rashadrahimzade/Smart-Viscosity-Measurement-and-Control-System-VYTRON/docs/mechanical/mechanical-design.md

# 📐 Mechanical Design & Fluid Dynamics

This directory contains the 3D CAD assemblies, STEP models, technical drawings, and fluid mechanics calculations for the VYTRON system.

## 1. Core Mechanical Features

### 3D CAD Modeling
- Full 3D assembly modeled and verified in **SolidWorks**.
- Neutral **STEP (.step)** format included for universal CAD cross-compatibility.

### Fluid Dynamics & Sealing System
- Hydrodynamic design strictly based on **Stokes' Law** for falling-ball viscometry.
- Wall-effect boundary correction factors integrated into system calibration.
- Custom-engineered sealing channels utilizing **NBR O-Rings** and **Viton (FKM)** seals for zero-leakage fluid containment and high chemical resistance.
