rashadrahimzade/Smart-Viscosity-Measurement-and-Control-System-VYTRON/docs/use-cases/academic-lab.md

# 🎓 Use Case: Academic Laboratories

Used in university and R&D laboratories for research, student experiments, and thesis studies.

## 1. Application Areas

| Usage Purpose | Description |
|---|---|
| Stokes' Law experiment | Demonstration of falling-ball viscometer principle |
| Viscosity-temperature relationship | Research on liquid viscosity change at different temperatures |
| Calibration study | System validation with reference fluids |
| Student project | Mechatronics, industrial engineering, chemical engineering experiments |

## 2. VYTRON Advantages

- **Open code and open hardware**: All firmware, CAD, and schematic files are modifiable and learnable.
- **Dual-MCU architecture**: Arduino Mega and Nano communication is ideal for teaching embedded systems to students.
- **TÜBİTAK 2209-A support**: Suitable reference system for academic projects.
- **Bilingual (TR/EN)**: Turkish and English interface, usable in international environments.
- **Low cost**: Suitable for university budgets.

## 3. Limitations

- Data logging (SD card / PC connection) is not yet available; manual note-taking required.
- No factory calibration certificate; user must perform own calibration.

## 4. Related Files

- `docs/getting-started.md` — Initial setup and first run
- `docs/assembly-guide.md` — Mechanical assembly
- `docs/software/software-architecture.md` — Software architecture
- `docs/cfd/cfd-analysis.md` — Flow analysis (reference for research)
