rashadrahimzade/Smart-Viscosity-Measurement-and-Control-System-VYTRON/docs/use-cases/food-industry.md

# 🍯 Use Case: Food Industry

The VYTRON falling-ball viscometer can be used in the food industry for viscosity control of liquids and semi-liquids.

## 1. Application Areas

| Product | Important Viscosity Range | Why Important |
|---|---|---|
| Olive oil | ~30–100 cP | Quality classification and storability |
| Honey | ~2000–10000 cP | Liquefaction rate and adulteration detection |
| Syrup | ~100–1000 cP | Concentration and filling speed control |
| Sauces (ketchup, mayonnaise) | ~500–5000 cP | Flow behavior and packaging |
| Milk and dairy products | ~1–10 cP | Concentration and quality |

## 2. VYTRON Advantages

- **NBR O-ring and Viton gasket**: Food-contact parts are chemically compatible and leak-proof.
- **Bilingual interface (TR/EN)**: English interface provides advantage for exporting companies.
- **Temperature control**: Heater and DS18B20 allow measuring liquid at desired temperature (food viscosity is highly temperature-sensitive).
- **Low cost**: Suitable price for small and medium-sized food businesses.

## 3. Limitations

- Food-contact parts may require food-grade material certification.
- All parts must comply with food industry hygiene standards (HACCP, etc.).

## 4. Related Files

- `docs/calibration.md` — Reference fluid calibration
- `docs/safety.md` — Heater and 220V safety
- `docs/mechanical/mechanical-bom.md` — Gaskets and sealing materials
