rashadrahimzade/Smart-Viscosity-Measurement-and-Control-System-VYTRON/docs/use-cases/pharma.md

# 💊 Use Case: Pharmaceutical Industry

Viscosity is used in drug formulations (syrups, gels, creams, suspensions) for dosage and stability control.

## 1. Application Areas

| Product | Viscosity Range | Importance |
|---|---|---|
| Drug syrups | ~100–1000 cP | Filling speed and dosage |
| Gel creams | ~1000–10000 cP | Spreadability and stability |
| Suspensions | ~500–5000 cP | Liquefaction and homogeneity |

## 2. VYTRON Advantages

- **Precise temperature control**: Drug viscosity is highly temperature-sensitive; measurement can be performed at target temperature.
- **Open calibration**: Can be calibrated with reference drug solutions to obtain repeatable results.
- **Language support**: Turkish interface, easy to use for local laboratories.
- **Low cost**: Suitable price for small-scale pharmaceutical R&D laboratories.

## 3. Limitations

- Compliance with GMP (Good Manufacturing Practices) standards may require additional documentation and validation.
- All contact surfaces must be made of drug-compatible materials.

## 4. Related Files

- `docs/calibration.md` — Reference fluid calibration
- `docs/safety.md` — Heater safety
- `docs/bom/bom-index.md` — Material list
