rashadrahimzade/Smart-Viscosity-Measurement-and-Control-System-VYTRON/Mechanical/CFD_Analysis/Force Report - Data.xlsx

Column1 | Column2 | Column3 | Column4 | Column5 | Column6 | Column7
Forces - Direction Vector (0 0.939693 0.34202)
Zone | Forces [N] Pressure | Forces [N] Viscous | Forces [N] Total | Coefficients Pressure | Coefficients Viscous | Coefficients Total
bilye | 8932811 | 21721961 | 11105007 | 14584181 | 35464426 | 18130624
Net | 8932811 | 21721961 | 11105007 | 14584181 | 35464426 | 18130624
