rashadrahimzade/Smart-Viscosity-Measurement-and-Control-System-VYTRON/docs/tubitak/sonuc-raporu.md

# 📄 TÜBİTAK 2209-A Result Report

This folder contains the result report prepared within the scope of the TÜBİTAK 2209-A University Students Research Projects Support Program.

## 📎 File

| File | Description |
|---|---|
| `1919B012431971_Sonuc_Raporu.pdf` | TÜBİTAK 2209-A result report (PDF) |

> **Note:** The PDF file (`1919B012431971_Sonuc_Raporu.pdf`) is available in this repository.

## 🔗 Related Links

- [TÜBİTAK 2209-A Program Page](https://www.tubitak.gov.tr/tr/fon/bireysel-ve-kurumsal-burslar/2209-a-universite-ogrencileri-arastirma-projeleri-destekleme-programi)
- Project Article: [`docs/tubitak/makale.md`](./makale.md)
- Article (Publisher Site): [lubricant-world.com](https://lubricant-world.com/tribology-applications-a-mechatronics-assisted-approach-to-traditional-viscometers/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)

## 📜 License

This report is protected under the "All Rights Reserved" terms specified in `LICENSE.txt`. Unauthorized copying or distribution is prohibited.
