rashadrahimzade/Smart-Viscosity-Measurement-and-Control-System-VYTRON/Mechanical/Mechanical Calculations/12.pdf

### 2.3 Mukavemet hesapları 2.3.1 Mil Makine Elemanın Mukavemet Kontrolü

Genel pazar araştırmalarının ve malzeme mekanik özellikleri incelemelerinin sonucunda mil malzemesi olarak mukavemet ve hafiflik bakımından daha avantajlı bir malzeme olan Alüminyum 7075 T6 alaşımı seçilmiştir. Söz konusu mil malzemesinin teknik özellikleri Tablo 2.’de verilmiştir. Milimiz her iki tarafından yataklanmıştır ve kuvvet Milin tam orta noktasından etki etmektedir. Kuvvetin büyüklüğü ise F = 38.26 N olarak hesaplanmıştır. Mile etki eden kuvvet ve mile ait boyutlar Şekil 28.’de verilmiştir.

Tablo 2. Mil Malzemesinin Özelikleri (Al 7075 T6)

Malzeme Özelliği | Büyüklük
Elastisite Modülü | 71.7 Gpa
Kayma Modülü | 26.9 Gpa
Poisson Oranı | 0.33
Akma Dayanımı | 60Mpa
Yoğunluğu | 2.81 g/cm³
Çekme Dayanımı | 572Mpa

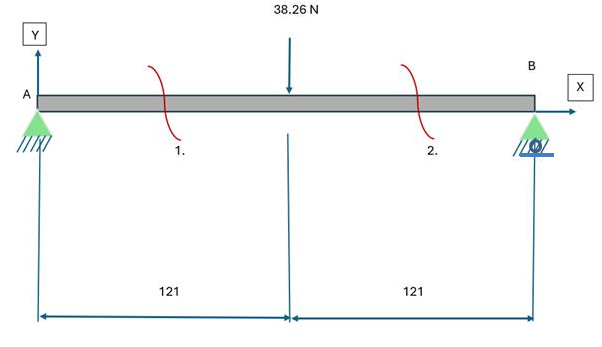
[picture p8: figure]

Şekil 29. Mil Üzerine Gelen Kuvvetler ve Mesnetler.

Analitik çözümde malzeme homojen, malzeme Hooke yasasına uyduğu, malzeme izotropik özellikte olduğu kabul edilmiştir. Newton’ un birinci yasası uygulandığında, mesnet kuvvetleri aşağıdaki gibi hesaplanır.
ΣFx = 0 => Ax + Bx = 0
ΣFy = 0 => Ay + By − 38.26 = 0 => Ay + By = 38.26 N
ΣMA = 0 => 38.26 ∗ 121 − By ∗ 242 = 0
=> By = 19.13 N
Ay = 19.13N

Mesnet tepki kuvvetleri bu şekilde bulunmuş olundu. Sistemde eksenel kuvvet bulunmamaktadır. Tek tek kesit aldığımız zaman her bir bölgedeki kuvvet, moment değerleri aşağıda ayrı ayrı hesaplanmıştır. Mildeki kesme kuvveti ve tepki kuvvetleri için bölgesel inceleme yapılmıştır. Mil bölgesel olarak kestiğimizde, tek tek kesit aldığımız zaman her bir bölgedeki kuvvet, moment değerleri aşağıda ayrı ayrı hesaplanmıştır (Şekil 29-31). Ayrıca MTV diyagramları da Şekil 32.’de verilmiştir.

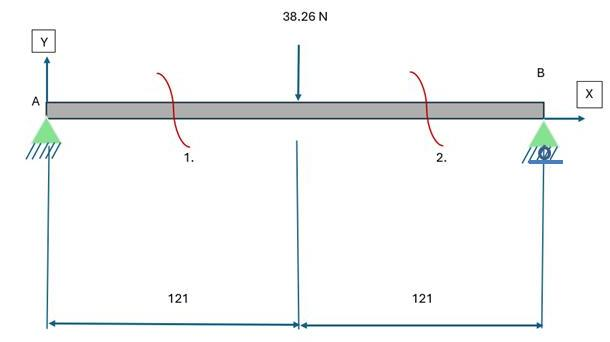
[picture p9: figure]

Şekil 30. Kesit Alınmış Mesnet Görseli.

### 1. Kesitin (0 ≤ x ≤ 121) İncelenmesi

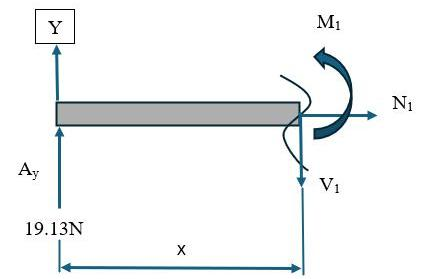
[picture p10: figure]

Şekil 31. 1 nolu Kesitin İncelenmesi.

Newton’un Birinci Yasası Uygulandığında;

ΣFx = 0 => N1 = 0
ΣFy = 0 => Ay = V1 = 19.13 N
ΣMx = 0 => Ay ∗ x − M1 = 0 => => M = 19.13x
x = 0 => M1 = 0
x = 121 => M1 = 2314.73 Nmm

Kesitin (250 ≤ x ≤625) İncelenmesi

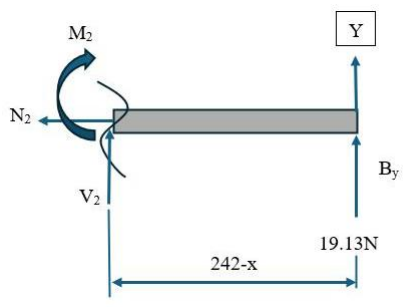
[picture p11: figure]

Şekil 32. 2 nolu Kesitin İncelenmesi.

Newton’un İkinci Yasası Uygulandığında;

ΣFx = 0 => N2 = 0
ΣFy = 0 => By + V2 = 0
=> V2 = −19.13N
ΣMx = 0 => M2 − By ∗ (242 − x) = 0 => M2 = 19.13 ∗ (242 − x) M2 = 4629.46 − 19.13 ∗ x
x = 121 => M2 = 2314.73 Nmm
x = 242 => M2 = 0 Nmm

MTV Diyagramı ise:

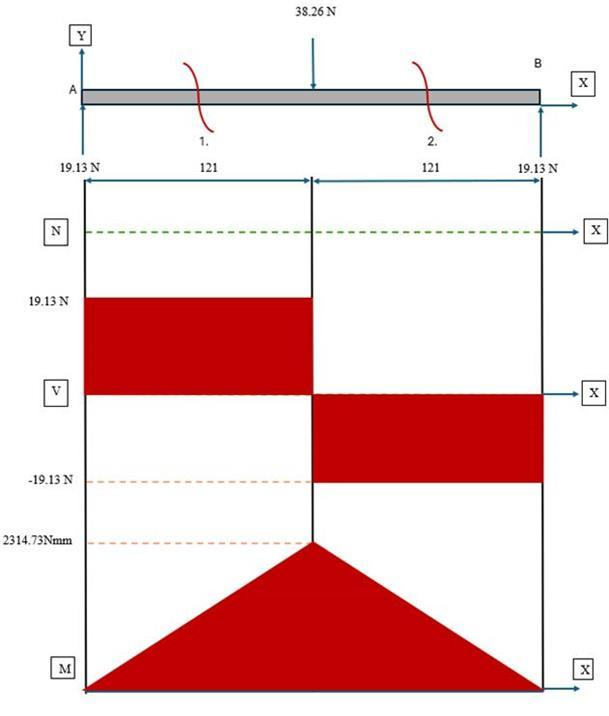
[picture p12: figure]

Şekil 33. MTV diyagramının gösterilişi.

Çizilen MTV diyagramında Mmax = 2314.73 Nmm ve Vmax = 19.13 N olduğu görülmektedir. Md momenti ise motordan gelen momenttir ve 2443 Nmm olarak alınmıştır. Bu değerler göz önünde bulundurularak milin emniyet hesabı yapılacaktır. Mil malzemesi olarak AL 7075 T6 alaşımı alındı. Bu alaşımın akma dayanımı değeri σakma= 60 MPa olarak alındı. Emniyet katsayısı S = 2 seçildi.(Tablo 3.)

Tablo 3. Emniyet Katsayısının Seçilmesi. [10]

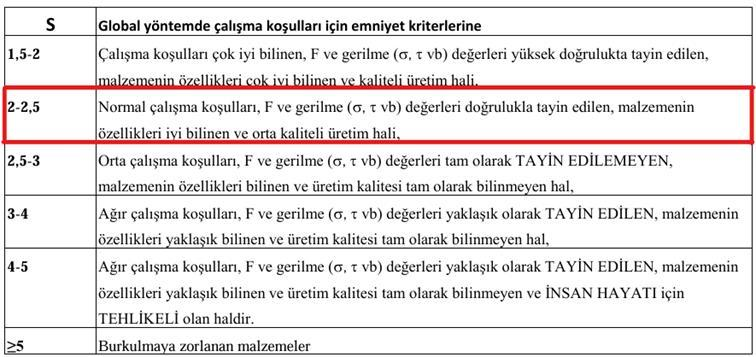
[picture p13: figure]

Milde oluşan eğilme ve kesme gerilmesi hesaplandıktan sonra bileşik gerilme ise

σeğilme =

Me
We

=

Me
π ∗ d

3
32

=

2314.73
π ∗ 12³
32

= 13.64 MPa

τkesme =

V
A

=

19.13
π ∗ 12²
4

= 0.17 MPa

τb =

Md
Wb

=

2443
π ∗ 12³
16

= 7.2 MPa

σem =

σak
S

=

60
2

= 30 MPa

σem = √σ
2 + 3 ∗ τ

2

σem = √13.64² + 3 ∗ (7.2 + 0.17)
2 = 18.68 MPa

şeklinde hesaplandıktan sonra 18.68 MPa < 30 MPa olduğu için Emniyetlidir. [10]

### 2.3.2 Rulman Hesabı

Projede mili desteklemek için UCP201 tipi rulman kullanılmıştır. UCP201 Rulman Özellikleri; Dökme demir gövde, kromlu çelik rulman, UCP201 model ve 12 mm mil

çapında olup 2 cıvatalı sabitlenerek montaj yapılmıştır (Şekil 33). Rulmanda iki taraflı yağ keçesi olan sızıdırmazlık eleman kullanılmıştır. Rulman ait teknik özellikler Tablo

4.’te verilmiştir.

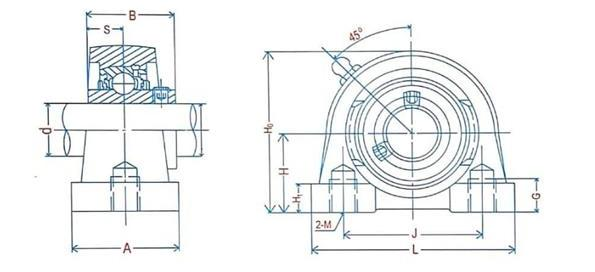
[picture p14: figure]

Şekil 34. UCP201 Rulman Teknik Resmi.

Tablo 4. UCP201 Rulman Özellik Tablosu. [10]

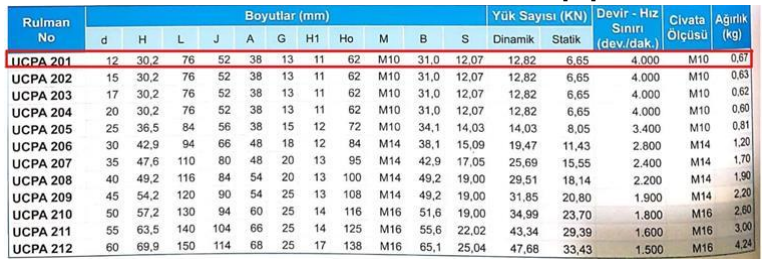
[picture p15: figure]

Hesaplarda kullanılacak büyüklükler Tablo 4’ ten C = 12.8 kN, C0 = 6.65 kN, Fe = 0 (Eksenel kuvvet bulunmuyor.) olarak seçilmiştir.

Fr
2

= Fra = Frb = 19.13N

Bilyeli için P = 3

L = (

C
F

)

P

L = (

12800
19.13 )

3
= 299560811.8 milyon devir

Lℎ =

10⁶

60∗n

(

C
F

)

P
n (devir) = 306.9 devir/dakika olarak alınmıştır.

=> Lℎ =

10⁶
∗ 2999560811.8
60 ∗ 306.9

= 1.626 ∗ 10¹⁰ çalışma saati

Hesaplamalar sonucunda UCP201 rulmanın proje için oldukça uygun olduğu görülmüştür. [10]

### 2.4 Tahrik Gücü Hesaplamaları 2.4.1 Motor Seçimi

Hesaplamalar statik durum üzerinden yapılacaktır. Mil malzemesi olarak Al 7075 T6 alaşımı seçilmişti. Bu alaşımın akma dayanımı değeri σakma=60 MPa olarak seçilmiştir. Hesaplarda bu değer kullanılacaktır. Tablo 3.’ten S = 2 seçilmiştir.
Eğilme gerilmesi;

σemax =

Me
We

σemax =

F ∗ L
π ∗ d

3
32

σemax =

38.26 ∗ 121
π ∗ 12³
32

= 27.28 MPa

σem =

σak
S

σem =

60
2

= 30 MPa

σem = √σ
2 + 3 ∗ τ

2

σem

2 = σ

2 + 3 ∗ τ

2

τ

2 =

σem

2 − σ

2
3
τ = √
σem

2 − σ

2
3
τ = √
30² − 27.28²
3

= 7.2 MPa

τem =

Md
Wb

=

Md
π ∗ d

3
16

=> Md = τem ∗

π ∗ d

3
16 = 7.2 ∗

π ∗ 12³
16 = 2.443 NmMd = 9550 ∗

N
n
n = 306.9 RPM seçilmiştir.

2.443 = 9550 ∗

N
n
=> N = 78.5 W

Bu güç ve döndürme momentine uygun olan motor olarak Nema 34 motor seçilmiştir[10]. Motora ait teknik özellikler Tablo 5.’te verilmiştir.
