rashadrahimzade/Smart-Viscosity-Measurement-and-Control-System-VYTRON/docs/images/Comparative Viscosity-Temperature Curve.png

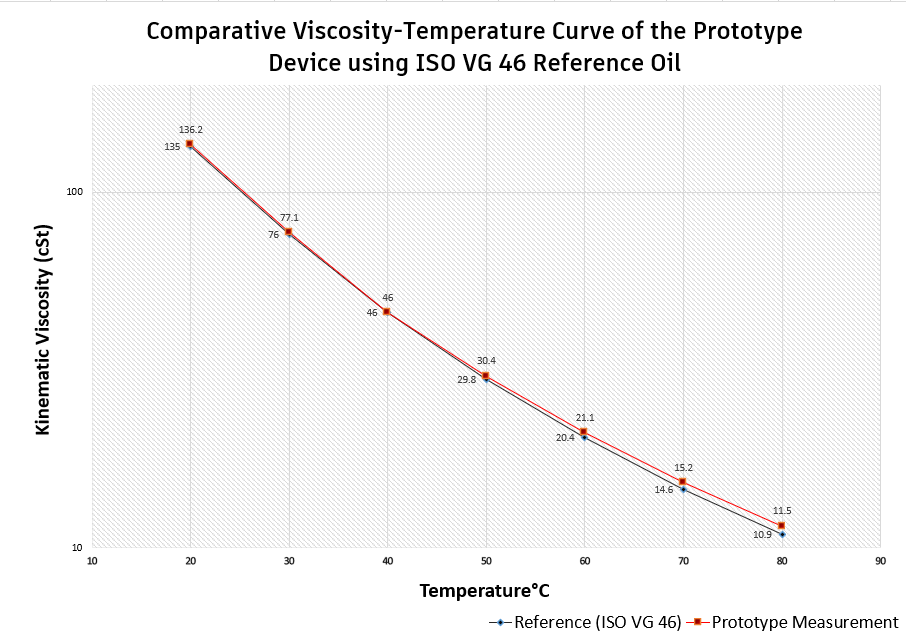
docs/images/Comparative Viscosity-Temperature Curve.png
