rashadrahimzade/Smart-Viscosity-Measurement-and-Control-System-VYTRON/docs/images/Do not touch sign.jpeg

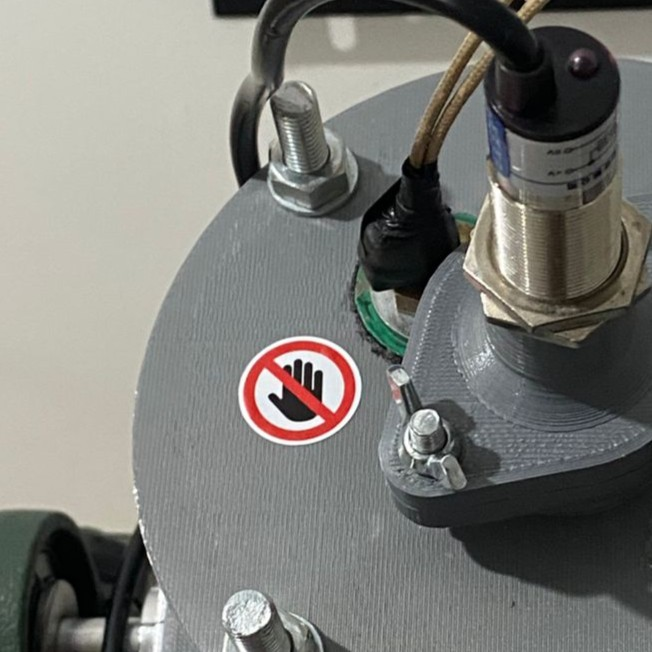
docs/images/Do not touch sign.jpeg
