rashadrahimzade/Smart-Viscosity-Measurement-and-Control-System-VYTRON/docs/images/Drag_Force_Convergence_Monitor.jpg

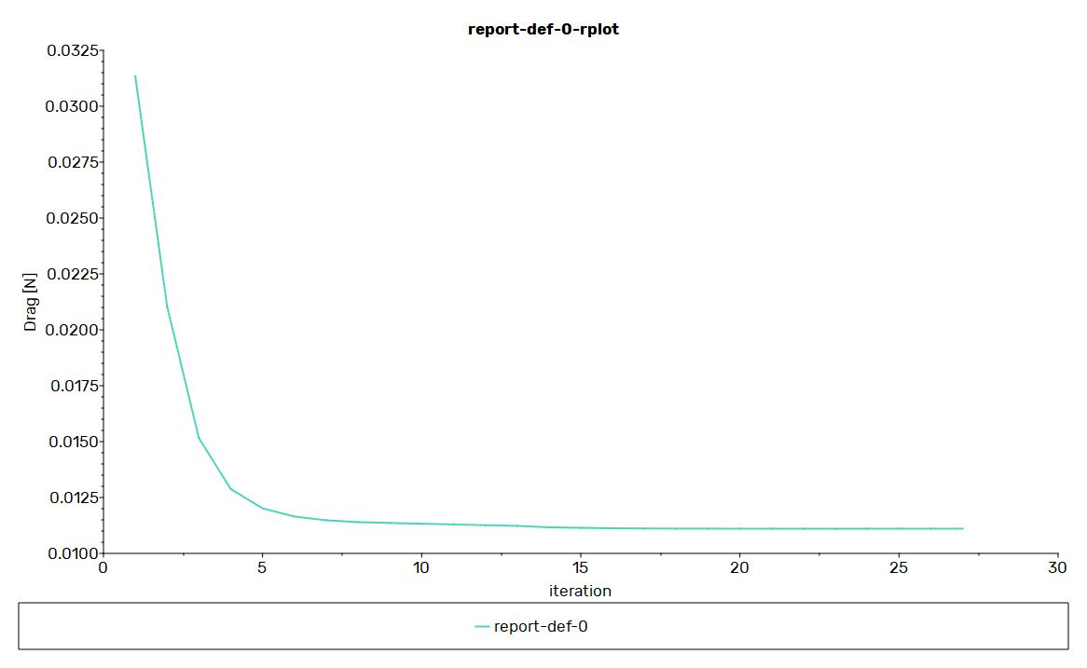
docs/images/Drag_Force_Convergence_Monitor.jpg
