rashadrahimzade/Smart-Viscosity-Measurement-and-Control-System-VYTRON/docs/images/Ladenburg Factor Calculations-1.png

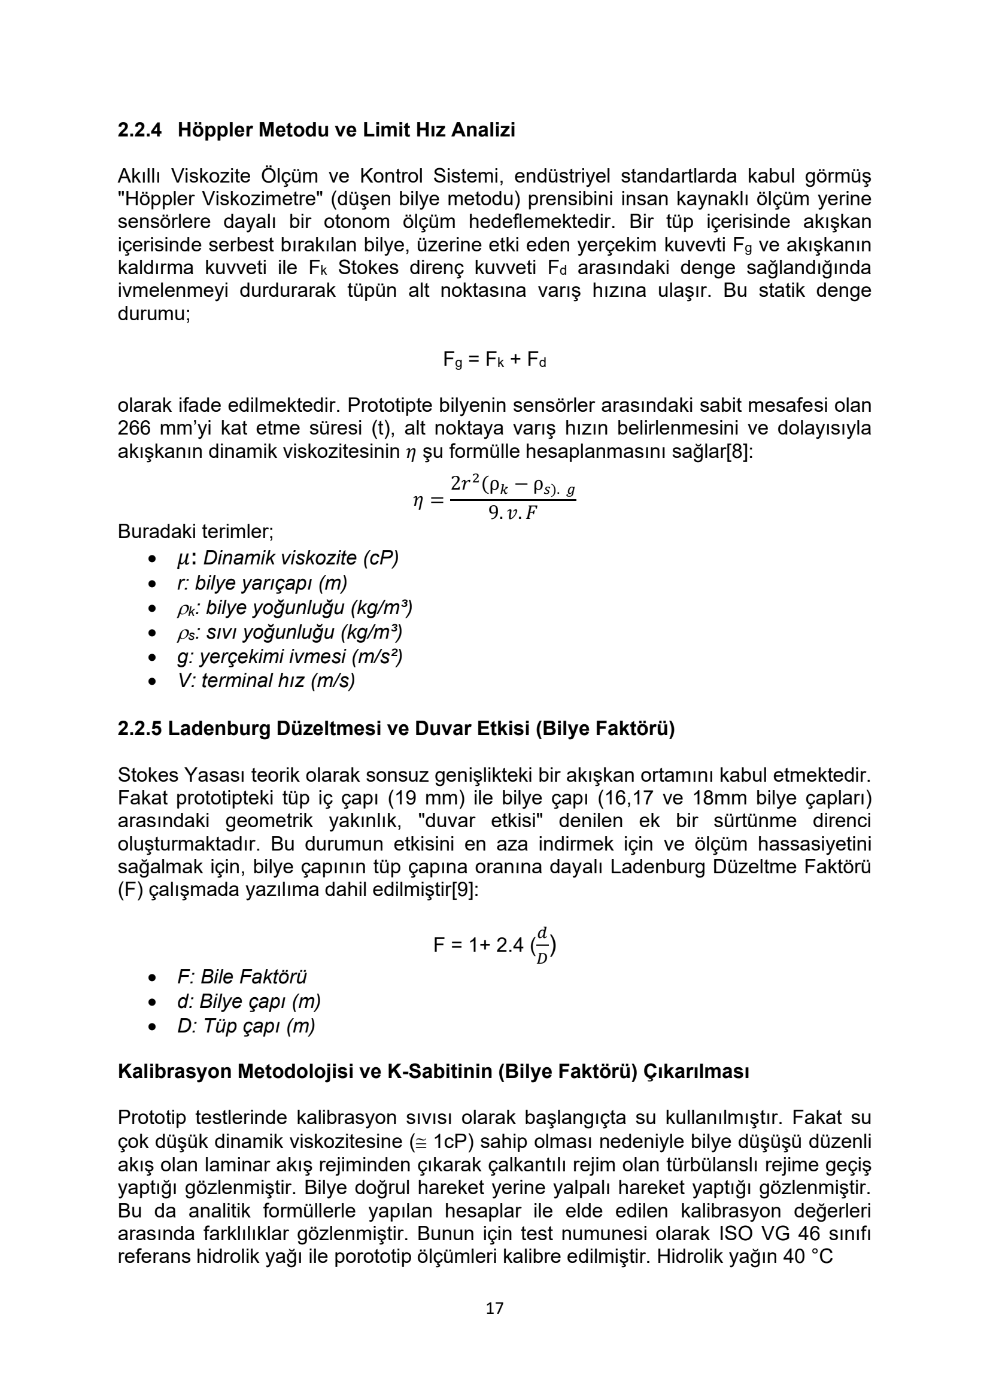
docs/images/Ladenburg Factor Calculations-1.png
