rashadrahimzade/Smart-Viscosity-Measurement-and-Control-System-VYTRON/docs/images/Laminar_Flow_Continuous_Pathlines.png

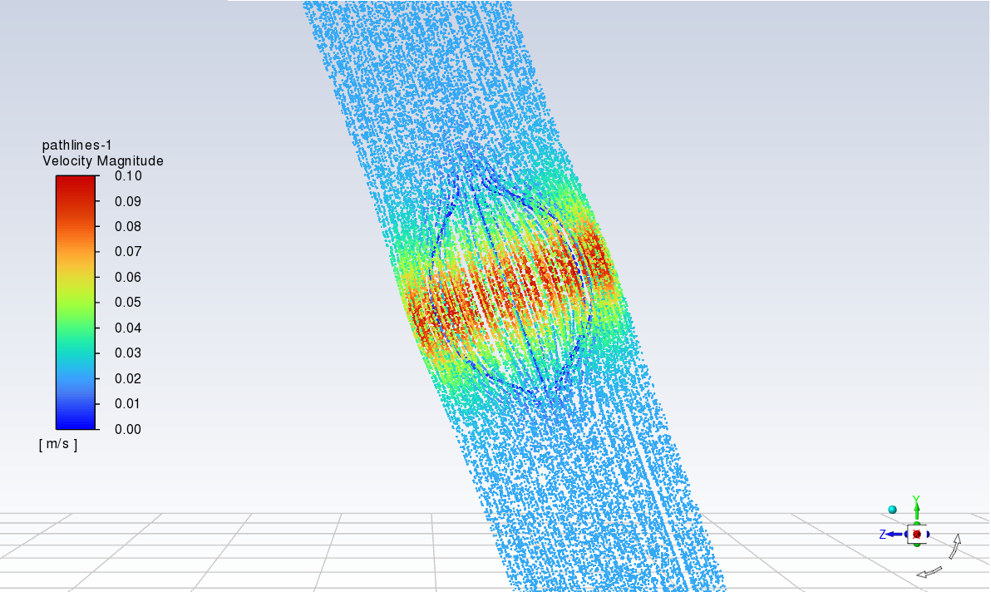
docs/images/Laminar_Flow_Continuous_Pathlines.png
