rashadrahimzade/Smart-Viscosity-Measurement-and-Control-System-VYTRON/docs/images/Pathline Coloured.png

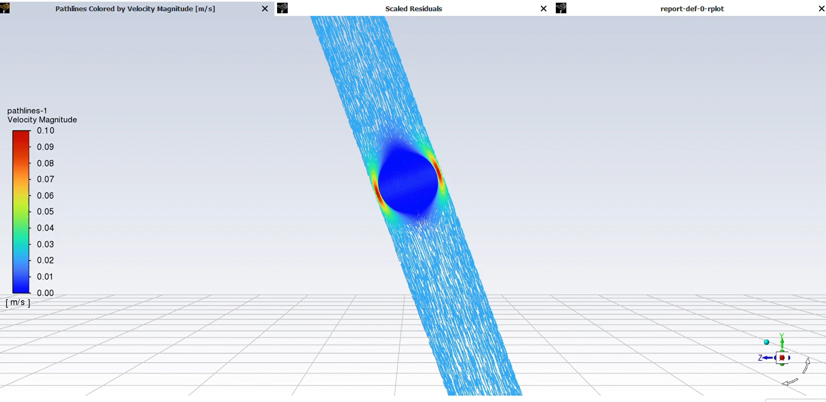
docs/images/Pathline Coloured.png
