rashadrahimzade/Smart-Viscosity-Measurement-and-Control-System-VYTRON/docs/images/Solver_Scaled_Residuals.jpg

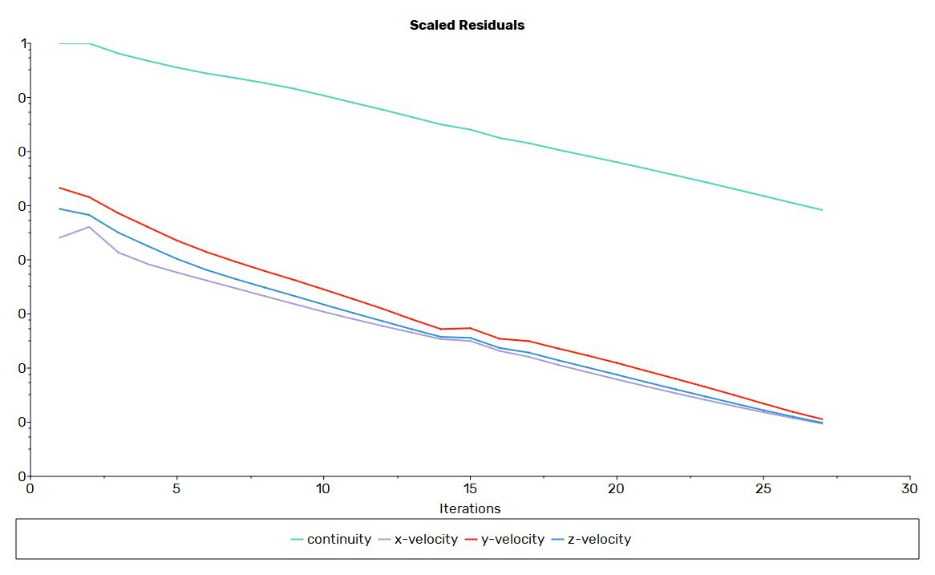
docs/images/Solver_Scaled_Residuals.jpg
