rashadrahimzade/Smart-Viscosity-Measurement-and-Control-System-VYTRON/docs/images/Static_Pressure_Distribution_CFD.jpg

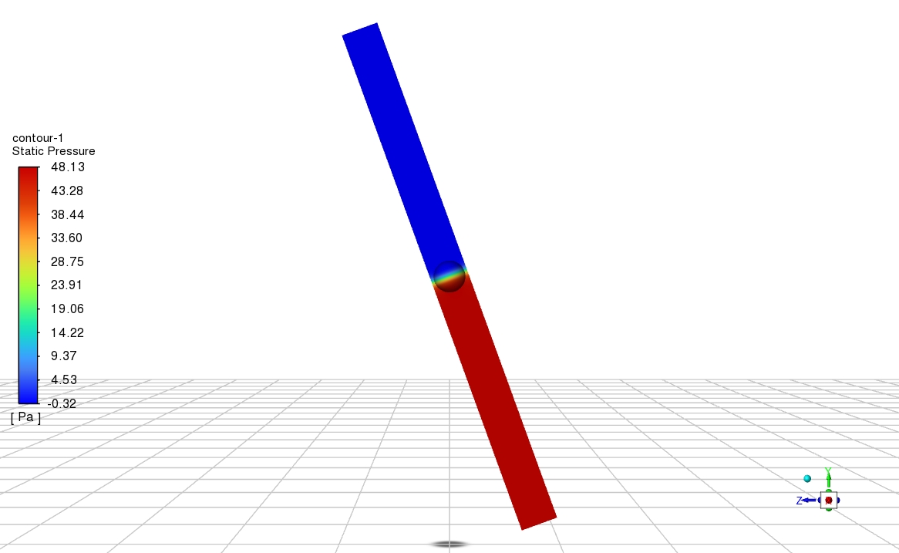
docs/images/Static_Pressure_Distribution_CFD.jpg
