rashadrahimzade/Smart-Viscosity-Measurement-and-Control-System-VYTRON/Electronics/Detail_of_Parts/Electronic Control Unit.jpeg

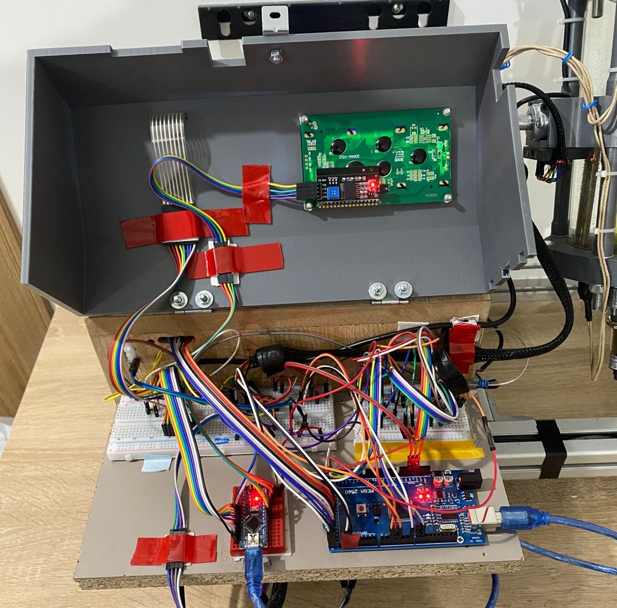
Electronics/Detail_of_Parts/Electronic Control Unit.jpeg
