rashadrahimzade/Smart-Viscosity-Measurement-and-Control-System-VYTRON/Electronics/Interference_Mitigation/4.7K Resistance on Heater circuit.png

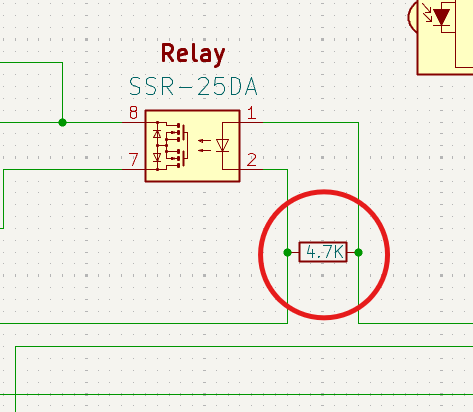
Electronics/Interference_Mitigation/4.7K Resistance on Heater circuit.png
