rashadrahimzade/Smart-Viscosity-Measurement-and-Control-System-VYTRON/Electronics/Interference_Mitigation/Aluminyum Shielded Cable.jpeg

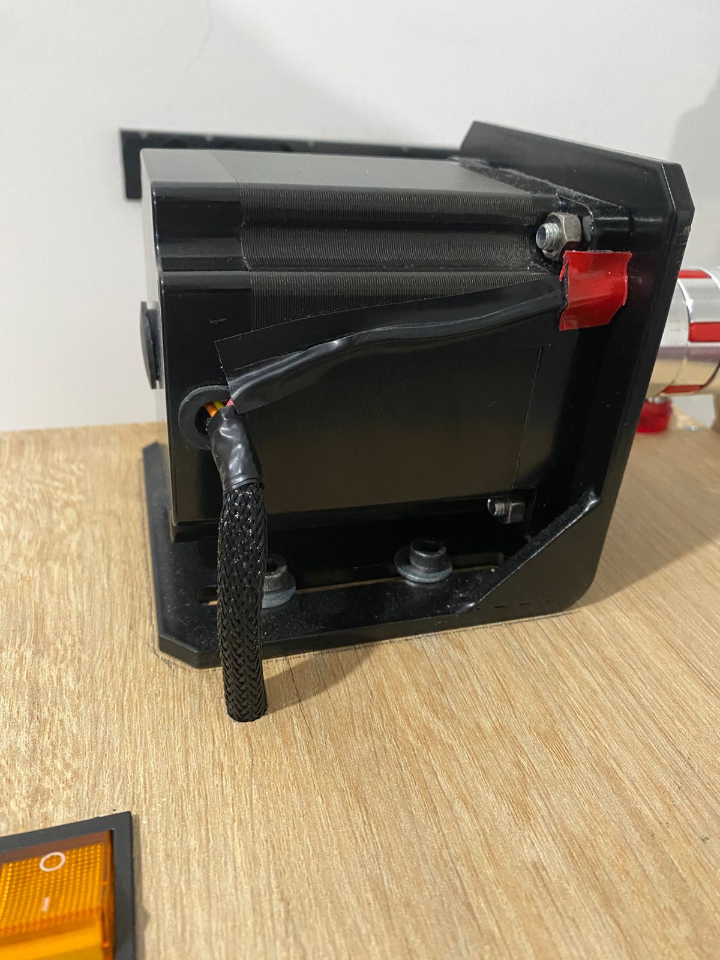
Electronics/Interference_Mitigation/Aluminyum Shielded Cable.jpeg
