rashadrahimzade/Smart-Viscosity-Measurement-and-Control-System-VYTRON/Electronics/Interference_Mitigation/Aluminyum Shielded Cablo on IMU.jpeg

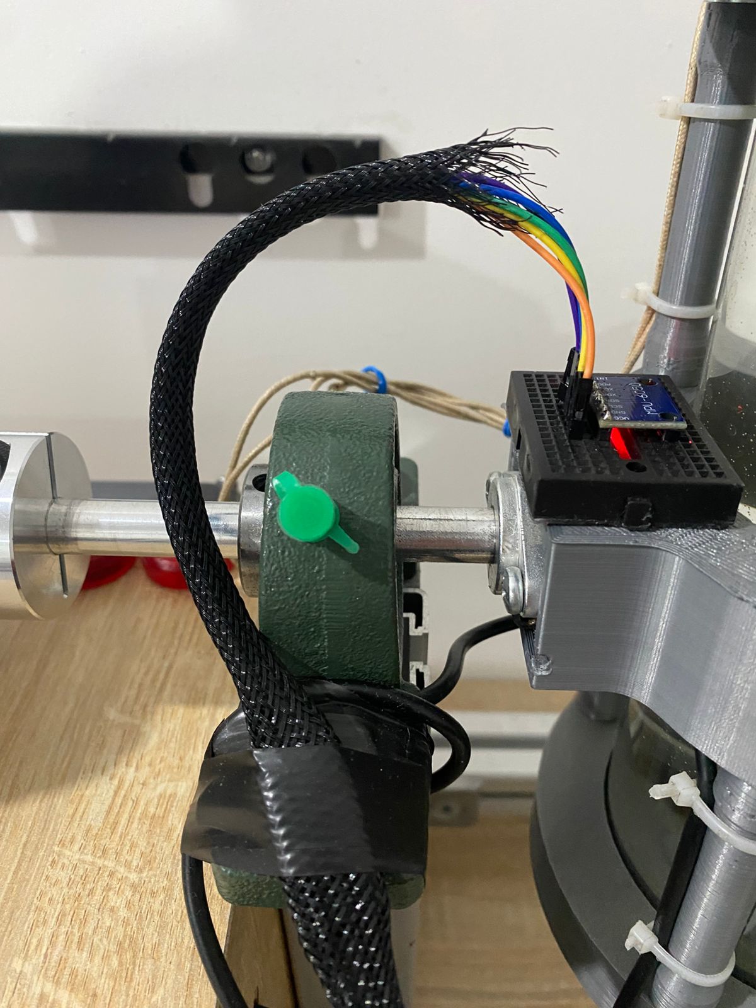
Electronics/Interference_Mitigation/Aluminyum Shielded Cablo on IMU.jpeg
