rashadrahimzade/Smart-Viscosity-Measurement-and-Control-System-VYTRON/Electronics/Interference_Mitigation/Ferrite core application on the MPU-6050 sensor and aluminum shielded cabling..jpeg

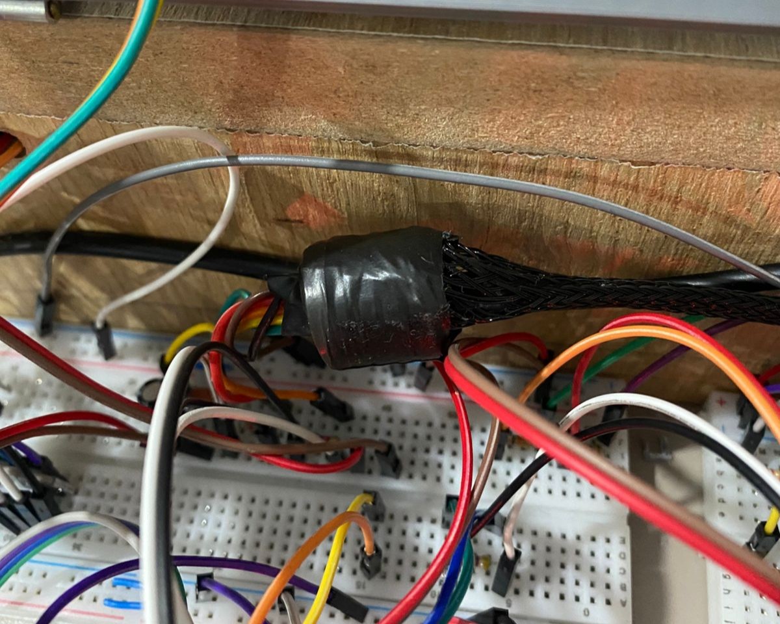
Electronics/Interference_Mitigation/Ferrite core application on the MPU-6050 sensor and aluminum shielded cabling..jpeg
