rashadrahimzade/Smart-Viscosity-Measurement-and-Control-System-VYTRON/docs/bom/files/README.md

# 📁 Excel Files

Add your actual BOM (material list) Excel files to this folder.

> **Note:** File names may differ from the example below. Please update the links in `docs/bom/bom-index.md` if your file names are different.

| File | Description | Location |
|---|---|---|
| `BOM_Electronic_VYTRON.xlsx` | Electronic parts BOM | `docs/bom/files/BOM_Electronic_VYTRON.xlsx` |
| `BOM_Mechanic_VYTRON.xlsx` | Mechanical parts BOM | `docs/bom/files/BOM_Mechanic_VYTRON.xlsx` |

**Price note:** All prices in the Excel files are **VAT included, May 2026 prices**.
