rashadrahimzade/Smart-Viscosity-Measurement-and-Control-System-VYTRON/docs/bom/electronics-bom.md

# ⚡ Electronic Material List (BOM)

For the detailed electronic parts list, see the Excel file in `docs/bom/files/`:

- **File:** `BOM_Electronic_VYTRON.xlsx`
- **Location:** `docs/bom/files/BOM_Electronic_VYTRON.xlsx`
- **Price note:** VAT included, May 2026 prices

## 📎 Related Files

- KiCad Schematic: `Electronics/Smart Viscosity Measurement and Control System.kicad_sch`
- EMI/RFI Guide: `docs/electronics/interference-mitigation.md`
- Wiring Guide: `docs/wiring-guide.md`
