rashadrahimzade/Smart-Viscosity-Measurement-and-Control-System-VYTRON/docs/bom/mechanical-bom.md

# 🔩 Mechanical Material List (BOM)

For the detailed mechanical parts list, see the Excel file in `docs/bom/files/`:

- **File:** `BOM_Mechanic_VYTRON.xlsx`
- **Location:** `docs/bom/files/BOM_Mechanic_VYTRON.xlsx`
- **Price note:** VAT included, May 2026 prices

## 📎 Related Files

- Technical Drawings: `Mechanical/Techincal_Drawing/`
- 3D CAD Models: `Mechanical/3D Model/`
- Assembly Guide: `docs/assembly-guide.md`
- CFD Analysis: `docs/cfd/cfd-analysis.md`
