rashadrahimzade/Smart-Viscosity-Measurement-and-Control-System-VYTRON/docs/bom/bom-index.md

# 📦 Bill of Materials (BOM) - General Overview

This page contains a high-level summary of all materials required for the VYTRON system. For detailed part numbers, suppliers, and notes, see the sub-pages.

## 🔗 Sub-sections

| Section | Description | File |
|---|---|---|
| **Electronic Materials** | Arduino, sensors, motor, driver, screen, relay, cables | `docs/electronics/electronics-bom.md` |
| **Mechanical Materials** | CAD parts, gaskets, screws, glass tube, mounting parts | `docs/mechanical/mechanical-bom.md` |

## 📁 Excel Files

Actual part lists (Excel) are located in the `docs/bom/files/` folder:

| File | Description | Location |
|---|---|---|
| `BOM_Electronic_VYTRON.xlsx` | Detailed list of electronic parts | `docs/bom/files/BOM_Electronic_VYTRON.xlsx` |
| `BOM_Mechanic_VYTRON.xlsx` | Detailed list of mechanical parts | `docs/bom/files/BOM_Mechanic_VYTRON.xlsx` |

> **Price note:** All prices in the Excel files are **VAT included, May 2026 prices**.

## 💰 Approximate Costs (Example)

> These figures are 2026 averages; they may vary by supplier, country, and quantity. Each BOM table contains its own subtotal; there is no grand total for the entire machine.

| Category | Description |
|---|---|
| Electronics | MCU, sensors, motor, driver, screen, relay, cables |
| Mechanical | Gaskets, screws, glass tube, mounting parts |

## 🛒 Shopping List Checklist

Confirm before placing an order:

- [ ] Are all electronic parts in stock?
- [ ] Are NBR O-ring and Viton gaskets suitable for the liquid?
- [ ] Is the 4.7K pull-up resistor added for DS18B20?
- [ ] Is the stepper motor flange/coupling suitable for the tube diameter?
- [ ] Is 220V insulation material (box, shielded cable) purchased?

## 📬 Notes

- Part numbers (MPN) and supplier information should be kept up to date in sub-pages.
- Prices are for reference only; contact the supplier for an official quote.
- This list is linked with `docs/pricing.md` (cost analysis).
