rashadrahimzade/Smart-Viscosity-Measurement-and-Control-System-VYTRON/docs/bom/files/BOM_Electronic_VYTRON.xlsx

Part | Count | Unit Price | Total Price | Function
MS-600-48 | 1 | ₺1400.00 | ₺1400.00 | Step Motor's Power Supply
PowerBank 5V 10000mAh | 1 | ₺180.00 | ₺180.00 | Microcontrollers' Power Supply
12V Adapter ~220V | 1 | ₺30.00 | ₺30.00 | Proximirt Sensors' Power Supply
EuroWatt 200W | 2 | ₺1452.00 | ₺2904.00 | Screw Plug Immersion Heater
Schneider 10-C | 1 | ₺250.00 | ₺250.00 | Short-Circuit & Overcurrent Protection
SSR-25DA | 1 | ₺110.00 | ₺110.00 | Heater Control Relay
Nema 34 | 1 | ₺2600.00 | ₺2600.00 | Step Motor
JSS-860H | 1 | ₺1850.00 | ₺1850.00 | Step Motor Driver
Arduino Mega 2560 | 1 | ₺900.00 | ₺900.00 | Main Microcontroller
Arduino Nano | 1 | ₺250.00 | ₺250.00 | Step Motor's Microcontroller
4x20 LCD | 1 | ₺216.00 | ₺216.00 | Step Motor's info LCD
ILI9341 TFT LCD | 1 | ₺266.00 | ₺266.00 | Main LCD
I2C/IIC Converter | 1 | ₺60.00 | ₺60.00 | Converter for 4x20 LCD
LJ18A3-8-Z/AX | 2 | ₺120.00 | ₺240.00 | Enductive Proximity Sensor
4x4 Keypad | 2 | ₺10.00 | ₺20.00 | Keypad
MPU-6050 | 1 | ₺135.00 | ₺135.00 | IMU for Rotational Position
DS18B20 | 1 | ₺150.00 | ₺150.00 | Waterproof Temeprature Sensor
Switch | 1 | ₺60.00 | ₺60.00 | Step Motor On/Off
BreadBoard 830 Pin | 1 | ₺135.00 | ₺135.00 | Arduino Mega BreadBoard
BreadBoard 400 Pin | 1 | ₺60.00 | ₺60.00 | Arduino Nano BreadBoard
BreadBoard 170 Pin | 1 | ₺30.00 | ₺30.00 | MPU-6050's BreadBoard
Terminal x8 | 1 | ₺10.00 | ₺10.00 | Proximirt Sensors Terminal 12VDC
Terminal x7 | 1 | ₺10.00 | ₺10.00 | ~220VAC Terminal
Terminal x3 | 1 | ₺10.00 | ₺10.00 | ~220VAC Safe Terminal
Aluminium Tape | 2 | ₺50.00 | ₺100.00 | Protective cover
Jumper 40 Pin | 4 | ₺60.00 | ₺240.00 | Jumper
Resistor 2.2K | 7 | ₺1.00 | ₺7.00 | Resistor
Resistor 3.3K | 5 | ₺1.00 | ₺5.00 | Resistor
Resistor 4.7K | 2 | ₺1.00 | ₺2.00 | Resistor
Resistor 10K | 2 | ₺1.00 | ₺2.00 | Resistor
Seramic Capasitor | 2 | ₺5.00 | ₺10.00 | Interference suppressor
Electrolytic Capasitor | 2 | ₺5.00 | ₺10.00 | Interference suppressor
Double-Sided Nano Mounting Tape | 2 | ₺50.00 | ₺100.00 | Mounting
Ferrite Core x5 | 1 | ₺30.00 | ₺30.00 | Interference suppressor
Fiber Cover 1xM | 2 | ₺10.00 | ₺20.00 | Cover
TOTAL PRICE |  |  | $12402.00
