rashadrahimzade/Smart-Viscosity-Measurement-and-Control-System-VYTRON/docs/bom/files/BOM_Mechanic_VYTRON.xlsx

Parts | Count | Unit Price | Total Price
6063 Sigma Profile (3000mm) | 3 | ₺468.00 | ₺1404.00
DIN 7991 M8x20 Phosphate | 34 | ₺1.15 | ₺39.10
40x40 Flat Corner Bracket | 20 | ₺16.40 | ₺328.00
T-head M8 | 34 | ₺4.40 | ₺149.60
Wooden box | 7 Parts | ₺200.00 | ₺200.00
ABS Filament | 2 | ₺788.00 | ₺1576.00
M8 Threaded Rod 260mm | 4 | ₺50.00 | ₺200.00
M8 Nut | 12 | ₺2.00 | ₺24.00
M8 Flat Washer | 12 | ₺0.50 | ₺6.00
DIN 933 M10x40 Bolt | 4 | ₺3.00 | ₺12.00
DIN 933 M10x40 Nut | 4 | ₺3.00 | ₺12.00
DIN 912 M6x30 Bolt | 4 | ₺2.00 | ₺8.00
DIN 912 M6x30 Nut | 4 | ₺2.00 | ₺8.00
M5 Threaded Rod 40mm | 4 | ₺2.00 | ₺8.00
DIN 315 M5 Nut | 6 | ₺2.00 | ₺12.00
DIN 933 M5x25mm Bolt | 4 | ₺1.77 | ₺7.08
DIN 933 M5x25mm Nut | 4 | ₺1.77 | ₺7.08
DIN 965 M4 x 40 | 8 | ₺1.77 | ₺14.16
M4 Washer | 8 | ₺1.00 | ₺8.00
Nema 34 Stepper Motor Mounting Bracket | 1 | ₺251.00 | ₺251.00
GS19 Coupling - HRJ C40 | 1 | ₺670.00 | ₺670.00
UCP-201 Mounted Bearing | 2 | ₺215.00 | ₺430.00
SHF 12 Shaft Support | 2 | ₺62.00 | ₺124.00
Glass Tube Borosilicate 3.3 100x212mm | 1 | ₺1750.00 | ₺1750.00
Glass Tube Borosilicate 3.3 24x266mm | 1 | ₺250.00 | ₺250.00
KO-0329235 O-Ring | 2 | ₺5.00 | ₺10.00
KO-0234035 O-Ring | 2 | ₺5.00 | ₺10.00
Viton 95-100mm Sealing | 1 | ₺300.00 | ₺300.00
NBR Flat Washer Sealing | 4 | ₺1.00 | ₺4.00
Compressed Fiber Gasket | 4 | ₺2.00 | ₺8.00
Threaded Bushing | 1 | ₺150.00 | ₺150.00
AISI 52100 Steel Ball 16 mm | 1 | ₺60.00 | ₺60.00
AISI 52100 Steel Ball 17 mm | 1 | ₺60.00 | ₺60.00
AISI 52100 Steel Ball 18 mm | 1 | ₺60.00 | ₺60.00
6082 Aluminum Shaft 91mm | 1 | ₺120.00 | ₺120.00
6082 Aluminum Shaft 110 mm | 1 | ₺120.00 | ₺120.00
Control Panel Hinge | 2 | ₺90.00 | ₺180.00
TOTAL PRICE |  |  | ₺8580.02
