rashadrahimzade/Smart-Viscosity-Measurement-and-Control-System-VYTRON/Electronics/Detail_of_Parts/12 V Cable Distribution.jpeg

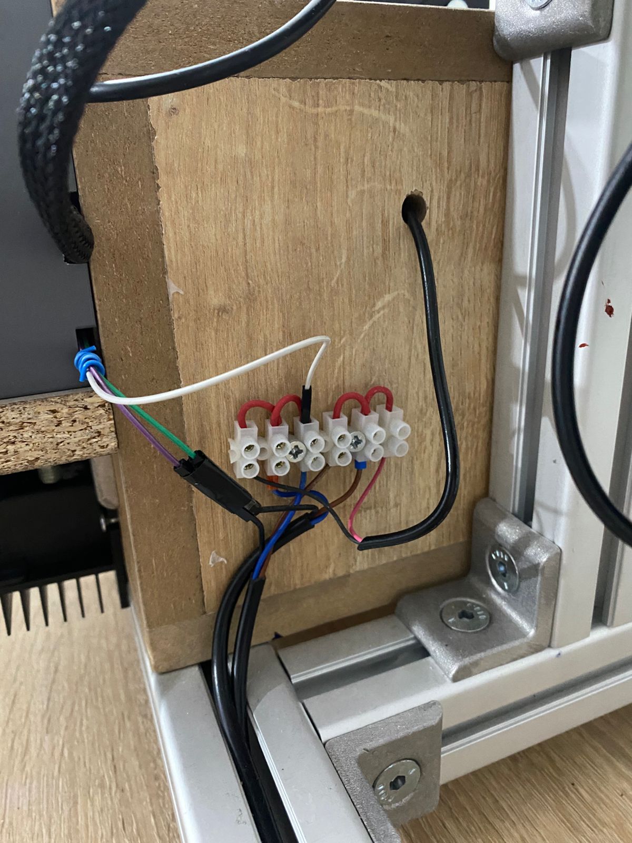
Electronics/Detail_of_Parts/12 V Cable Distribution.jpeg
