rashadrahimzade/Smart-Viscosity-Measurement-and-Control-System-VYTRON/Electronics/Detail_of_Parts/48V,12V supply and 10C FUSE .jpeg

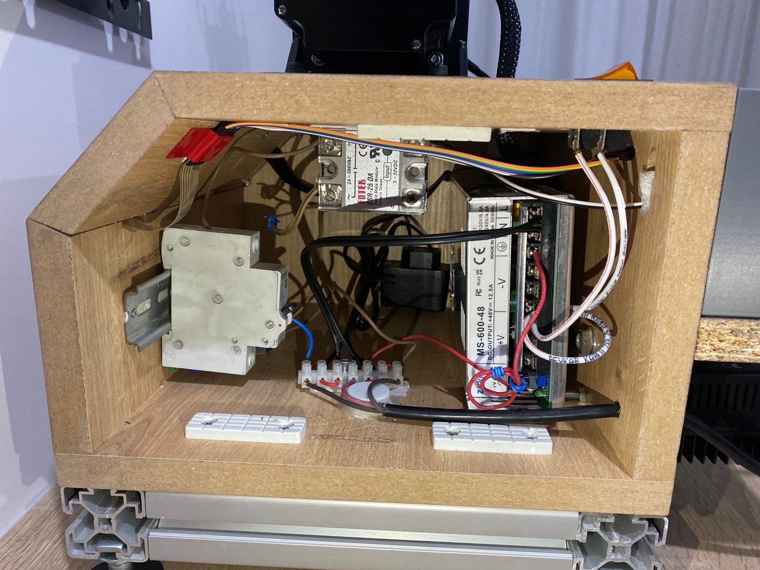
Electronics/Detail_of_Parts/48V,12V supply and 10C FUSE .jpeg
