rashadrahimzade/Smart-Viscosity-Measurement-and-Control-System-VYTRON/Electronics/Detail_of_Parts/220V 200W Heater.jpeg

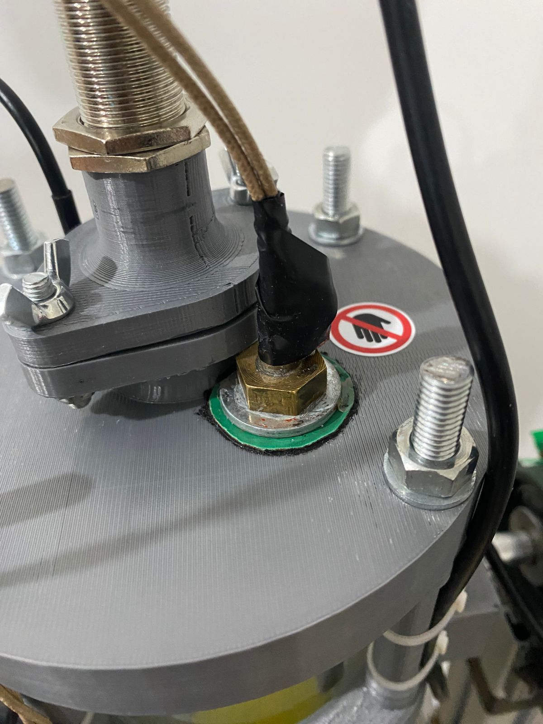
Electronics/Detail_of_Parts/220V 200W Heater.jpeg
