rashadrahimzade/Smart-Viscosity-Measurement-and-Control-System-VYTRON/Electronics/Detail_of_Parts/Control Panel.jpeg

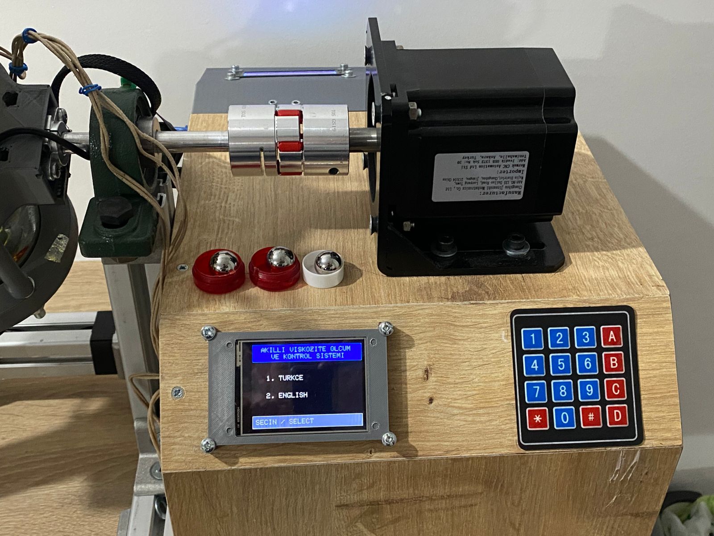
Electronics/Detail_of_Parts/Control Panel.jpeg
