rashadrahimzade/Smart-Viscosity-Measurement-and-Control-System-VYTRON/Electronics/Detail_of_Parts/Drain Fitting.jpeg

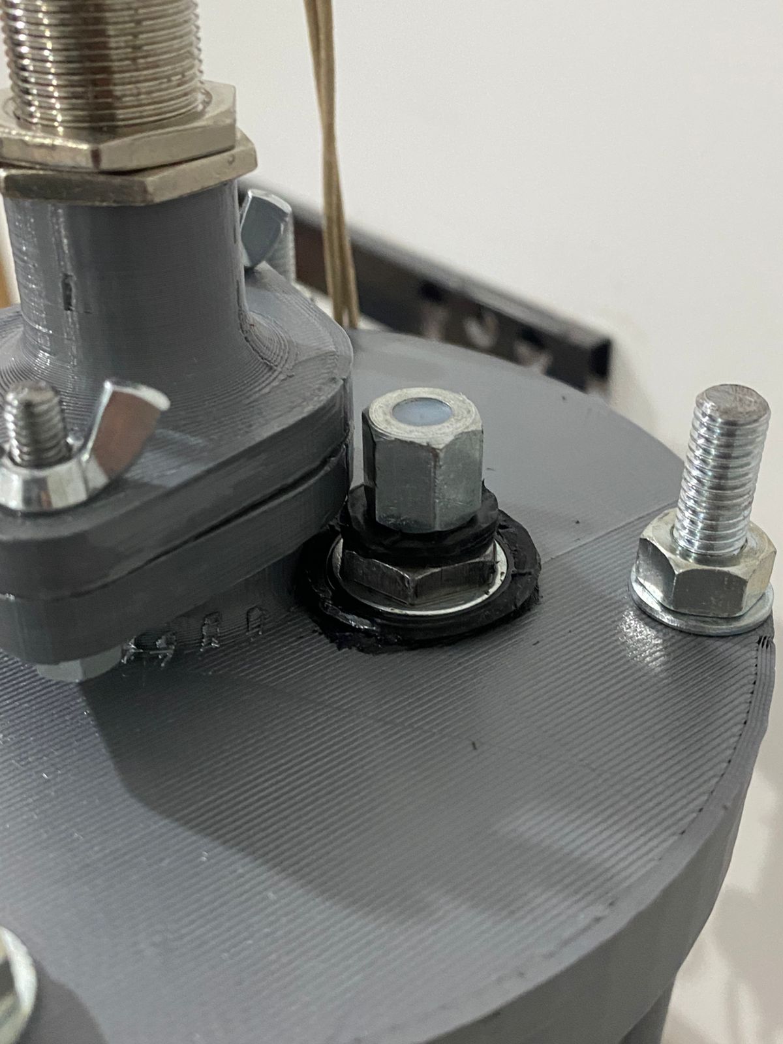
Electronics/Detail_of_Parts/Drain Fitting.jpeg
