rashadrahimzade/Smart-Viscosity-Measurement-and-Control-System-VYTRON/Electronics/Detail_of_Parts/DS18B20 Temperature sensor.jpeg

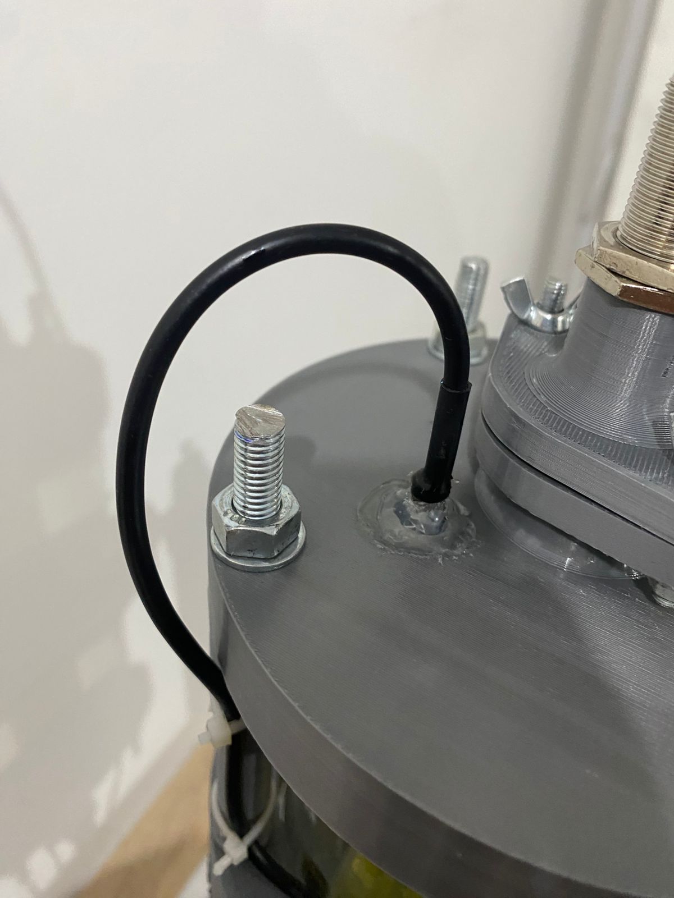
Electronics/Detail_of_Parts/DS18B20 Temperature sensor.jpeg
