rashadrahimzade/Smart-Viscosity-Measurement-and-Control-System-VYTRON/Electronics/Detail_of_Parts/Ferrite core application.jpeg

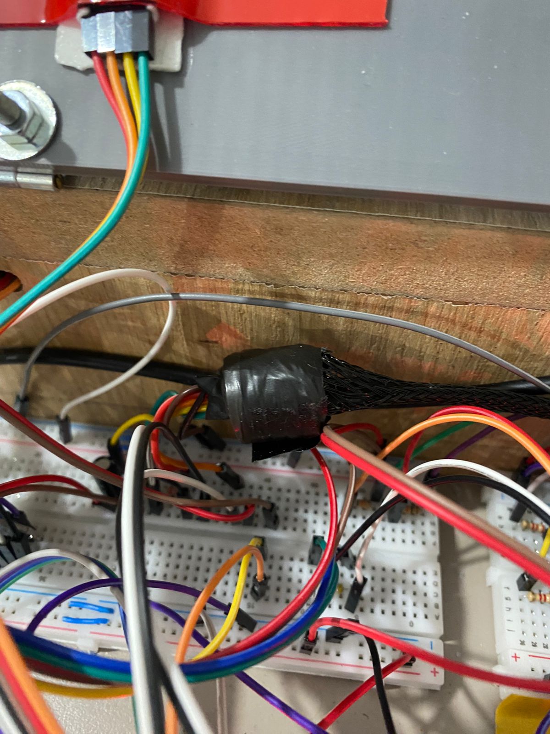
Electronics/Detail_of_Parts/Ferrite core application.jpeg
