rashadrahimzade/Smart-Viscosity-Measurement-and-Control-System-VYTRON/Electronics/Detail_of_Parts/Ferrite Core.jpeg

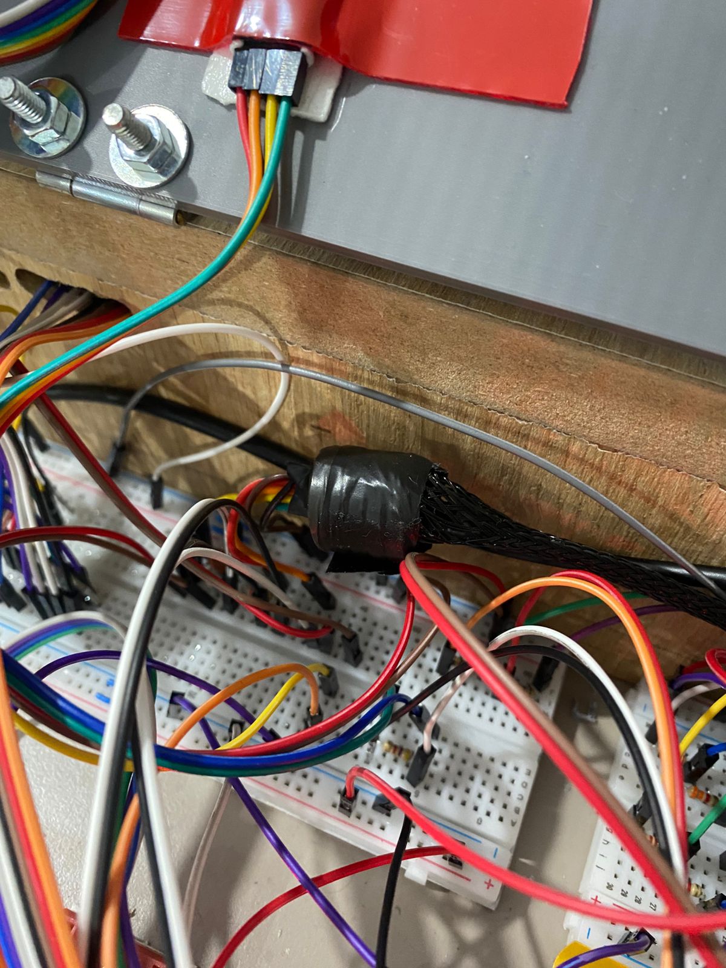
Electronics/Detail_of_Parts/Ferrite Core.jpeg
