rashadrahimzade/Smart-Viscosity-Measurement-and-Control-System-VYTRON/Electronics/Detail_of_Parts/Fluid Density.jpeg

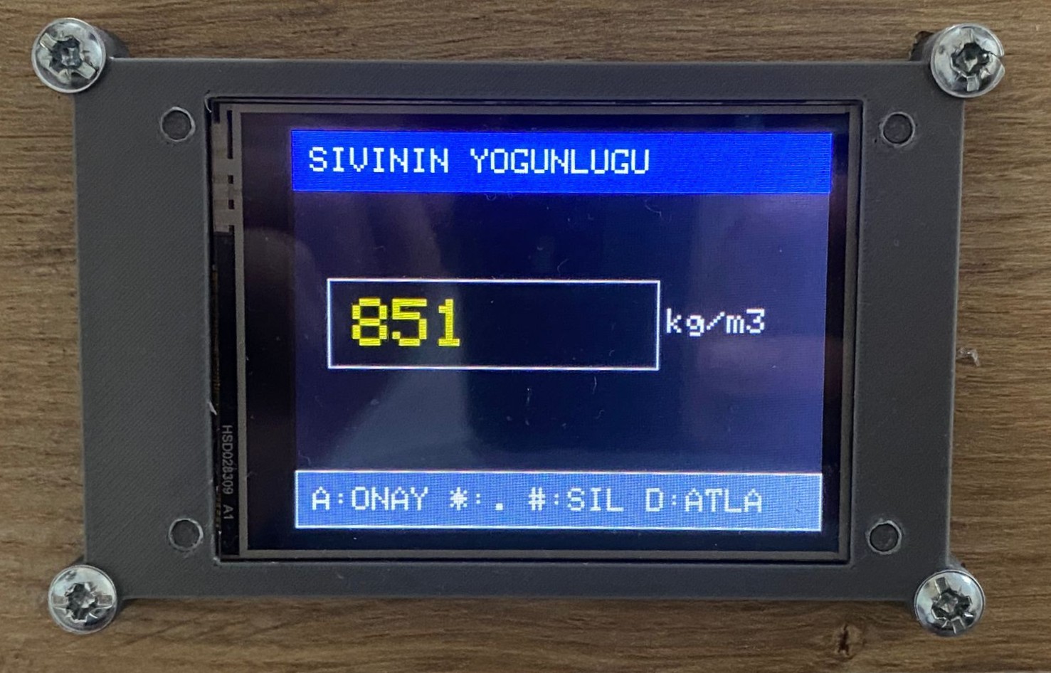
Electronics/Detail_of_Parts/Fluid Density.jpeg
