rashadrahimzade/Smart-Viscosity-Measurement-and-Control-System-VYTRON/Electronics/Detail_of_Parts/Heat manager.jpeg

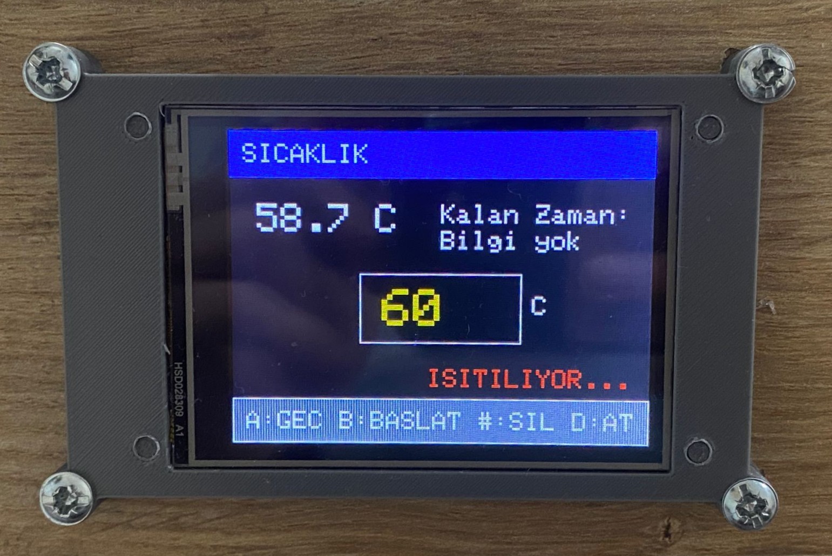
Electronics/Detail_of_Parts/Heat manager.jpeg
