rashadrahimzade/Smart-Viscosity-Measurement-and-Control-System-VYTRON/Electronics/Detail_of_Parts/HS-46 Oil and water.jpeg

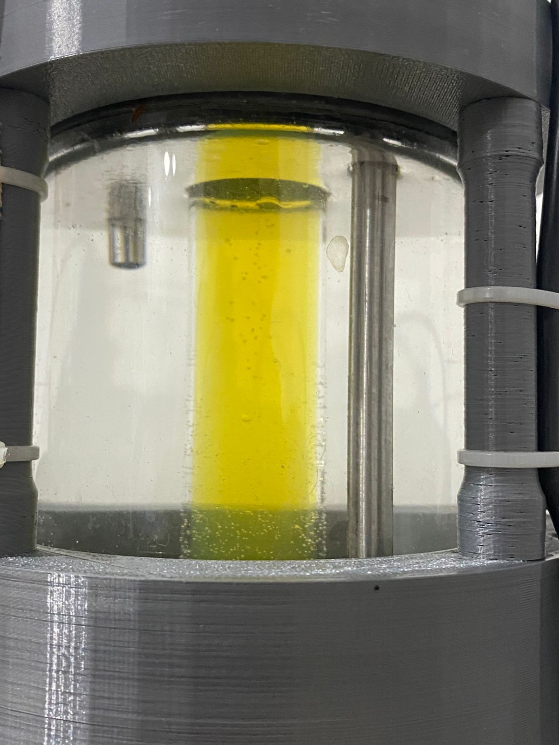
Electronics/Detail_of_Parts/HS-46 Oil and water.jpeg
