rashadrahimzade/Smart-Viscosity-Measurement-and-Control-System-VYTRON/Electronics/Detail_of_Parts/İMU logs.jpeg

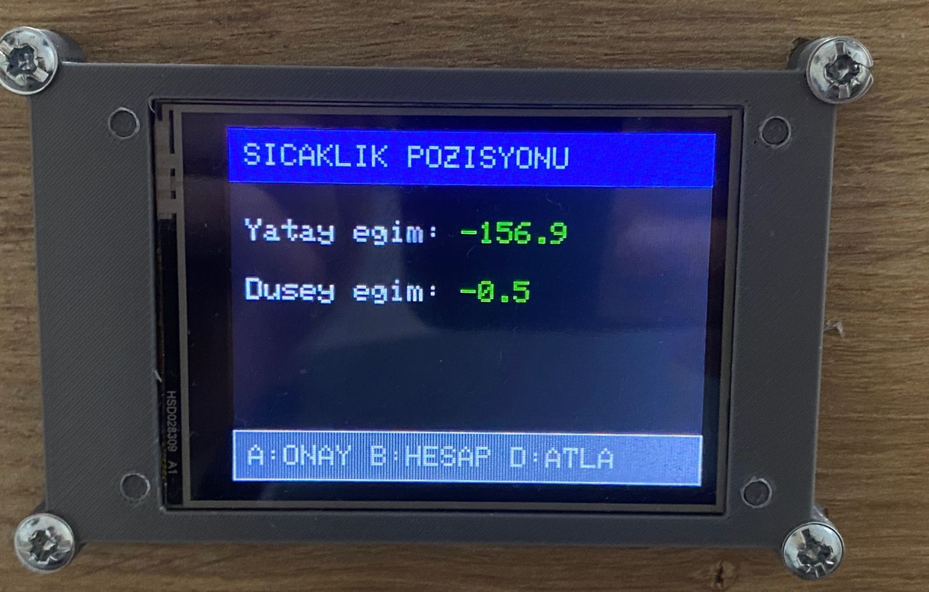
Electronics/Detail_of_Parts/İMU logs.jpeg
