rashadrahimzade/Smart-Viscosity-Measurement-and-Control-System-VYTRON/Electronics/Detail_of_Parts/İMU sensor.jpeg

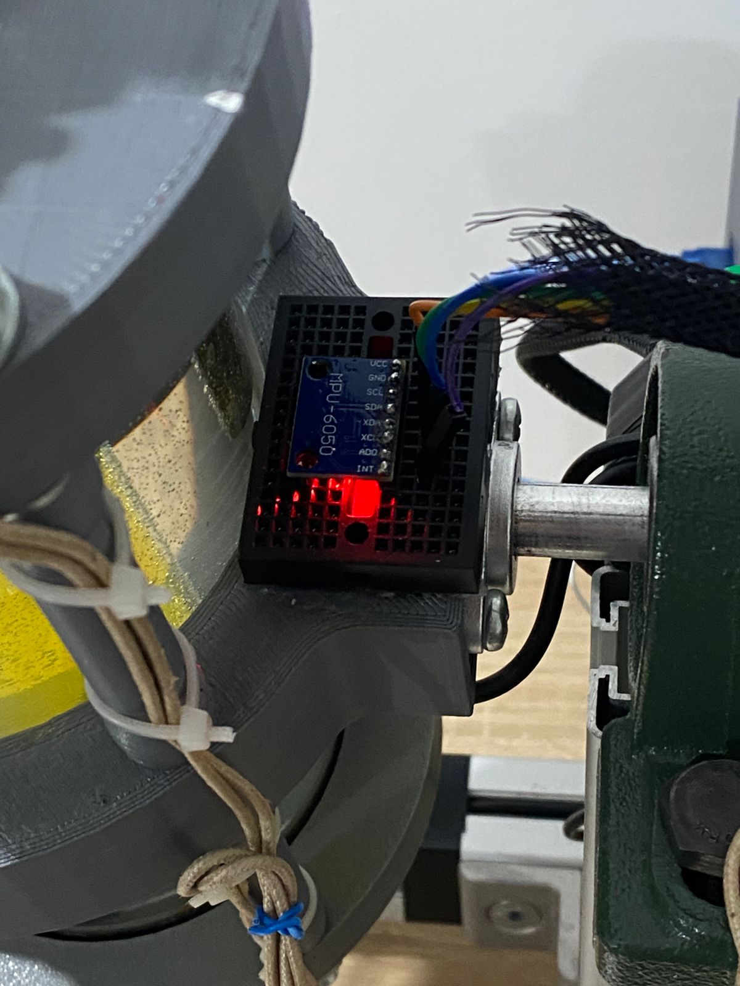
Electronics/Detail_of_Parts/İMU sensor.jpeg
