rashadrahimzade/Smart-Viscosity-Measurement-and-Control-System-VYTRON/Electronics/Detail_of_Parts/JSS-860 driver and 5V Power Supply.jpeg

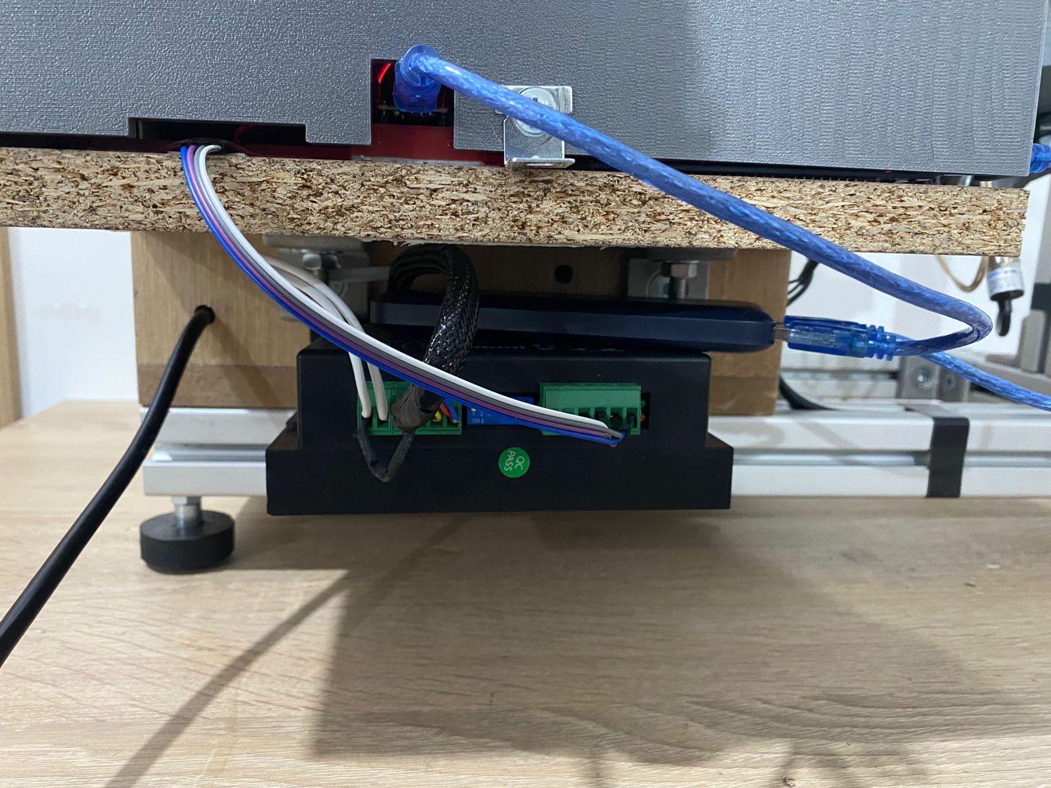
Electronics/Detail_of_Parts/JSS-860 driver and 5V Power Supply.jpeg
