rashadrahimzade/Smart-Viscosity-Measurement-and-Control-System-VYTRON/Electronics/Detail_of_Parts/Login Screen.jpeg

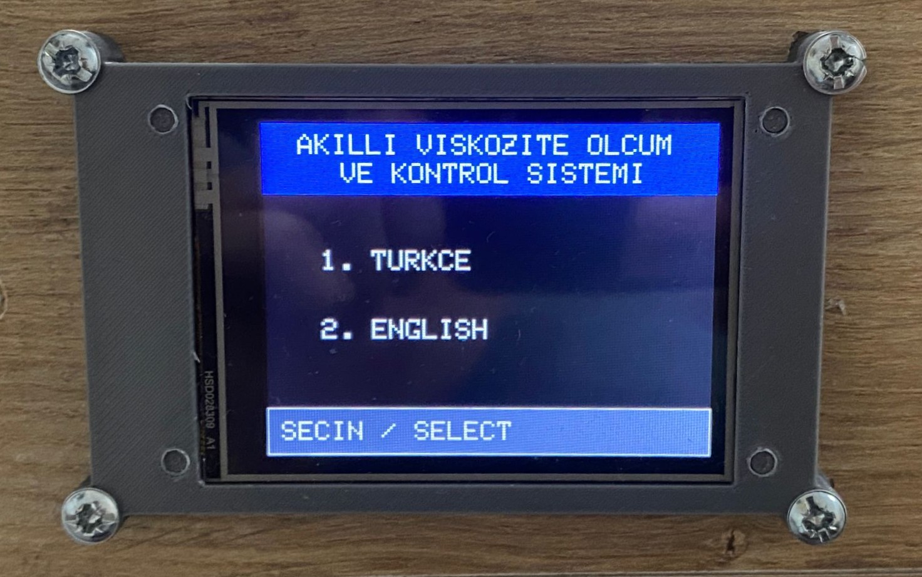
Electronics/Detail_of_Parts/Login Screen.jpeg
