rashadrahimzade/Smart-Viscosity-Measurement-and-Control-System-VYTRON/Electronics/Detail_of_Parts/Mega and Nema.jpeg

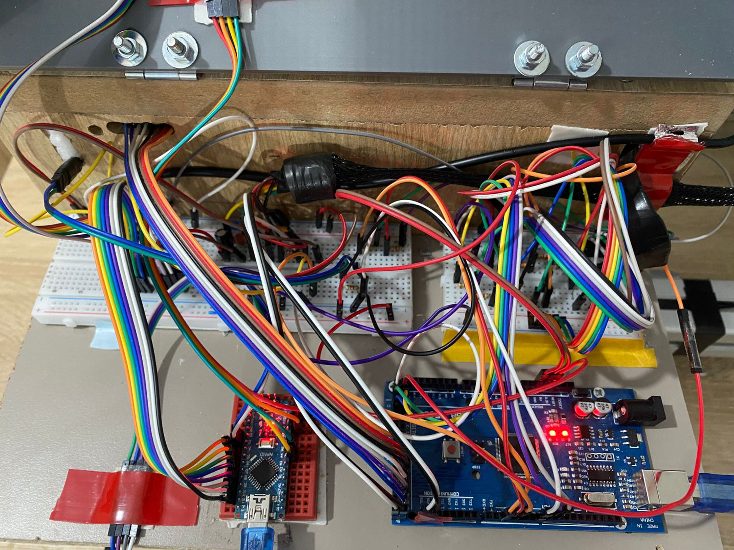
Electronics/Detail_of_Parts/Mega and Nema.jpeg
