rashadrahimzade/Smart-Viscosity-Measurement-and-Control-System-VYTRON/Electronics/Detail_of_Parts/NBR O-RIngs and drain fitting.jpeg

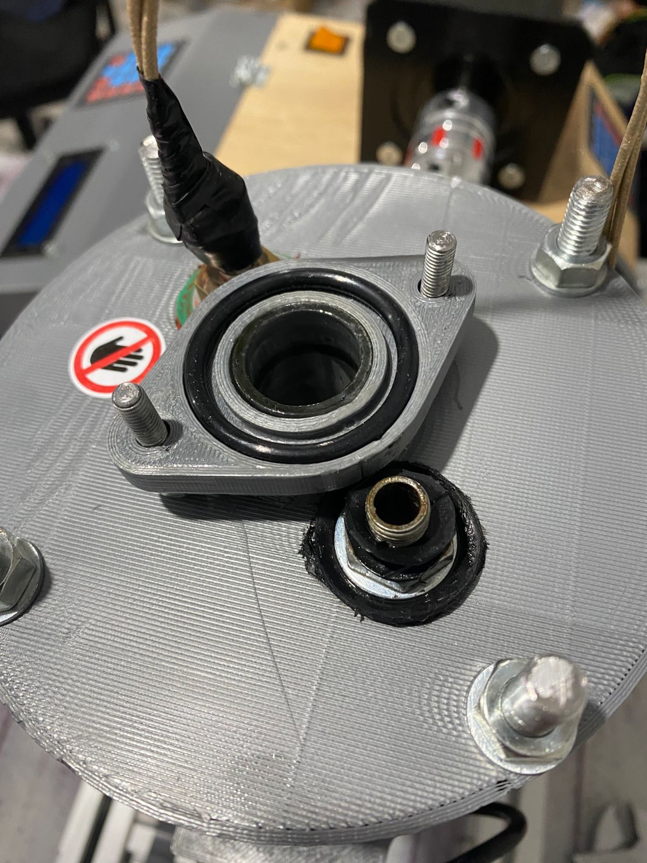
Electronics/Detail_of_Parts/NBR O-RIngs and drain fitting.jpeg
