rashadrahimzade/Smart-Viscosity-Measurement-and-Control-System-VYTRON/Electronics/Detail_of_Parts/Prototype2.jpeg

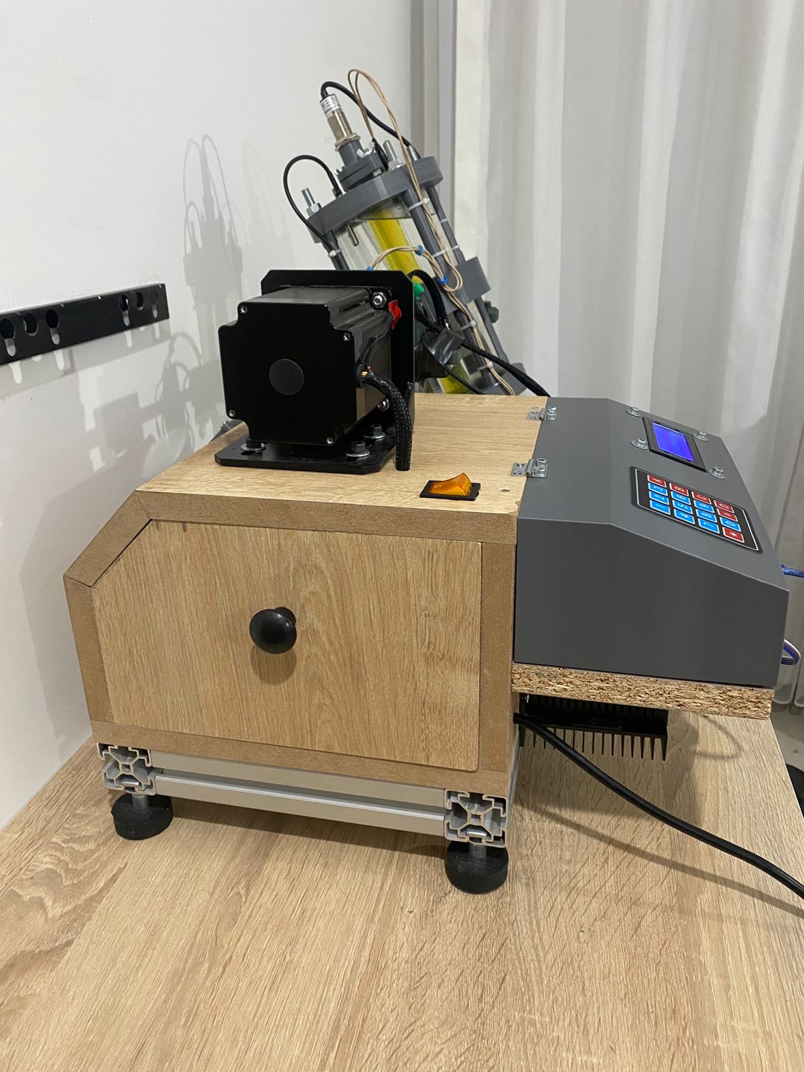
Electronics/Detail_of_Parts/Prototype2.jpeg
