rashadrahimzade/Smart-Viscosity-Measurement-and-Control-System-VYTRON/Electronics/Detail_of_Parts/Proximity sensor, Heater and temperature sensor.jpeg

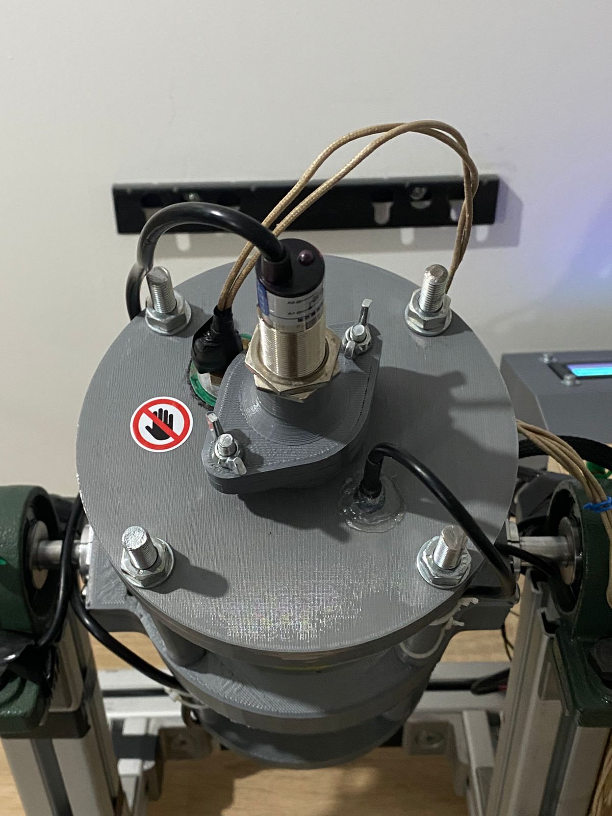
Electronics/Detail_of_Parts/Proximity sensor, Heater and temperature sensor.jpeg
