rashadrahimzade/Smart-Viscosity-Measurement-and-Control-System-VYTRON/Electronics/Detail_of_Parts/Steel Ball types.jpeg

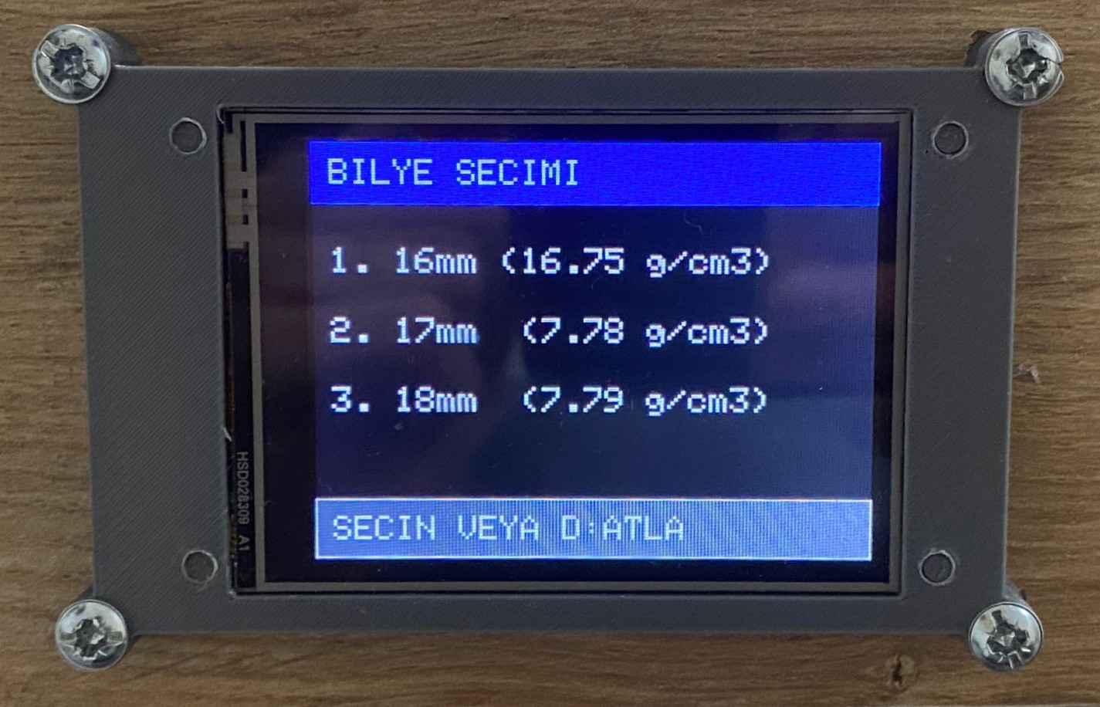
Electronics/Detail_of_Parts/Steel Ball types.jpeg
