rashadrahimzade/Smart-Viscosity-Measurement-and-Control-System-VYTRON/Mechanical/3D Model/Cover.SLDPRT

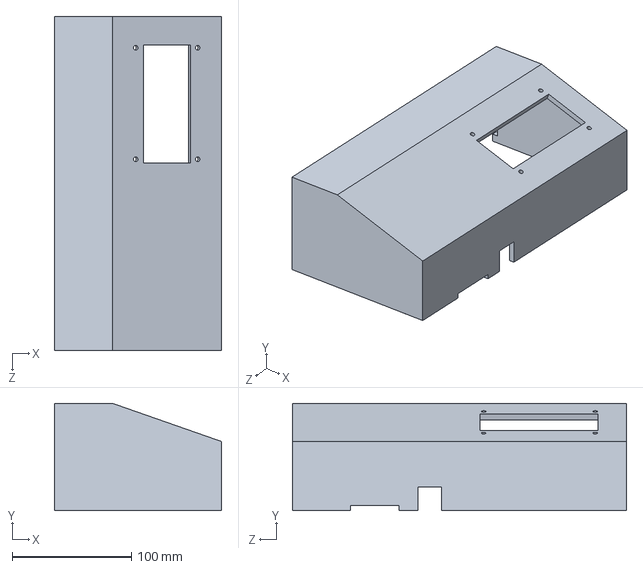
[picture p89: CAD file, 2026-10-28]
Mechanical/3D Model/Cover.SLDPRT
140.0 x 90.0 x 280.0 mm
