rashadrahimzade/Smart-Viscosity-Measurement-and-Control-System-VYTRON/Mechanical/3D Model/Al mil 91.SLDPRT

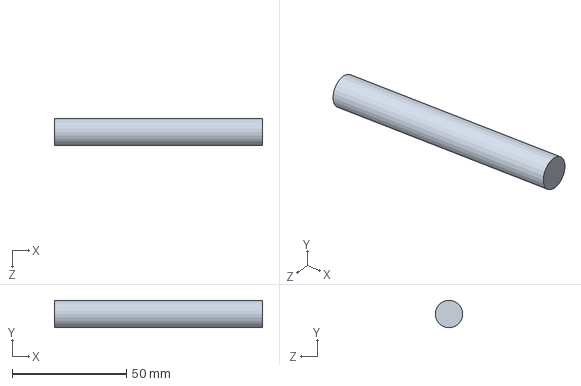
[picture p90: CAD file, 2026-10-28]
Mechanical/3D Model/Al mil 91.SLDPRT
91.0 x 12.0 x 12.0 mm
