rashadrahimzade/Smart-Viscosity-Measurement-and-Control-System-VYTRON/Mechanical/3D Model/Schneider MCB EZ9F34125.SLDPRT

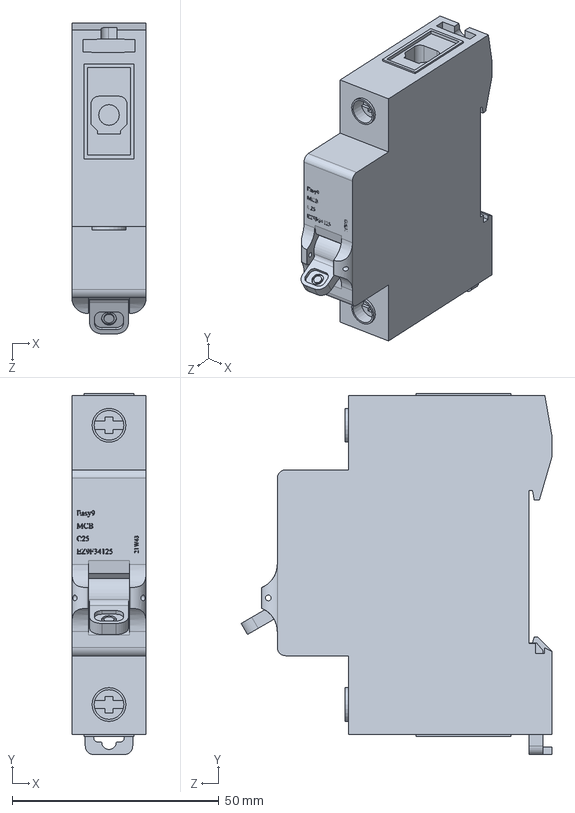
[picture p91: CAD file, 2026-10-28]
Mechanical/3D Model/Schneider MCB EZ9F34125.SLDPRT
18.0 x 87.4 x 75.3 mm
