rashadrahimzade/Smart-Viscosity-Measurement-and-Control-System-VYTRON/Mechanical/3D Model/Plaka 1.SLDPRT

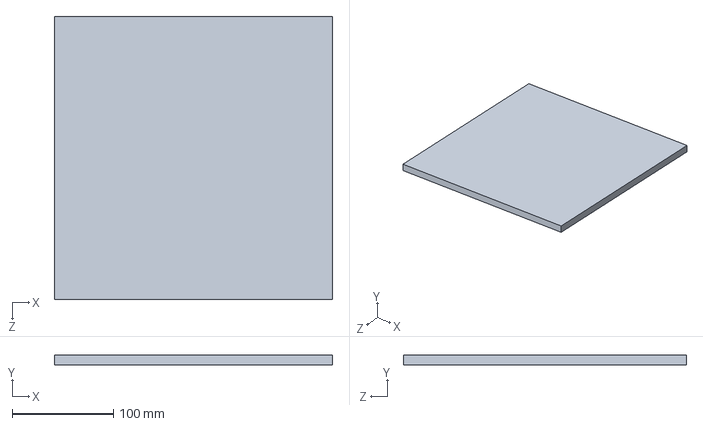
[picture p92: CAD file, 2026-10-28]
Mechanical/3D Model/Plaka 1.SLDPRT
275.0 x 10.0 x 280.0 mm
