rashadrahimzade/Smart-Viscosity-Measurement-and-Control-System-VYTRON/Mechanical/3D Model/Control Panel Plate.SLDPRT

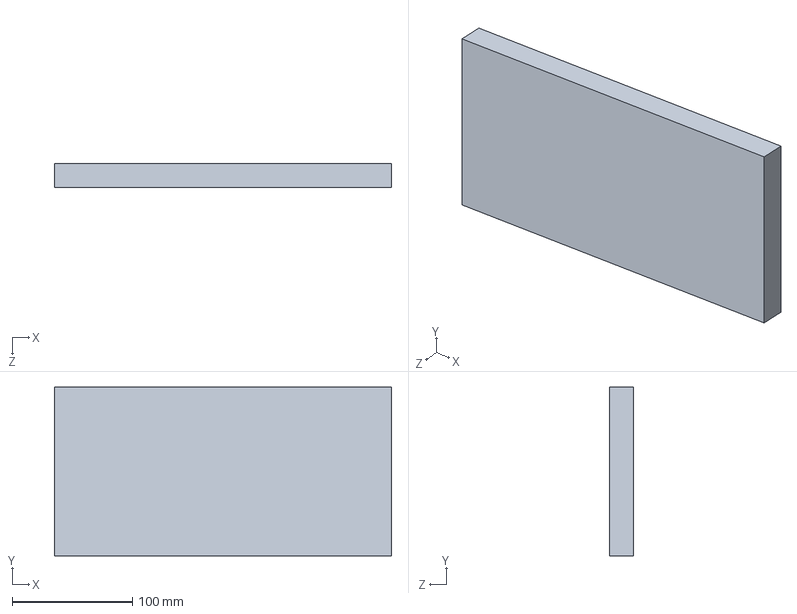
[picture p93: CAD file, 2026-10-28]
Mechanical/3D Model/Control Panel Plate.SLDPRT
280.0 x 140.0 x 20.0 mm
