rashadrahimzade/Smart-Viscosity-Measurement-and-Control-System-VYTRON/Mechanical/3D Model/arduino_MEGA2560.SLDPRT

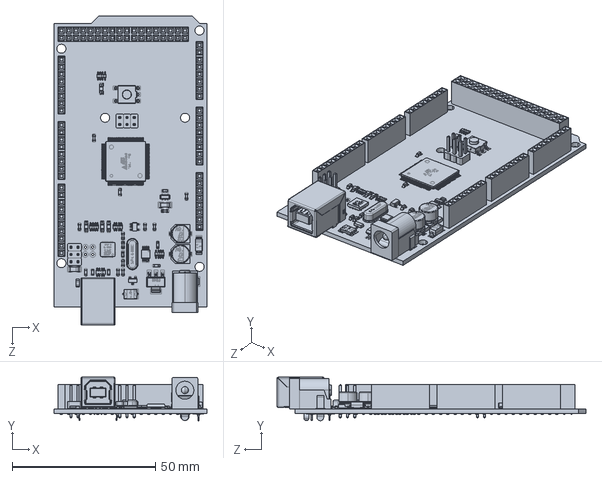
[picture p94: CAD file, 2026-10-28]
Mechanical/3D Model/arduino_MEGA2560.SLDPRT
53.3 x 15.2 x 107.9 mm
