rashadrahimzade/Smart-Viscosity-Measurement-and-Control-System-VYTRON/Mechanical/3D Model/Coupling-GS-19.SLDPRT

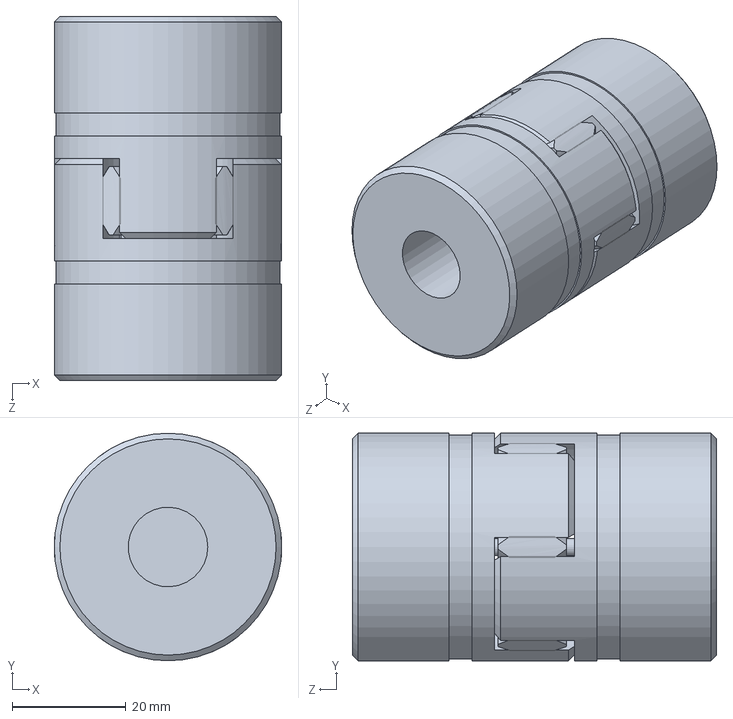
[picture p95: CAD file, 2026-10-28]
Mechanical/3D Model/Coupling-GS-19.SLDPRT
40.0 x 40.0 x 64.0 mm
