rashadrahimzade/Smart-Viscosity-Measurement-and-Control-System-VYTRON/Mechanical/3D Model/Plaka on.SLDPRT

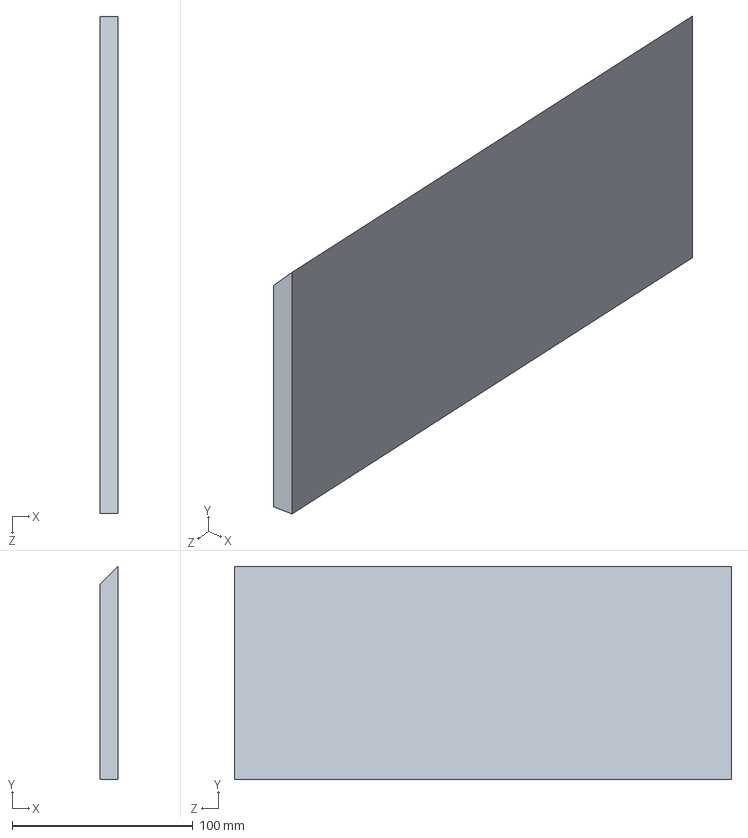
[picture p96: CAD file, 2026-10-28]
Mechanical/3D Model/Plaka on.SLDPRT
10.0 x 117.9 x 275.0 mm
