rashadrahimzade/Smart-Viscosity-Measurement-and-Control-System-VYTRON/Mechanical/3D Model/destek.SLDPRT

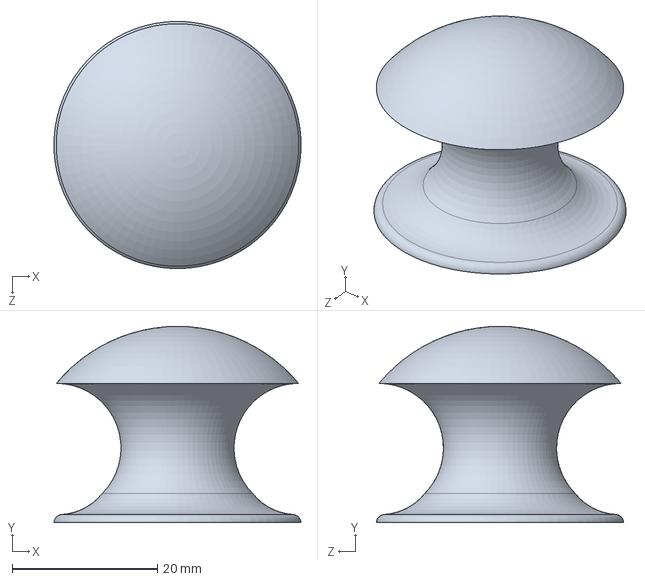
[picture p97: CAD file, 2026-10-28]
Mechanical/3D Model/destek.SLDPRT
34.0 x 27.0 x 34.0 mm
