rashadrahimzade/Smart-Viscosity-Measurement-and-Control-System-VYTRON/Mechanical/3D Model/ALT KAPAK N.SLDPRT

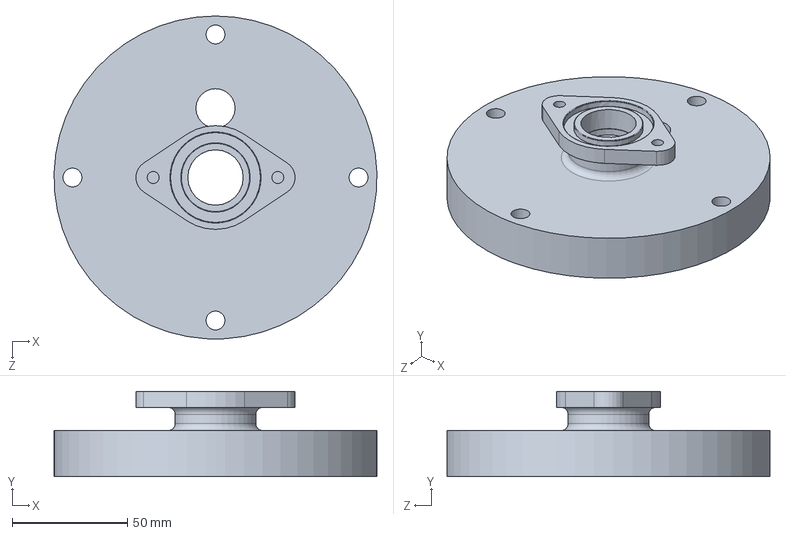
[picture p98: CAD file, 2026-10-28]
Mechanical/3D Model/ALT KAPAK N.SLDPRT
139.9 x 37.0 x 140.0 mm
