rashadrahimzade/Smart-Viscosity-Measurement-and-Control-System-VYTRON/Mechanical/3D Model/LCD.SLDPRT

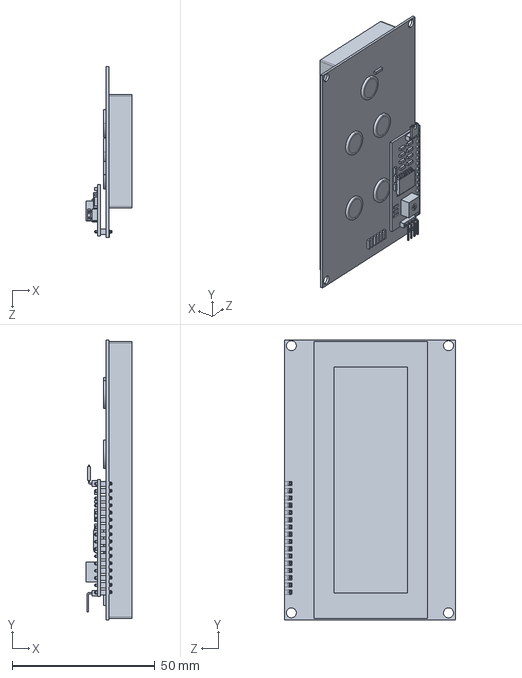
[picture p99: CAD file, 2026-10-28]
Mechanical/3D Model/LCD.SLDPRT
16.0 x 98.0 x 60.0 mm
