rashadrahimzade/Smart-Viscosity-Measurement-and-Control-System-VYTRON/Mechanical/3D Model/Sensor Body.SLDPRT

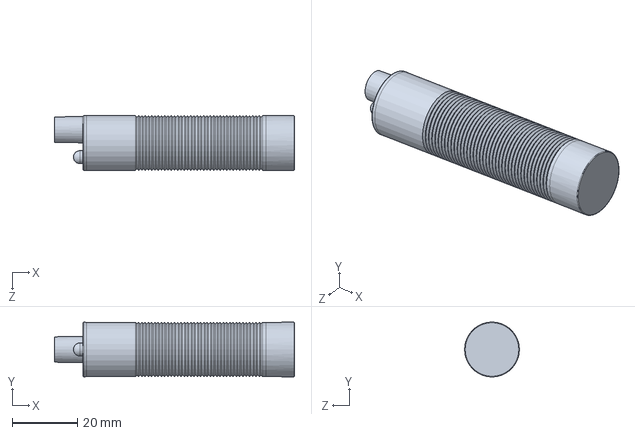
[picture p100: CAD file, 2026-10-28]
Mechanical/3D Model/Sensor Body.SLDPRT
73.6 x 16.8 x 16.8 mm
