rashadrahimzade/Smart-Viscosity-Measurement-and-Control-System-VYTRON/Mechanical/3D Model/40x40x180 direkler N.SLDPRT

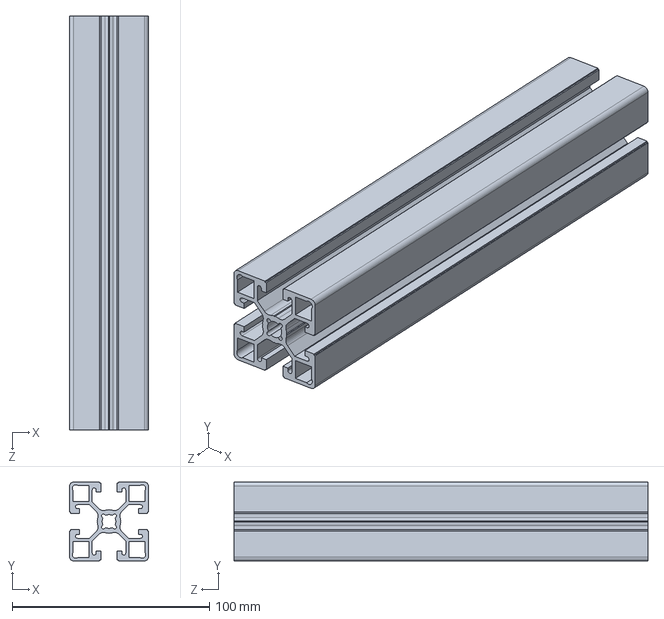
[picture p101: CAD file, 2026-10-28]
Mechanical/3D Model/40x40x180 direkler N.SLDPRT
40.0 x 40.0 x 210.0 mm
