rashadrahimzade/Smart-Viscosity-Measurement-and-Control-System-VYTRON/Mechanical/3D Model/LCD_MSP2807_fusion.SLDPRT

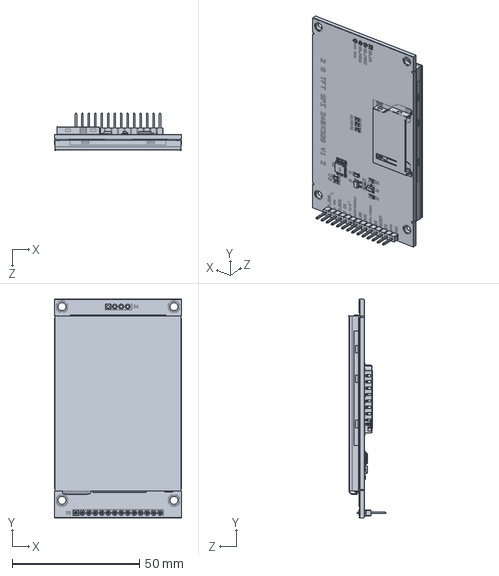
[picture p102: CAD file, 2026-10-28]
Mechanical/3D Model/LCD_MSP2807_fusion.SLDPRT
50.1 x 86.0 x 14.6 mm
