rashadrahimzade/Smart-Viscosity-Measurement-and-Control-System-VYTRON/Mechanical/3D Model/Al Mil 110.SLDPRT

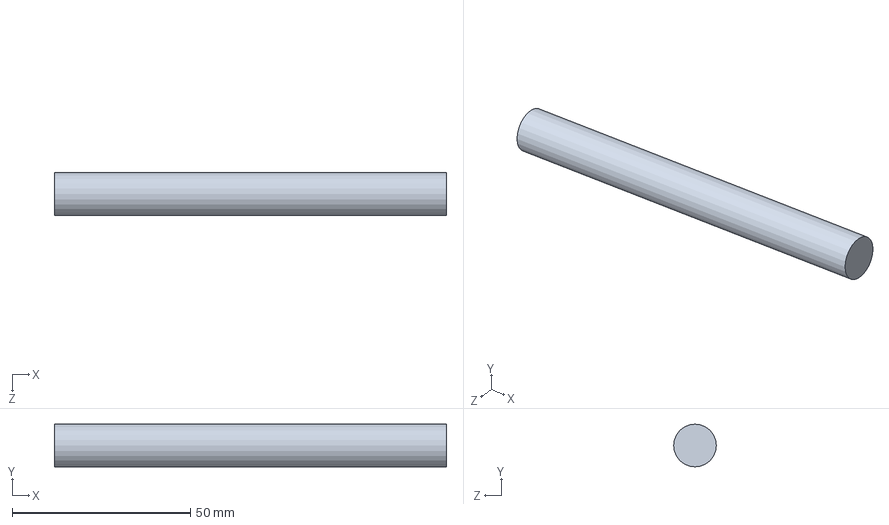
[picture p103: CAD file, 2026-10-28]
Mechanical/3D Model/Al Mil 110.SLDPRT
110.0 x 12.0 x 12.0 mm
