rashadrahimzade/Smart-Viscosity-Measurement-and-Control-System-VYTRON/Mechanical/3D Model/nema_34_motor_mount.SLDPRT

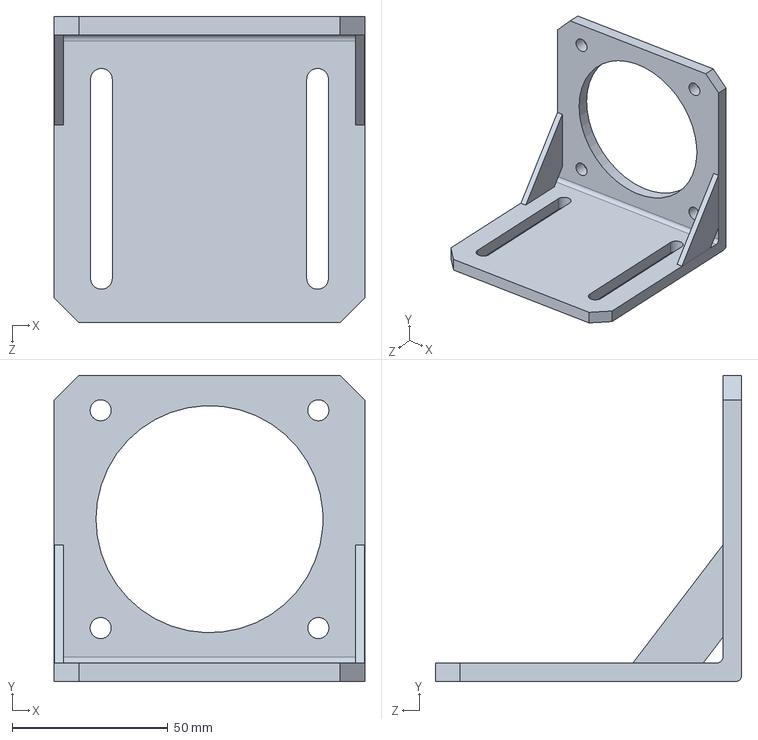
[picture p104: CAD file, 2026-10-28]
Mechanical/3D Model/nema_34_motor_mount.SLDPRT
100.0 x 98.5 x 98.5 mm
