rashadrahimzade/Smart-Viscosity-Measurement-and-Control-System-VYTRON/Mechanical/3D Model/EPDM CONTA 90x100x3.SLDPRT

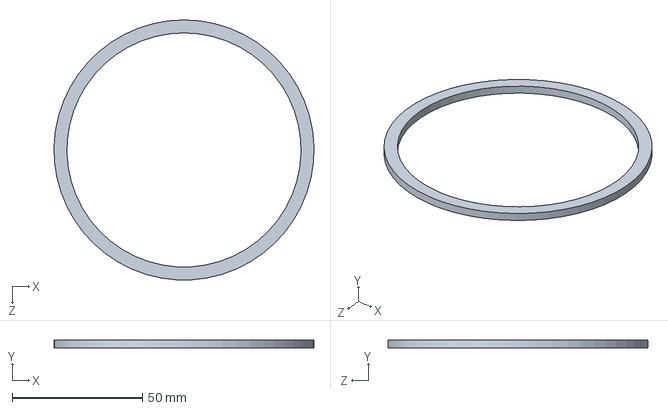
[picture p105: CAD file, 2026-10-28]
Mechanical/3D Model/EPDM CONTA 90x100x3.SLDPRT
100.0 x 3.00 x 100.0 mm
