rashadrahimzade/Smart-Viscosity-Measurement-and-Control-System-VYTRON/Mechanical/3D Model/Ekran kapagi.SLDPRT

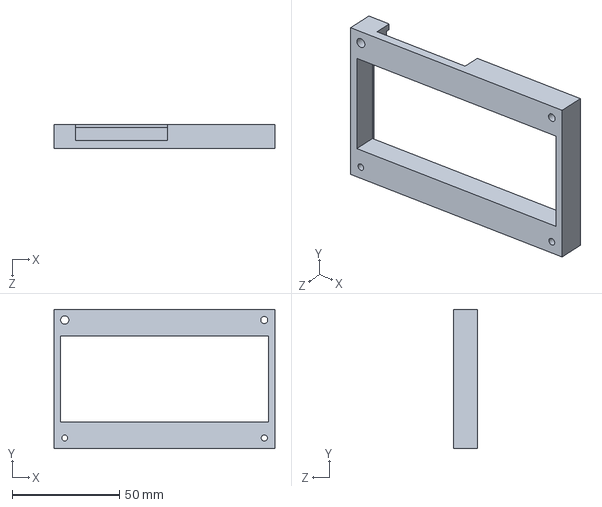
[picture p106: CAD file, 2026-10-28]
Mechanical/3D Model/Ekran kapagi.SLDPRT
103.0 x 65.0 x 11.4 mm
