rashadrahimzade/Smart-Viscosity-Measurement-and-Control-System-VYTRON/Mechanical/3D Model/LCD 1.SLDPRT

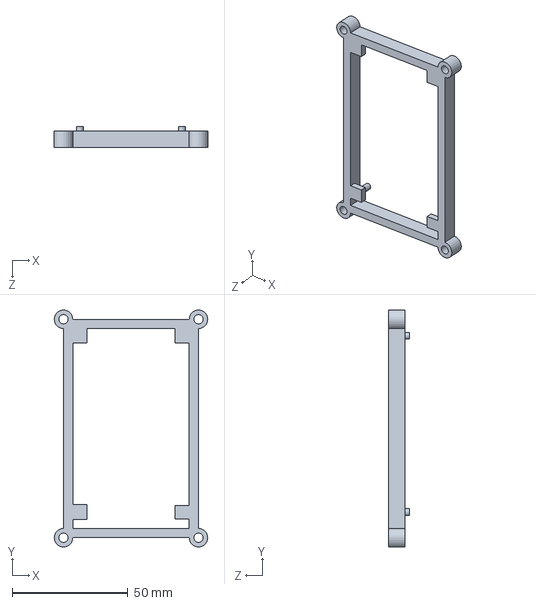
[picture p107: CAD file, 2026-10-28]
Mechanical/3D Model/LCD 1.SLDPRT
66.2 x 102.2 x 9.00 mm
