rashadrahimzade/Smart-Viscosity-Measurement-and-Control-System-VYTRON/Mechanical/3D Model/Rezistans Conta.SLDPRT

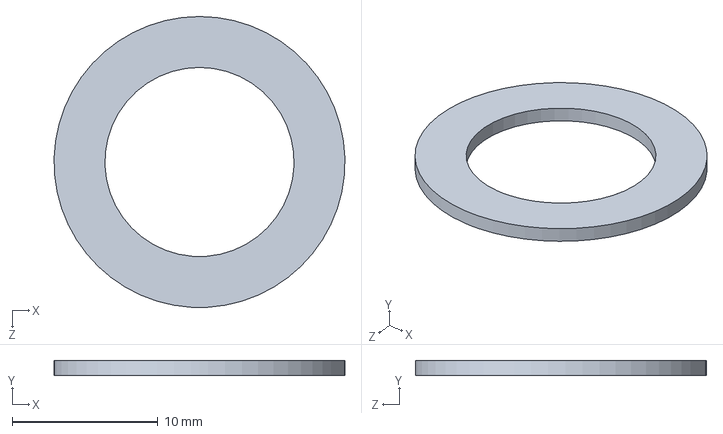
[picture p108: CAD file, 2026-10-28]
Mechanical/3D Model/Rezistans Conta.SLDPRT
20.0 x 1.00 x 20.0 mm
