rashadrahimzade/Smart-Viscosity-Measurement-and-Control-System-VYTRON/Mechanical/3D Model/KELEBEK SOMUN DIN 315.SLDPRT

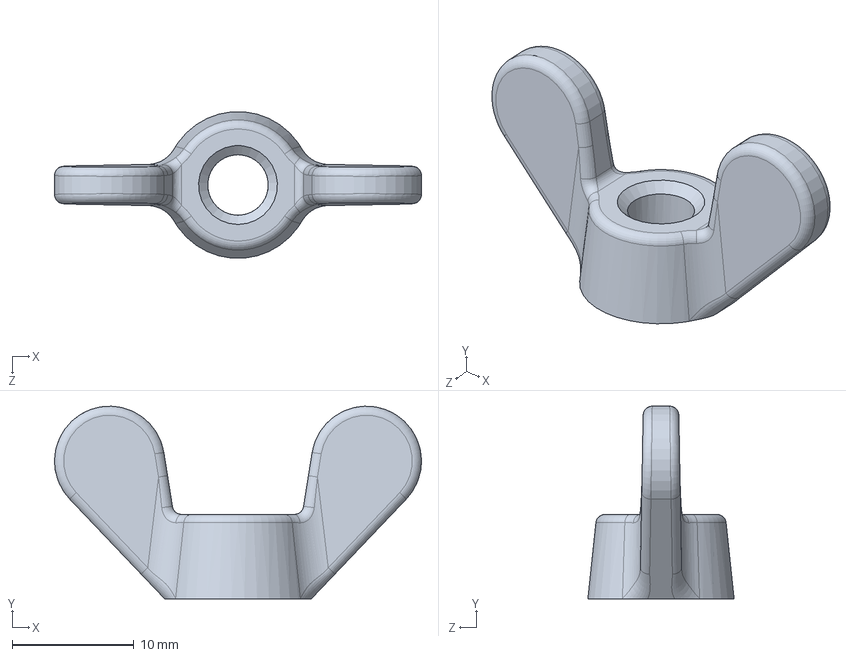
[picture p109: CAD file, 2026-10-28]
Mechanical/3D Model/KELEBEK SOMUN DIN 315.SLDPRT
30.2 x 15.9 x 12.0 mm
