rashadrahimzade/Smart-Viscosity-Measurement-and-Control-System-VYTRON/Mechanical/3D Model/Plaka pah.SLDPRT

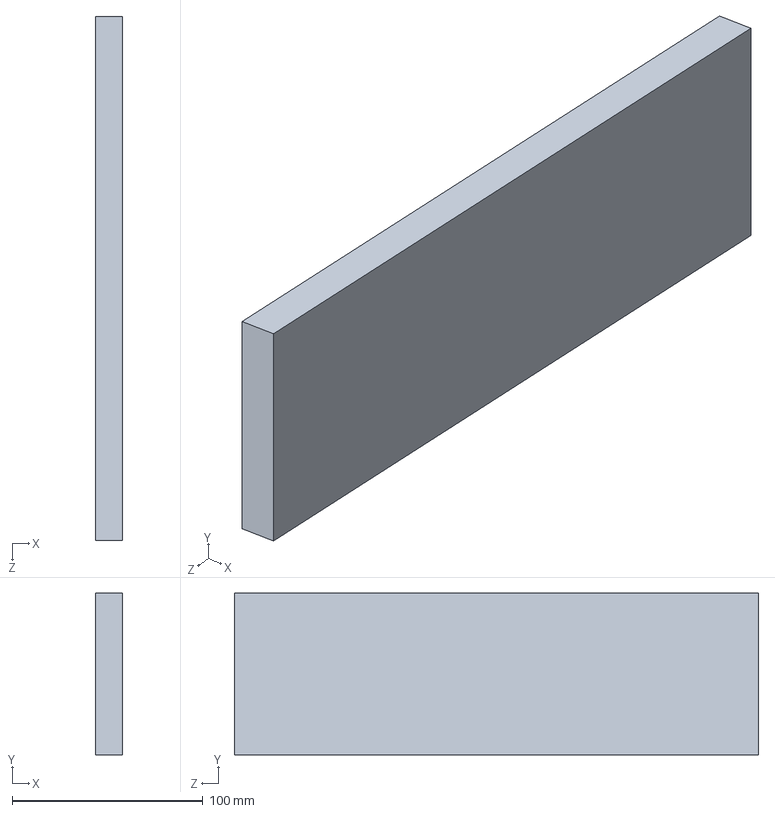
[picture p110: CAD file, 2026-10-28]
Mechanical/3D Model/Plaka pah.SLDPRT
14.1 x 84.8 x 275.0 mm
