rashadrahimzade/Smart-Viscosity-Measurement-and-Control-System-VYTRON/Mechanical/3D Model/Rezistans Yeni.SLDPRT

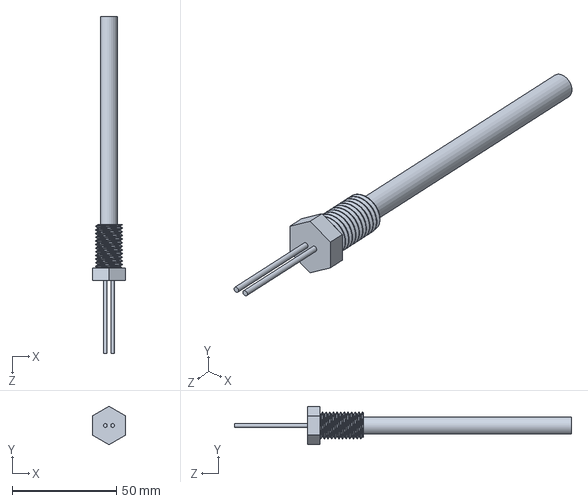
[picture p111: CAD file, 2026-10-28]
Mechanical/3D Model/Rezistans Yeni.SLDPRT
16.0 x 18.5 x 162.0 mm
