rashadrahimzade/Smart-Viscosity-Measurement-and-Control-System-VYTRON/Mechanical/3D Model/Protoboard - Deslizable.SLDPRT

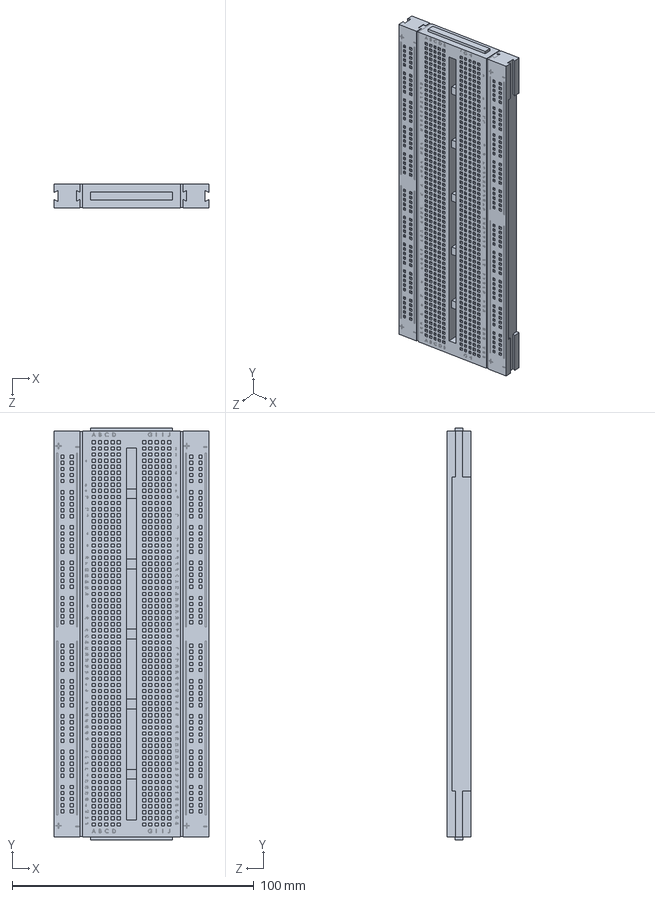
[picture p112: CAD file, 2026-10-28]
Mechanical/3D Model/Protoboard - Deslizable.SLDPRT
64.0 x 170.5 x 10.0 mm
