rashadrahimzade/Smart-Viscosity-Measurement-and-Control-System-VYTRON/Mechanical/3D Model/40x40 580 N.SLDPRT

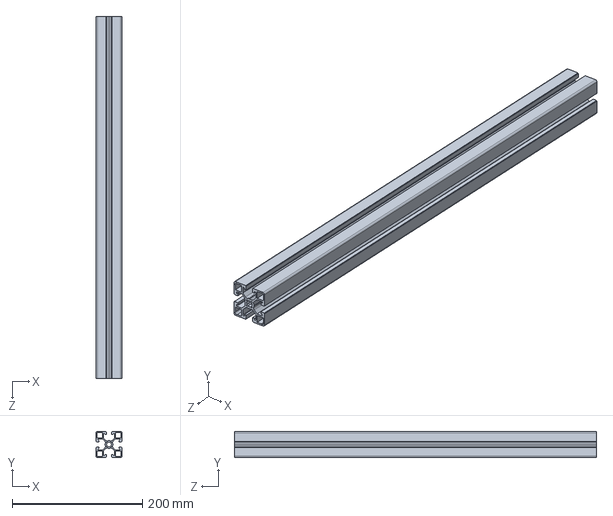
[picture p113: CAD file, 2026-10-28]
Mechanical/3D Model/40x40 580 N.SLDPRT
40.0 x 40.0 x 555.0 mm
