rashadrahimzade/Smart-Viscosity-Measurement-and-Control-System-VYTRON/Mechanical/3D Model/MPU.SLDPRT

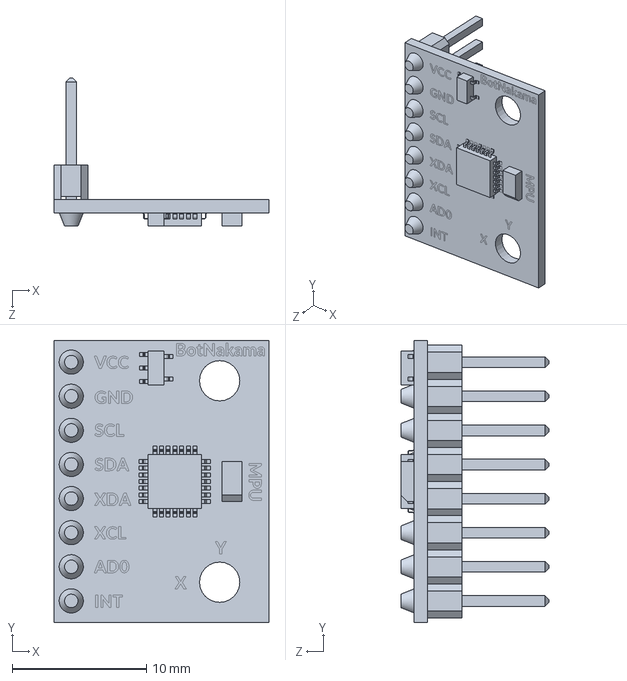
[picture p114: CAD file, 2026-10-28]
Mechanical/3D Model/MPU.SLDPRT
16.0 x 21.0 x 11.1 mm
