rashadrahimzade/Smart-Viscosity-Measurement-and-Control-System-VYTRON/Mechanical/3D Model/Temp Sensor.SLDPRT

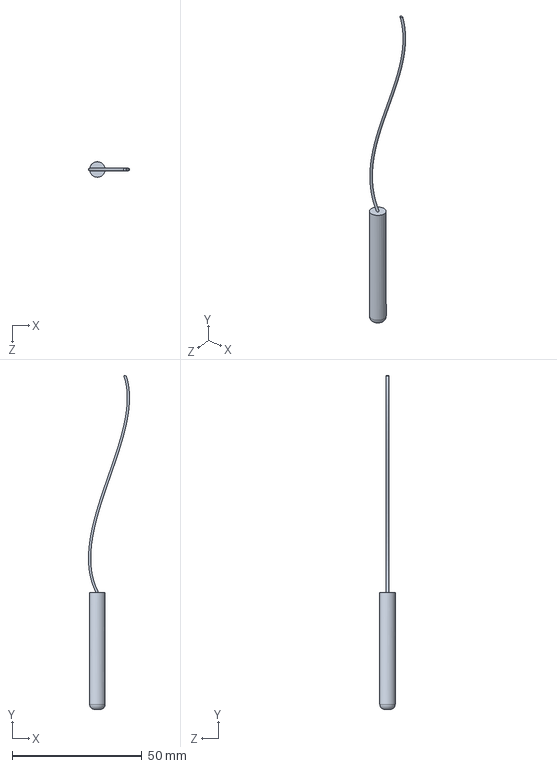
[picture p115: CAD file, 2026-10-28]
Mechanical/3D Model/Temp Sensor.SLDPRT
15.8 x 128.6 x 6.00 mm
