rashadrahimzade/Smart-Viscosity-Measurement-and-Control-System-VYTRON/Mechanical/3D Model/Dış Cam Tüp N.SLDPRT

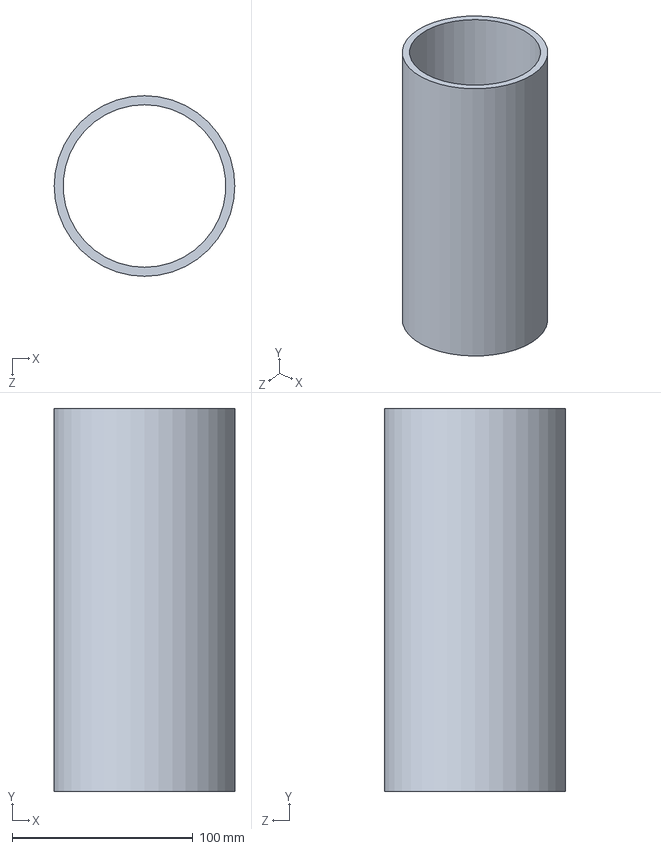
[picture p116: CAD file, 2026-10-28]
Mechanical/3D Model/Dış Cam Tüp N.SLDPRT
100.0 x 212.0 x 100.0 mm
