rashadrahimzade/Smart-Viscosity-Measurement-and-Control-System-VYTRON/Mechanical/3D Model/plaka ust.SLDPRT

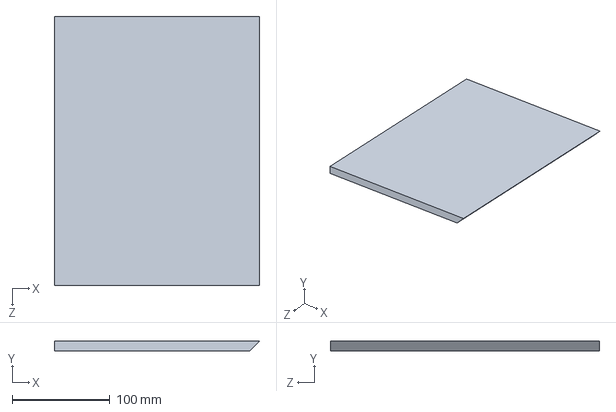
[picture p117: CAD file, 2026-10-28]
Mechanical/3D Model/plaka ust.SLDPRT
210.0 x 10.0 x 275.0 mm
