rashadrahimzade/Smart-Viscosity-Measurement-and-Control-System-VYTRON/Mechanical/3D Model/Kapak UST N.SLDPRT

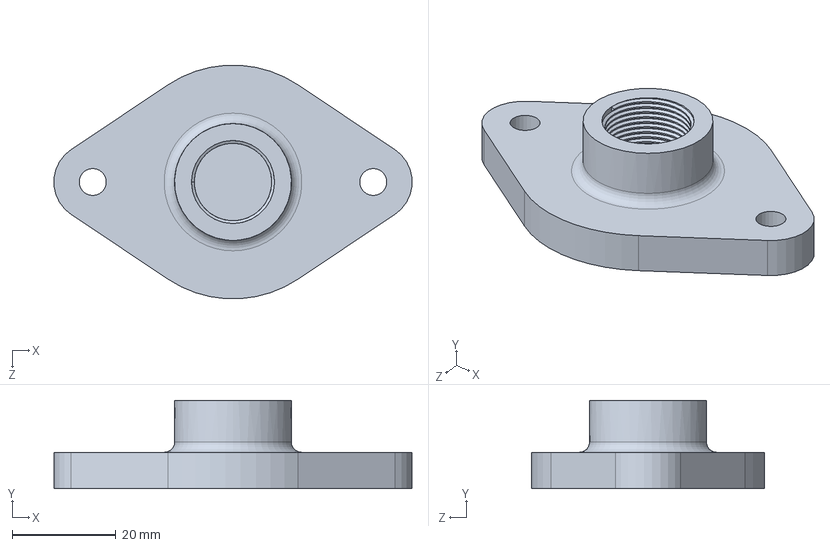
[picture p118: CAD file, 2026-10-28]
Mechanical/3D Model/Kapak UST N.SLDPRT
68.9 x 17.0 x 44.9 mm
