rashadrahimzade/Smart-Viscosity-Measurement-and-Control-System-VYTRON/Mechanical/3D Model/DM860D.SLDPRT

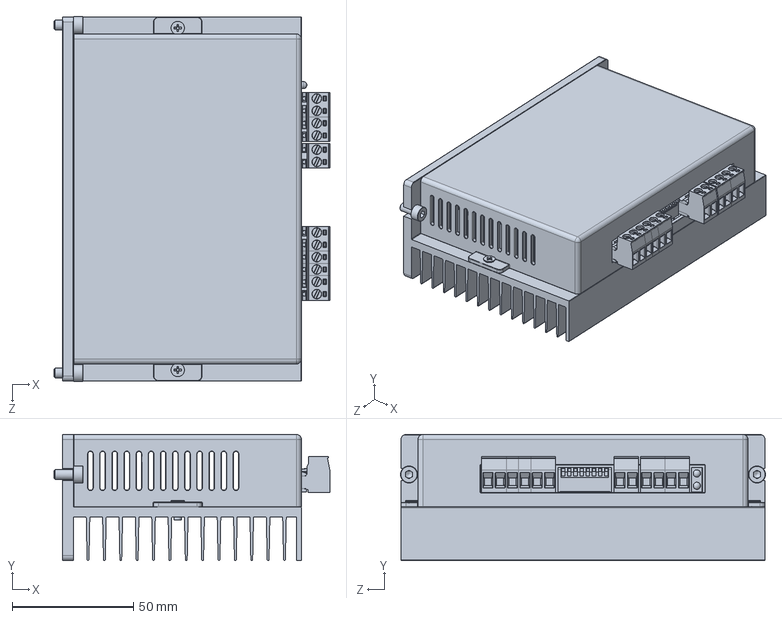
[picture p119: CAD file, 2026-10-28]
Mechanical/3D Model/DM860D.SLDPRT
113.7 x 52.0 x 150.5 mm
