rashadrahimzade/Smart-Viscosity-Measurement-and-Control-System-VYTRON/Mechanical/3D Model/Dişli Mil N.SLDPRT

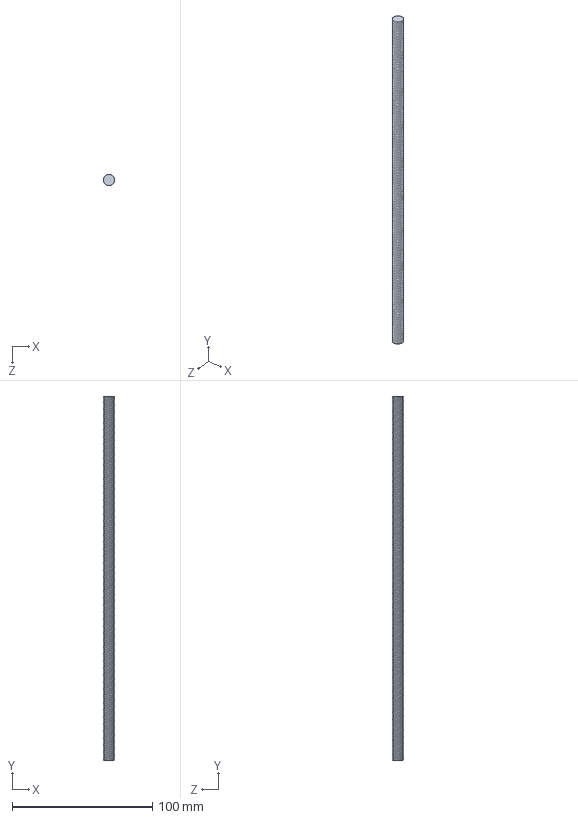
[picture p120: CAD file, 2026-10-28]
Mechanical/3D Model/Dişli Mil N.SLDPRT
8.00 x 260.0 x 8.00 mm
