rashadrahimzade/Smart-Viscosity-Measurement-and-Control-System-VYTRON/Mechanical/3D Model/keypad-16KeyMembrane.SLDPRT

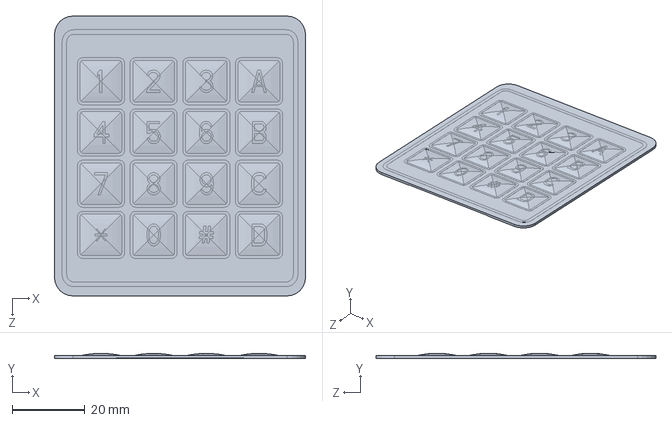
[picture p121: CAD file, 2026-10-28]
Mechanical/3D Model/keypad-16KeyMembrane.SLDPRT
69.0 x 1.47 x 76.9 mm
