rashadrahimzade/Smart-Viscosity-Measurement-and-Control-System-VYTRON/Mechanical/3D Model/Bilye.SLDPRT

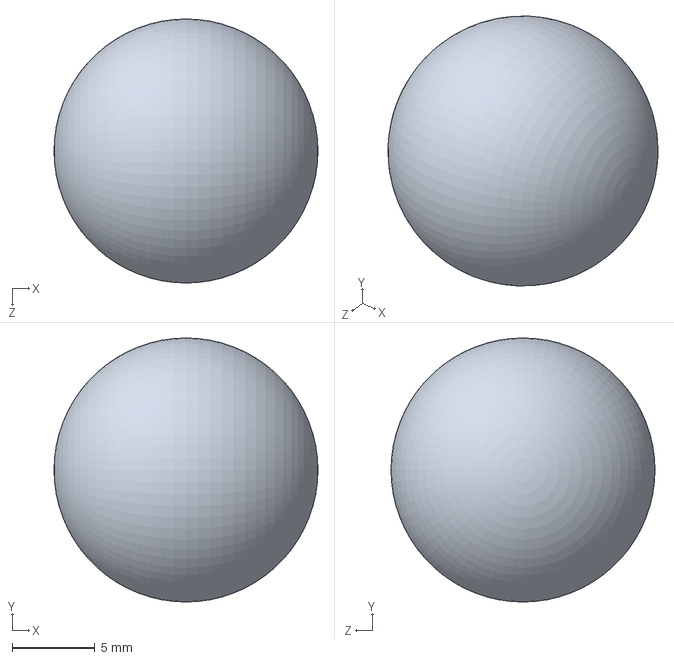
[picture p122: CAD file, 2026-10-28]
Mechanical/3D Model/Bilye.SLDPRT
16.0 x 16.0 x 16.0 mm
