rashadrahimzade/Smart-Viscosity-Measurement-and-Control-System-VYTRON/Mechanical/3D Model/Nipel.SLDPRT

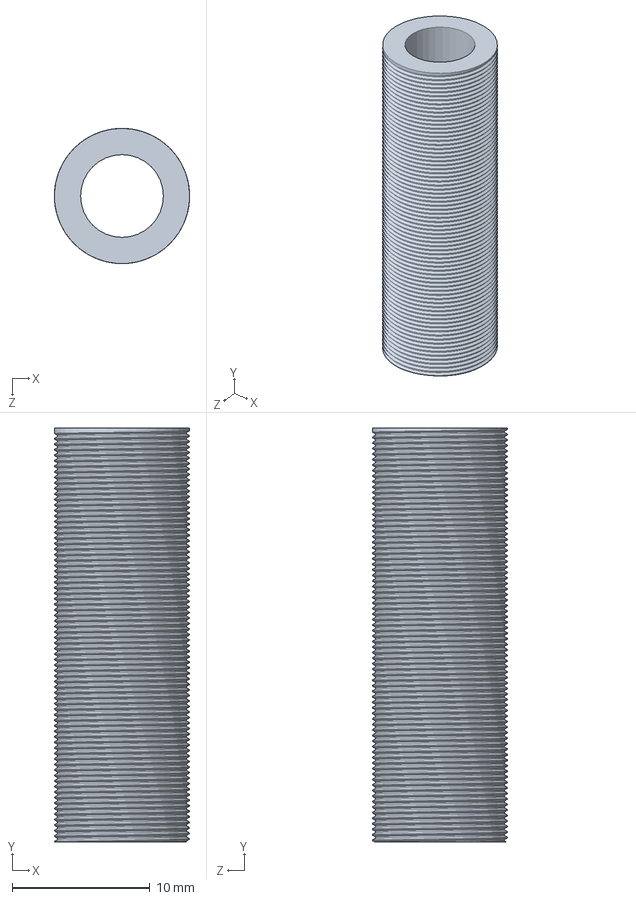
[picture p124: CAD file, 2026-10-28]
Mechanical/3D Model/Nipel.SLDPRT
9.80 x 30.0 x 9.80 mm
