rashadrahimzade/Smart-Viscosity-Measurement-and-Control-System-VYTRON/Mechanical/3D Model/UCP-201.SLDPRT

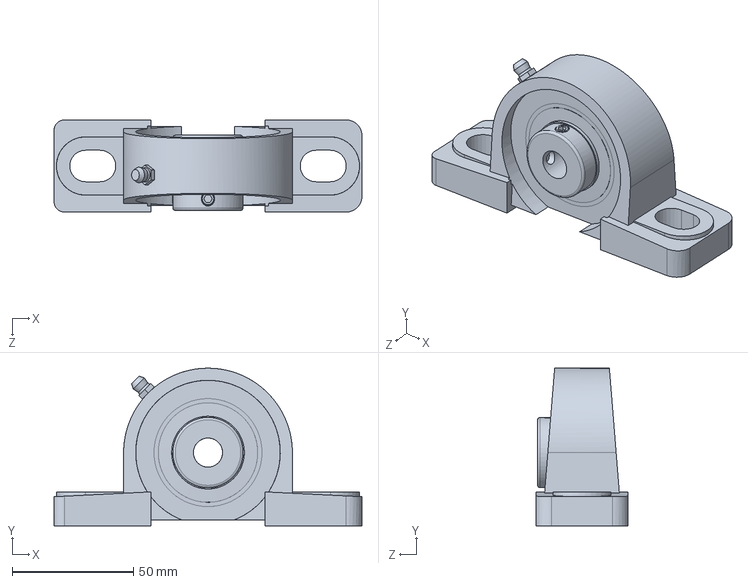
[picture p125: CAD file, 2026-10-28]
Mechanical/3D Model/UCP-201.SLDPRT
127.0 x 65.0 x 38.0 mm
