rashadrahimzade/Smart-Viscosity-Measurement-and-Control-System-VYTRON/Mechanical/3D Model/Rocker Switch.SLDPRT

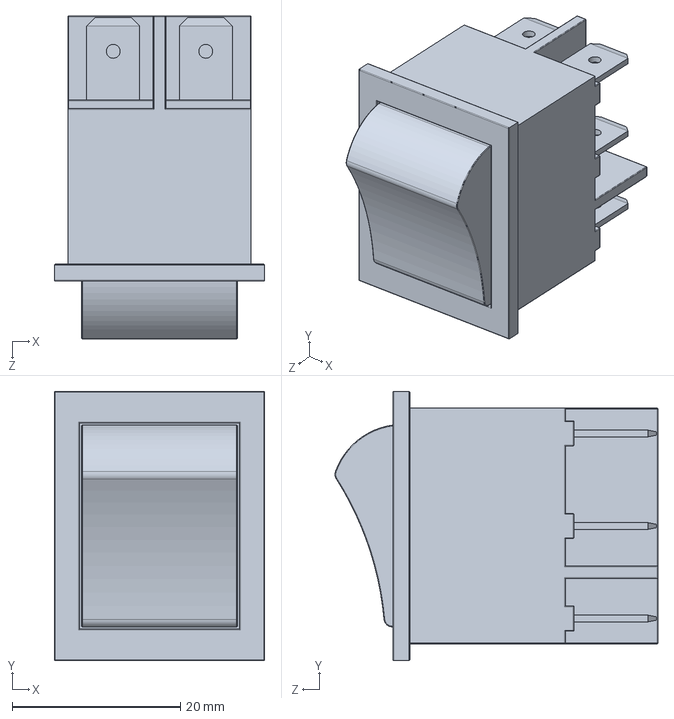
[picture p126: CAD file, 2026-10-28]
Mechanical/3D Model/Rocker Switch.SLDPRT
25.0 x 32.0 x 38.4 mm
