rashadrahimzade/Smart-Viscosity-Measurement-and-Control-System-VYTRON/Mechanical/3D Model/MOTOR STEPPER NEMA 34.SLDPRT

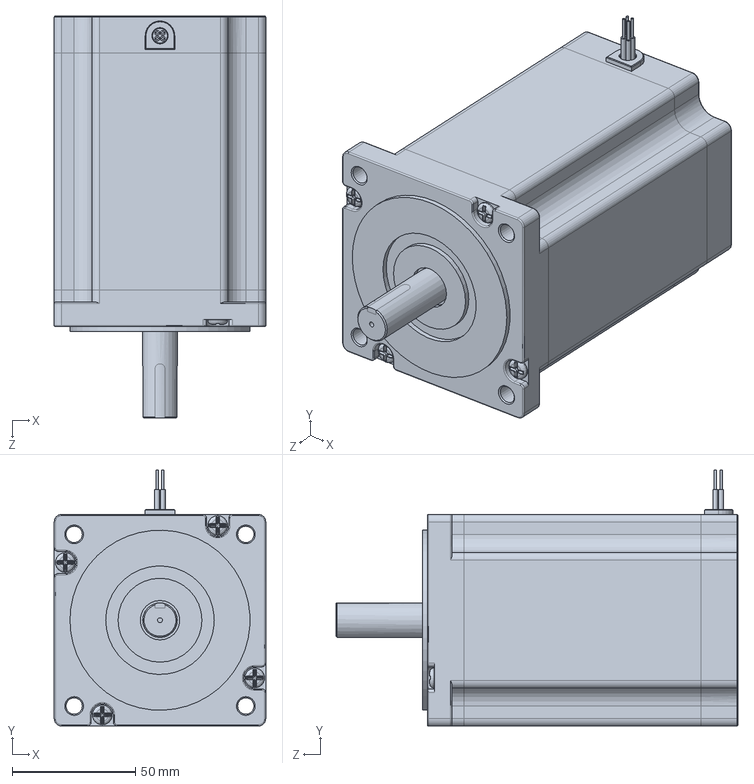
[picture p127: CAD file, 2026-10-28]
Mechanical/3D Model/MOTOR STEPPER NEMA 34.SLDPRT
85.8 x 103.8 x 163.0 mm
