rashadrahimzade/Smart-Viscosity-Measurement-and-Control-System-VYTRON/Mechanical/3D Model/Conta Nipel.SLDPRT

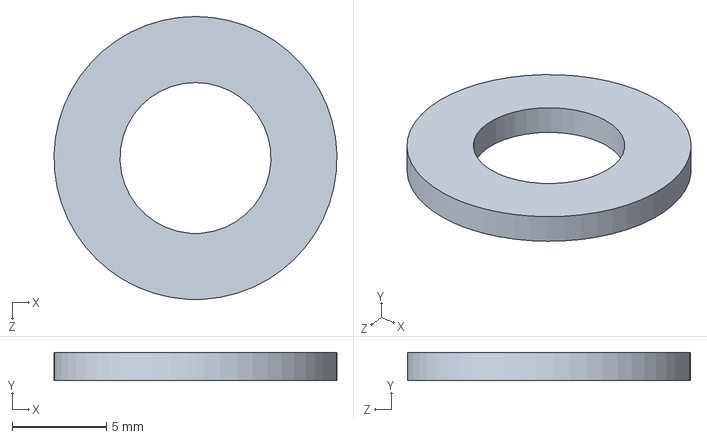
[picture p128: CAD file, 2026-10-28]
Mechanical/3D Model/Conta Nipel.SLDPRT
15.0 x 1.50 x 15.0 mm
