rashadrahimzade/Smart-Viscosity-Measurement-and-Control-System-VYTRON/Mechanical/3D Model/GS_14_KAPLIN.SLDPRT

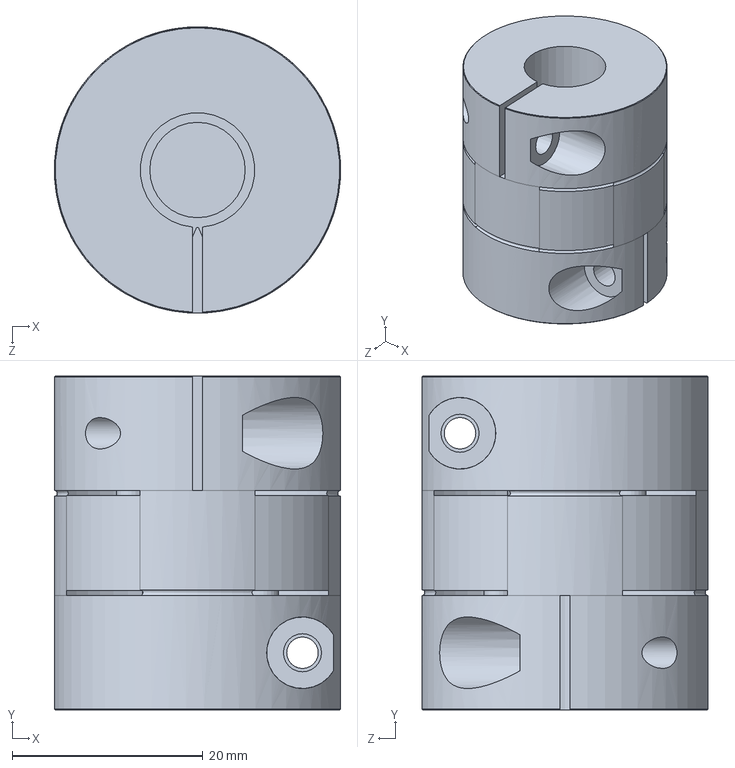
[picture p129: CAD file, 2026-10-28]
Mechanical/3D Model/GS_14_KAPLIN.SLDPRT
30.0 x 35.0 x 30.0 mm
