rashadrahimzade/Smart-Viscosity-Measurement-and-Control-System-VYTRON/Mechanical/3D Model/arduinonano.SLDPRT

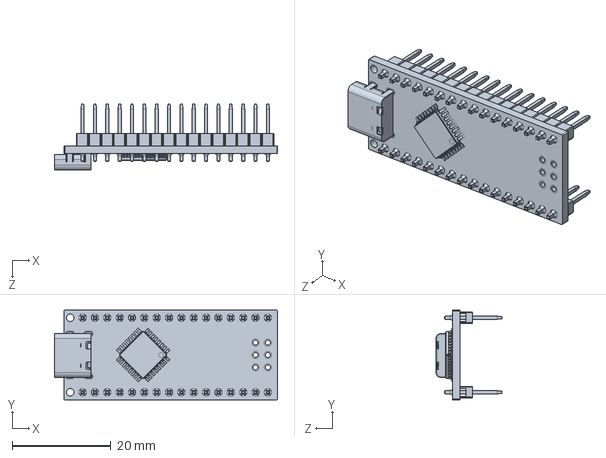
[picture p130: CAD file, 2026-10-28]
Mechanical/3D Model/arduinonano.SLDPRT
45.1 x 18.2 x 13.4 mm
