rashadrahimzade/Smart-Viscosity-Measurement-and-Control-System-VYTRON/Mechanical/3D Model/lcd 2004 i2c v1.SLDPRT

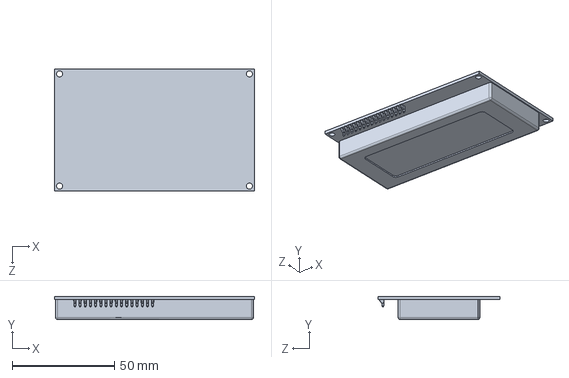
[picture p131: CAD file, 2026-10-28]
Mechanical/3D Model/lcd 2004 i2c v1.SLDPRT
98.0 x 11.4 x 60.0 mm
