rashadrahimzade/Smart-Viscosity-Measurement-and-Control-System-VYTRON/Mechanical/3D Model/SHF-12.SLDPRT

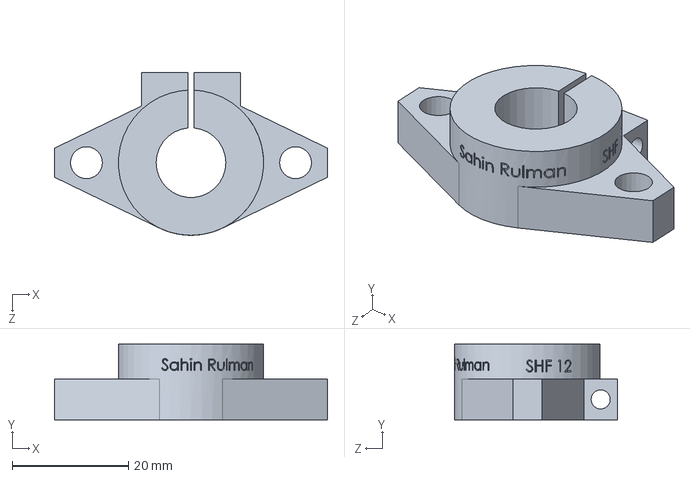
[picture p132: CAD file, 2026-10-28]
Mechanical/3D Model/SHF-12.SLDPRT
47.0 x 13.0 x 28.0 mm
