rashadrahimzade/Smart-Viscosity-Measurement-and-Control-System-VYTRON/Mechanical/3D Model/Boş Çubuk.SLDPRT

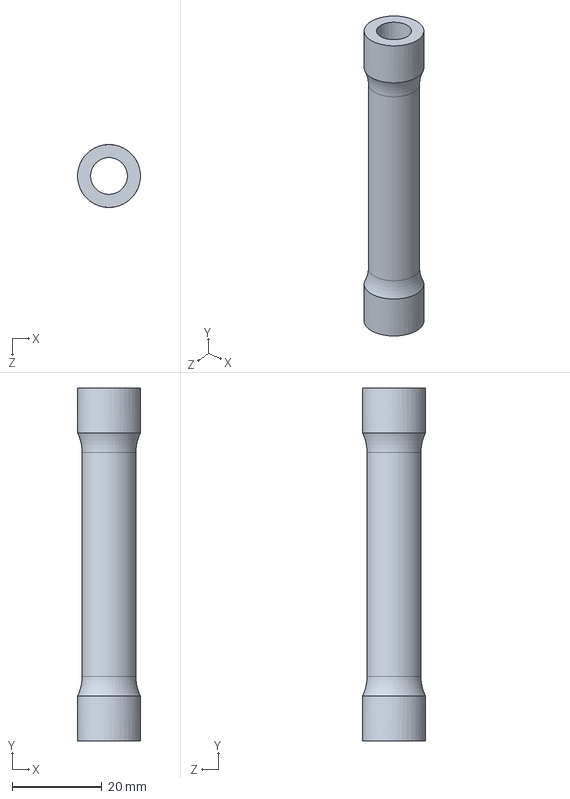
[picture p133: CAD file, 2026-10-28]
Mechanical/3D Model/Boş Çubuk.SLDPRT
14.0 x 78.5 x 14.0 mm
