rashadrahimzade/Smart-Viscosity-Measurement-and-Control-System-VYTRON/Mechanical/3D Model/Rezistans Somun.SLDPRT

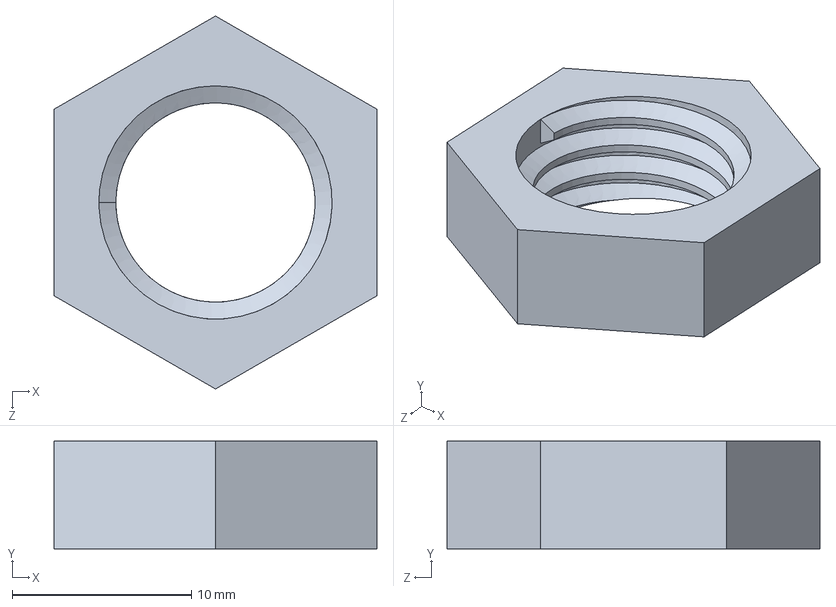
[picture p134: CAD file, 2026-10-28]
Mechanical/3D Model/Rezistans Somun.SLDPRT
18.0 x 6.00 x 20.8 mm
