rashadrahimzade/Smart-Viscosity-Measurement-and-Control-System-VYTRON/Mechanical/3D Model/KO-0980235.SLDPRT

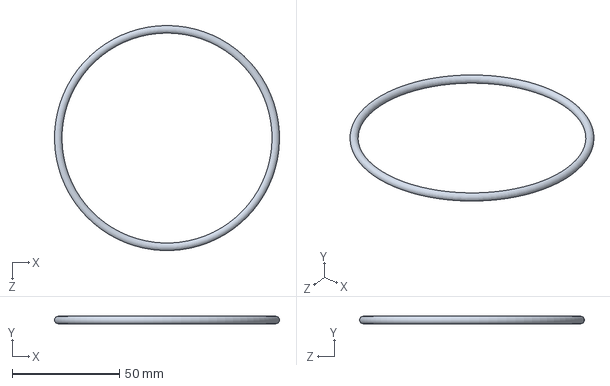
[picture p135: CAD file, 2026-10-28]
Mechanical/3D Model/KO-0980235.SLDPRT
105.1 x 3.53 x 105.0 mm
