rashadrahimzade/Smart-Viscosity-Measurement-and-Control-System-VYTRON/Mechanical/3D Model/KAPAK SENSÖR N.SLDPRT

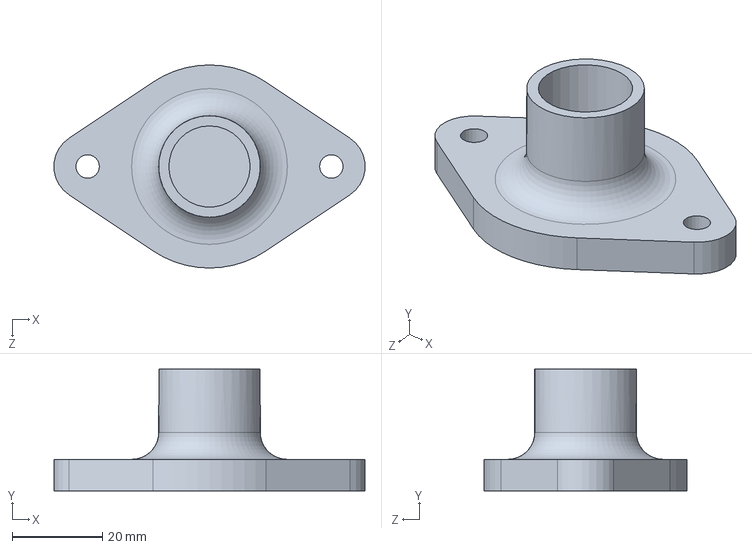
[picture p136: CAD file, 2026-10-28]
Mechanical/3D Model/KAPAK SENSÖR N.SLDPRT
68.9 x 27.0 x 45.0 mm
