rashadrahimzade/Smart-Viscosity-Measurement-and-Control-System-VYTRON/Mechanical/3D Model/M5 Saplama.SLDPRT

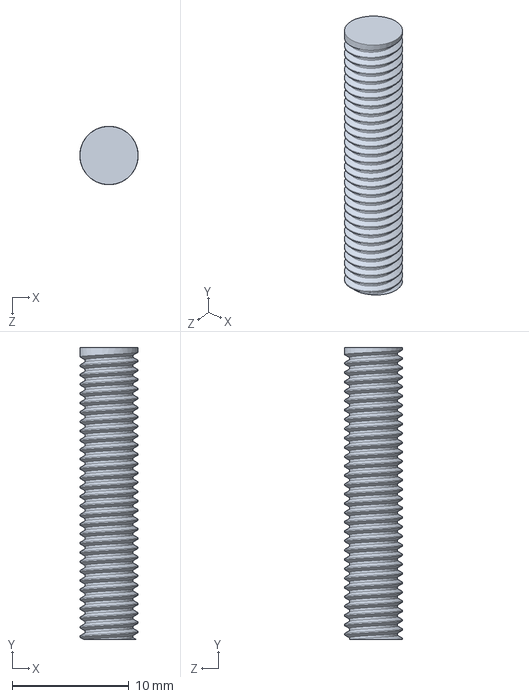
[picture p137: CAD file, 2026-10-28]
Mechanical/3D Model/M5 Saplama.SLDPRT
5.00 x 25.0 x 5.00 mm
