rashadrahimzade/Smart-Viscosity-Measurement-and-Control-System-VYTRON/Mechanical/3D Model/WELL RSP500-48 POWER SUPPLY.SLDPRT

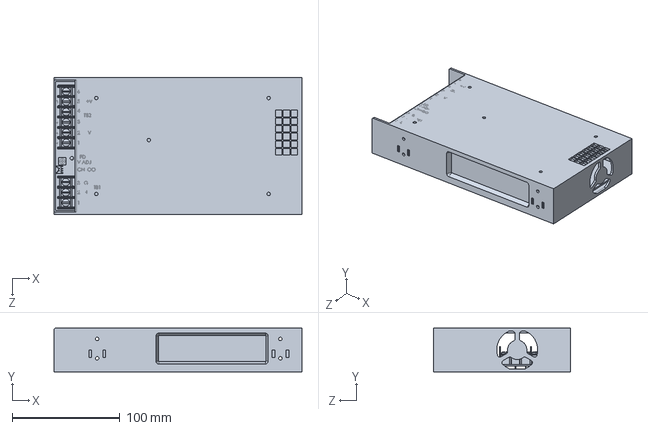
[picture p138: CAD file, 2026-10-28]
Mechanical/3D Model/WELL RSP500-48 POWER SUPPLY.SLDPRT
230.0 x 40.5 x 127.0 mm
