rashadrahimzade/Smart-Viscosity-Measurement-and-Control-System-VYTRON/Mechanical/3D Model/İç Cam Tüp N.SLDPRT

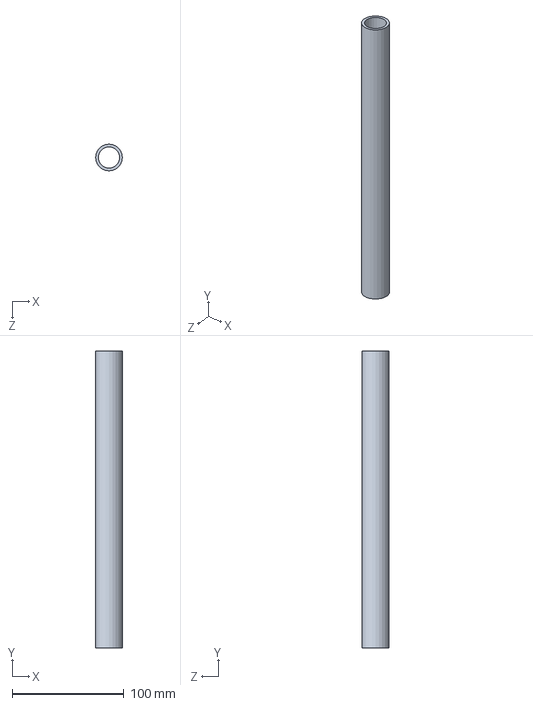
[picture p139: CAD file, 2026-10-28]
Mechanical/3D Model/İç Cam Tüp N.SLDPRT
24.0 x 266.0 x 24.0 mm
