rashadrahimzade/Smart-Viscosity-Measurement-and-Control-System-VYTRON/Mechanical/3D Model/Tapa.SLDPRT

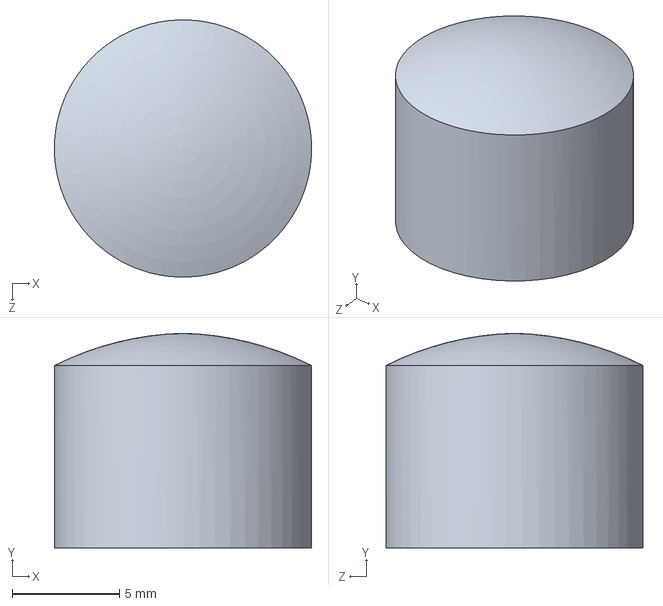
[picture p140: CAD file, 2026-10-28]
Mechanical/3D Model/Tapa.SLDPRT
12.0 x 10.0 x 12.0 mm
