rashadrahimzade/Smart-Viscosity-Measurement-and-Control-System-VYTRON/Mechanical/3D Model/SSR.SLDPRT

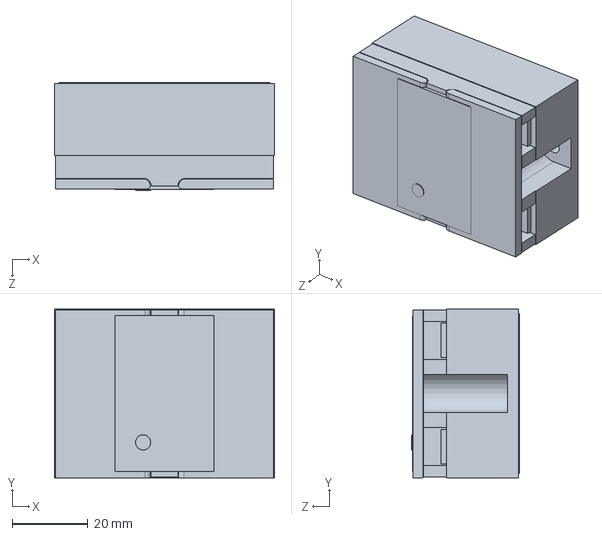
[picture p141: CAD file, 2026-10-28]
Mechanical/3D Model/SSR.SLDPRT
57.9 x 44.4 x 28.4 mm
