rashadrahimzade/Smart-Viscosity-Measurement-and-Control-System-VYTRON/Mechanical/3D Model/proto_400.SLDPRT

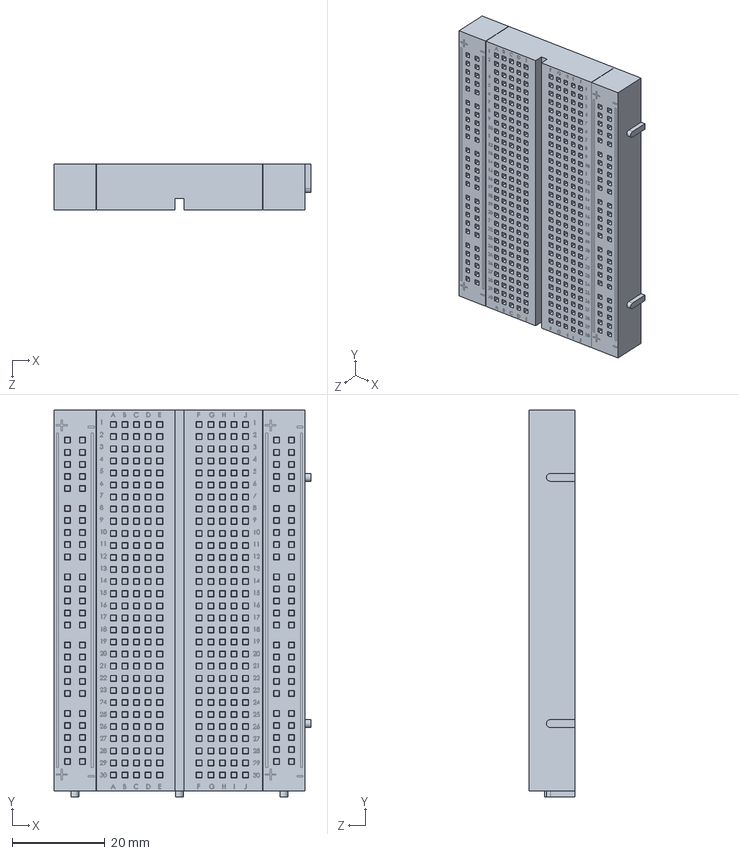
[picture p142: CAD file, 2026-10-28]
Mechanical/3D Model/proto_400.SLDPRT
55.3 x 83.3 x 10.0 mm
