rashadrahimzade/Smart-Viscosity-Measurement-and-Control-System-VYTRON/Mechanical/3D Model/Kelepçe N.SLDPRT

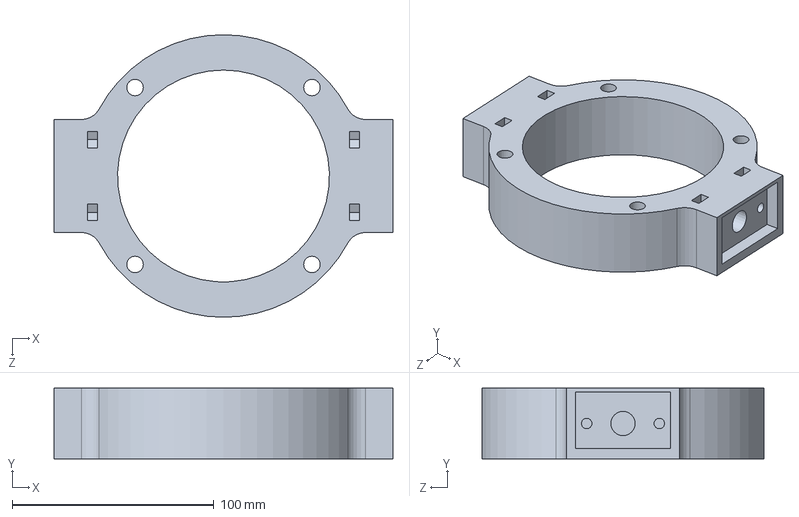
[picture p143: CAD file, 2026-10-28]
Mechanical/3D Model/Kelepçe N.SLDPRT
168.0 x 35.0 x 140.0 mm
