rashadrahimzade/Smart-Viscosity-Measurement-and-Control-System-VYTRON/Mechanical/3D Model/KO-0329235.SLDPRT

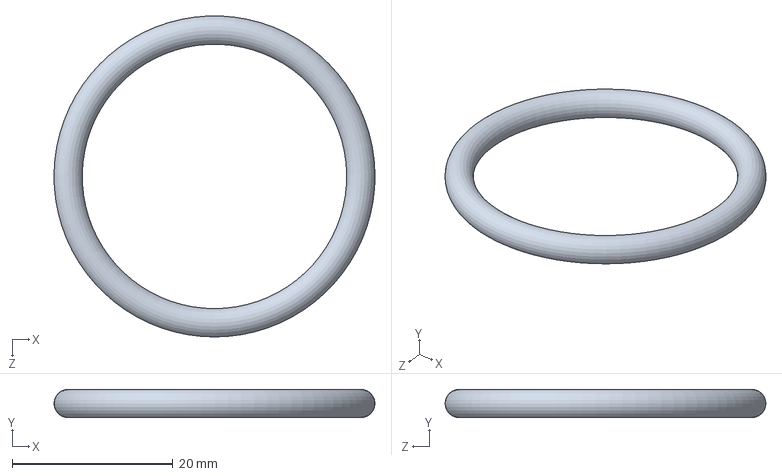
[picture p144: CAD file, 2026-10-28]
Mechanical/3D Model/KO-0329235.SLDPRT
40.0 x 3.53 x 40.0 mm
