rashadrahimzade/Smart-Viscosity-Measurement-and-Control-System-VYTRON/Mechanical/3D Model/Plaka alt.SLDPRT

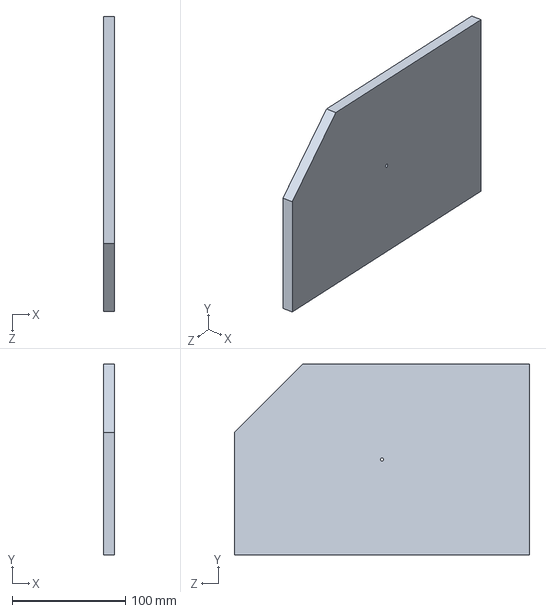
[picture p145: CAD file, 2026-10-28]
Mechanical/3D Model/Plaka alt.SLDPRT
10.0 x 167.9 x 260.0 mm
