rashadrahimzade/Smart-Viscosity-Measurement-and-Control-System-VYTRON/Mechanical/3D Model/Project Board Mini 170 pin.SLDPRT

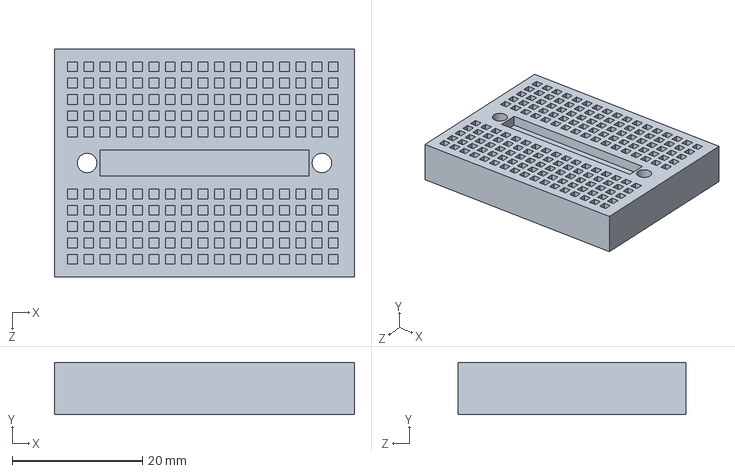
[picture p146: CAD file, 2026-10-28]
Mechanical/3D Model/Project Board Mini 170 pin.SLDPRT
46.0 x 8.00 x 35.0 mm
