rashadrahimzade/Smart-Viscosity-Measurement-and-Control-System-VYTRON/Mechanical/3D Model/Eunicell 10000mAh powerbank.SLDPRT

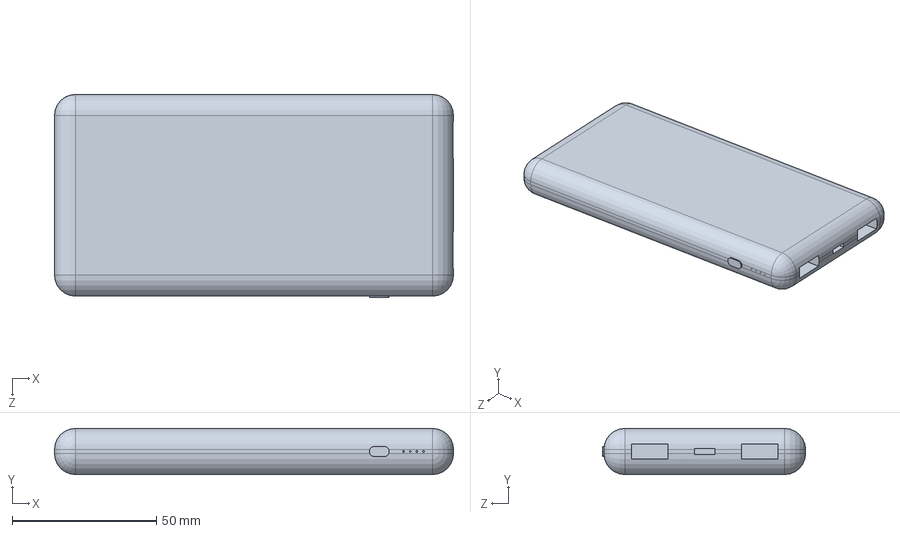
[picture p147: CAD file, 2026-10-28]
Mechanical/3D Model/Eunicell 10000mAh powerbank.SLDPRT
138.5 x 16.0 x 70.5 mm
