rashadrahimzade/Smart-Viscosity-Measurement-and-Control-System-VYTRON/Mechanical/3D Model/Plaka arka.SLDPRT

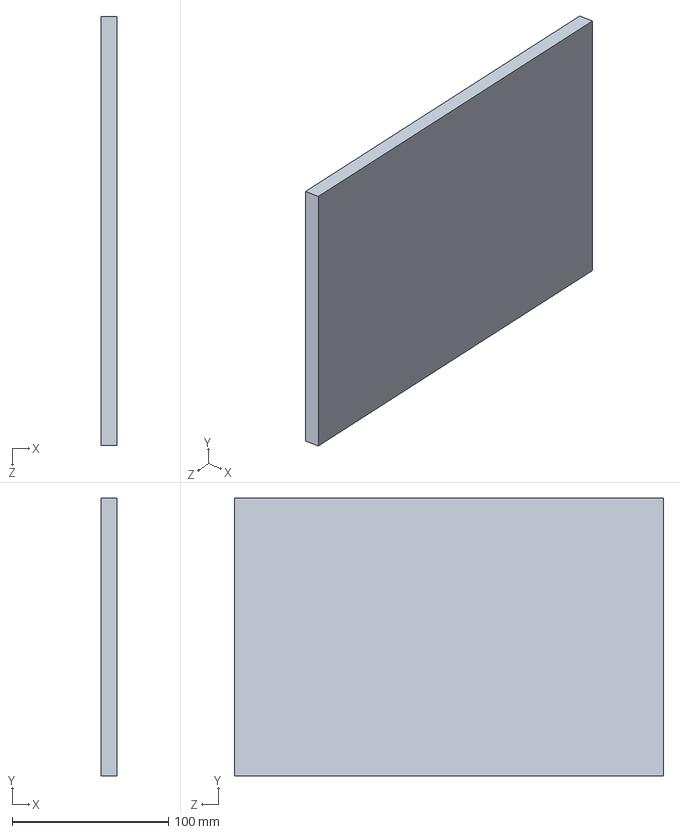
[picture p148: CAD file, 2026-10-28]
Mechanical/3D Model/Plaka arka.SLDPRT
10.0 x 177.9 x 275.0 mm
