rashadrahimzade/Smart-Viscosity-Measurement-and-Control-System-VYTRON/Mechanical/3D Model/AL PROFİL BAĞLANTI N.SLDPRT

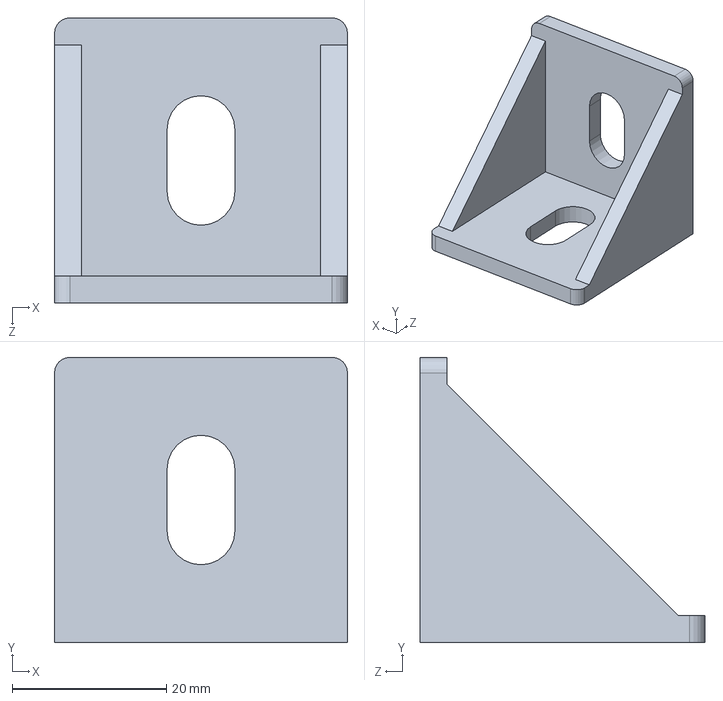
[picture p149: CAD file, 2026-10-28]
Mechanical/3D Model/AL PROFİL BAĞLANTI N.SLDPRT
38.0 x 37.0 x 37.0 mm
