rashadrahimzade/Smart-Viscosity-Measurement-and-Control-System-VYTRON/Mechanical/3D Model/LCD 3.SLDPRT

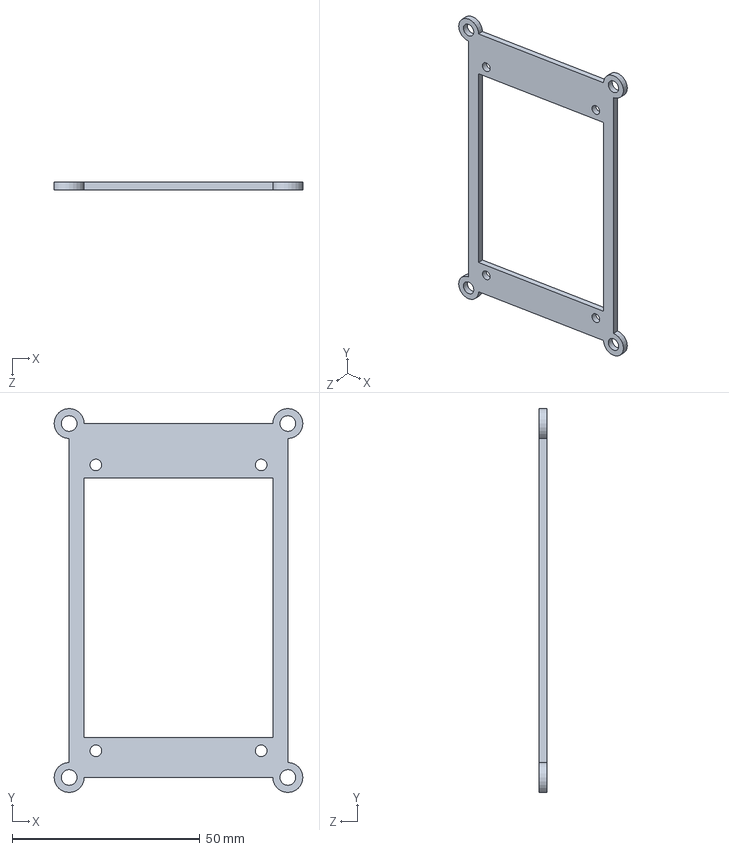
[picture p150: CAD file, 2026-10-28]
Mechanical/3D Model/LCD 3.SLDPRT
66.2 x 102.2 x 2.00 mm
