rashadrahimzade/Smart-Viscosity-Measurement-and-Control-System-VYTRON/Mechanical/3D Model/KO-0234035.SLDPRT

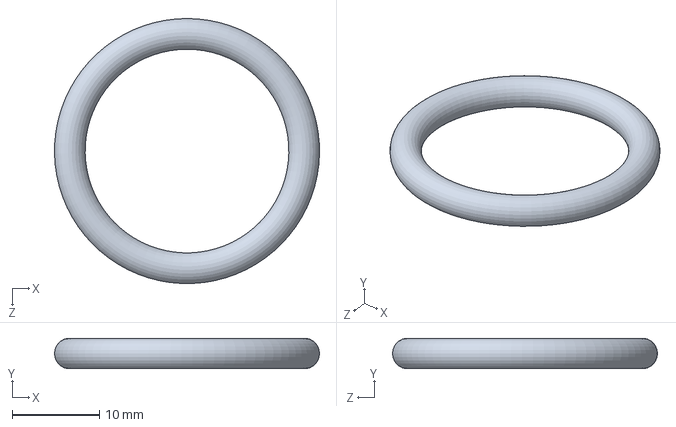
[picture p151: CAD file, 2026-10-28]
Mechanical/3D Model/KO-0234035.SLDPRT
30.5 x 3.50 x 30.4 mm
