rashadrahimzade/Smart-Viscosity-Measurement-and-Control-System-VYTRON/Mechanical/3D Model/TUBİTAK 2209-A.SLDASM

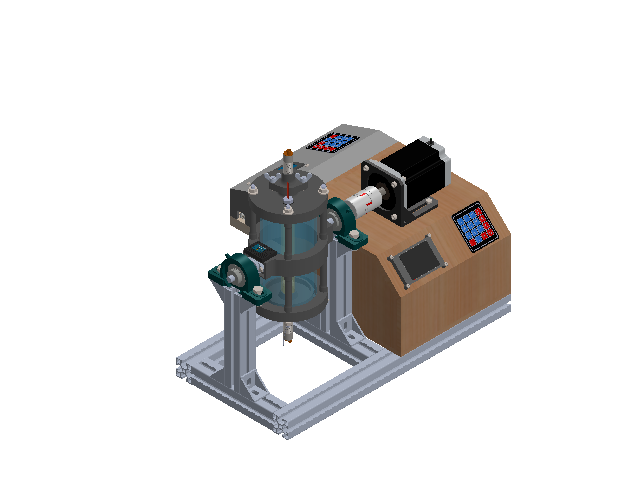
[picture p152: CAD file, 2026-10-28]
Mechanical/3D Model/TUBİTAK 2209-A.SLDASM
40x40 280 N
40x40x180 direkler N x 2
AL PROFİL BAĞLANTI N x 8
UCP-201 x 2
Al mil 91
Al Mil 110
Kelepçe N
SHF-12 x 2
Dış Cam Tüp N
Dişli Mil N x 4
KO-0329235 x 2
İç Cam Tüp N
Rezistans Yeni x 2
M5 Saplama x 4
hex nut jam_am x 10
KELEBEK SOMUN DIN 315 x 4
flat washer narrow_am x 12
hex nut style 1_am x 16
hex cap screw_am x 8
socket head cap screw_am x 6
EPDM CONTA 90x100x3 x 2
Boş Çubuk x 8
MOTOR STEPPER NEMA 34
nema_34_motor_mount
Rezistans Somun x 2
Rezistans Conta x 4
Sensor Body x 2
40x40 580 N x 2
40x40 200 N x 2
Plaka 1
Plaka arka
Plaka on
Plaka pah
plaka ust
Plaka alt x 2
DM860D
arduino_MEGA2560
Temp Sensor
Nipel
Conta Nipel x 2
Tapa
ÜST KAPAK SENSÖR
KAPAK SENSÖR N x 2
ÜST KAPAK NİPEL
KO-0234035 x 2
keypad-16KeyMembrane x 2
destek
pan cross head_am x 9
Coupling-GS-19
formed hex screw_am x 4
Bilye
Project Board Mini 170 pin x 2
MPU
Control Panel Plate
Protoboard - Deslizable
proto_400
arduinonano
Schneider MCB EZ9F34125
WELL RSP500-48 POWER SUPPLY
LCD_MSP2807_fusion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
