rashadrahimzade/Smart-Viscosity-Measurement-and-Control-System-VYTRON/(list of files, cad)

Other CAD files:
Mechanical/3D Model/ÜST KAPAK NİPEL.SLDPRT
Mechanical/3D Model/ÜST KAPAK SENSÖR.SLDPRT
Mechanical/3D Model/40x40 280 N.SLDPRT
