rashadrahimzade/Smart-Viscosity-Measurement-and-Control-System-VYTRON/Electronics/Detail_of_Parts/20x4 LCD Assembly on cover.jpeg

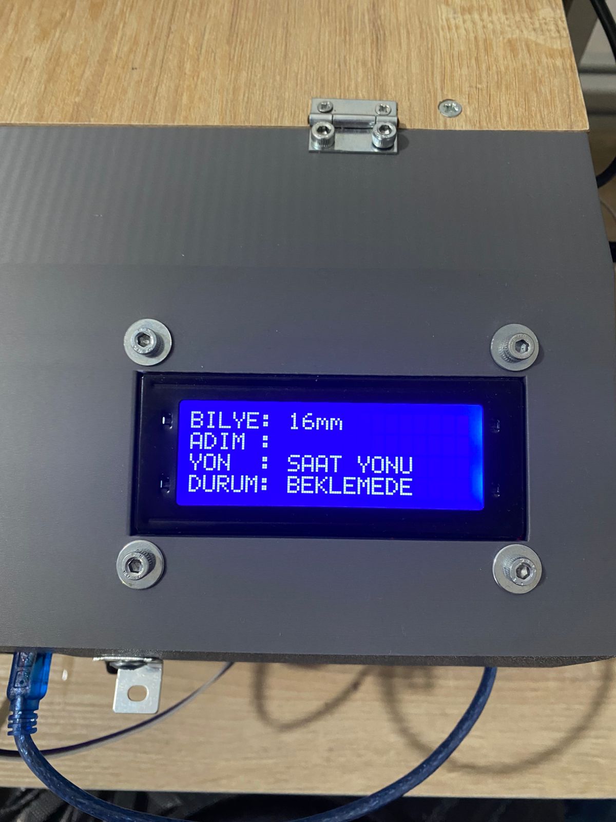
Electronics/Detail_of_Parts/20x4 LCD Assembly on cover.jpeg
