rashadrahimzade/Smart-Viscosity-Measurement-and-Control-System-VYTRON/Electronics/Detail_of_Parts/Step Motor Control interface.jpeg

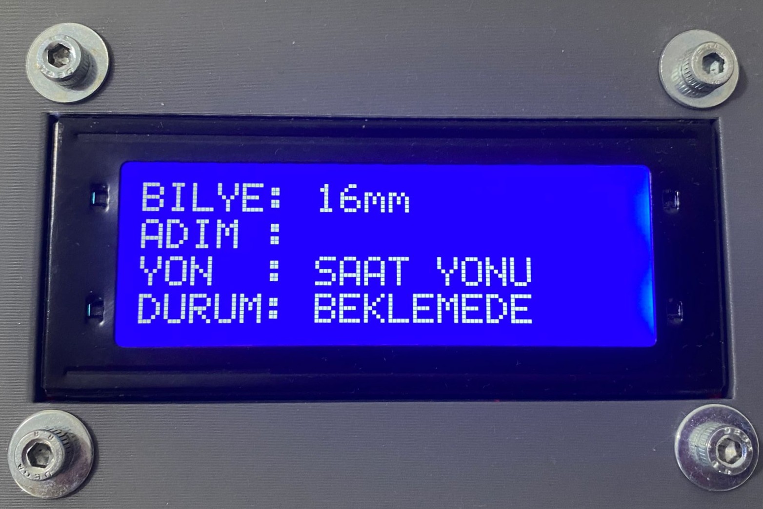
Electronics/Detail_of_Parts/Step Motor Control interface.jpeg
