rashadrahimzade/Smart-Viscosity-Measurement-and-Control-System-VYTRON/Electronics/Detail_of_Parts/Viscosity Measurement Process.jpeg

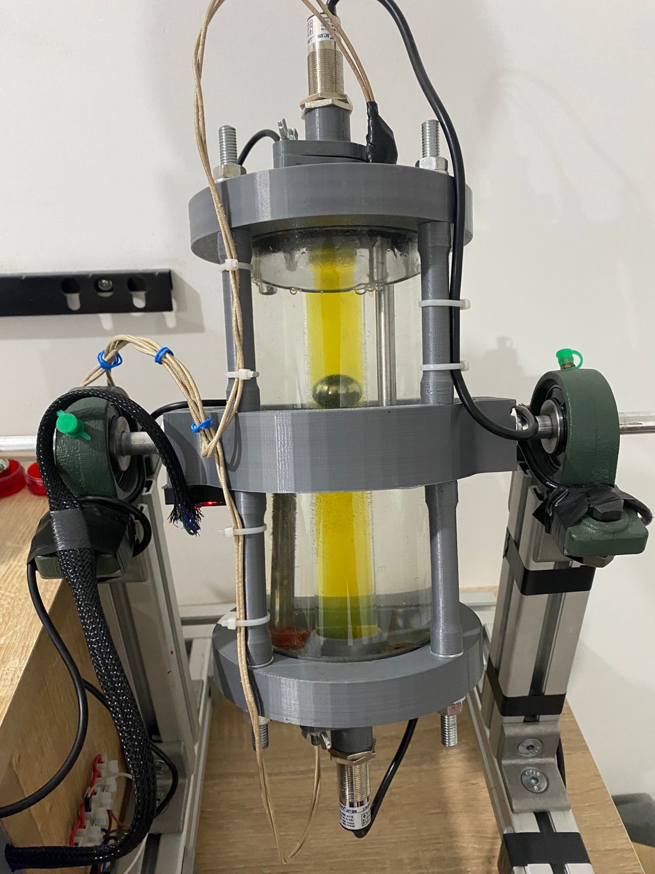
Electronics/Detail_of_Parts/Viscosity Measurement Process.jpeg
