rashadrahimzade/Smart-Viscosity-Measurement-and-Control-System-VYTRON/Mechanical/Techincal_Drawing/nema_34_motor_mount.PDF

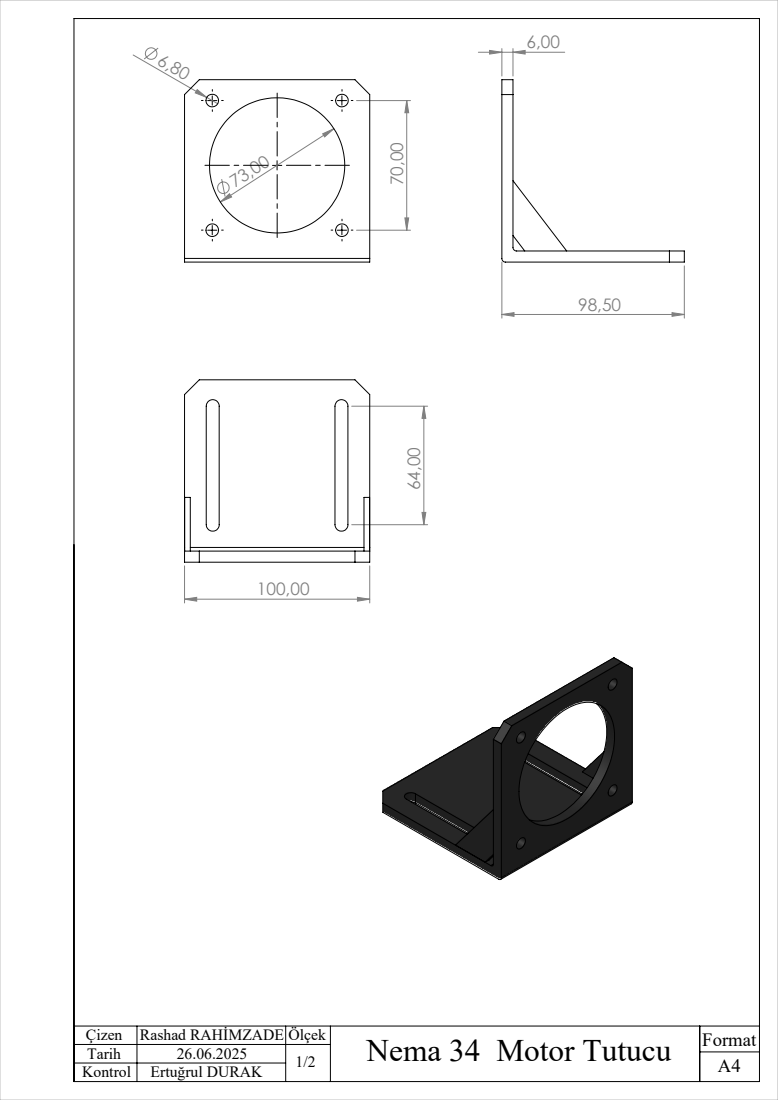
[picture p156: page 1]

Rashad RAHİMZADE | Ölçek | Nema 34 Motor Tutucu Çizen | Format
Tarih | 26.06.2025 | 1/2 Kontrol

Ertuğrul DURAK
