rashadrahimzade/Smart-Viscosity-Measurement-and-Control-System-VYTRON/Mechanical/Techincal_Drawing/40x40 200 N.PDF

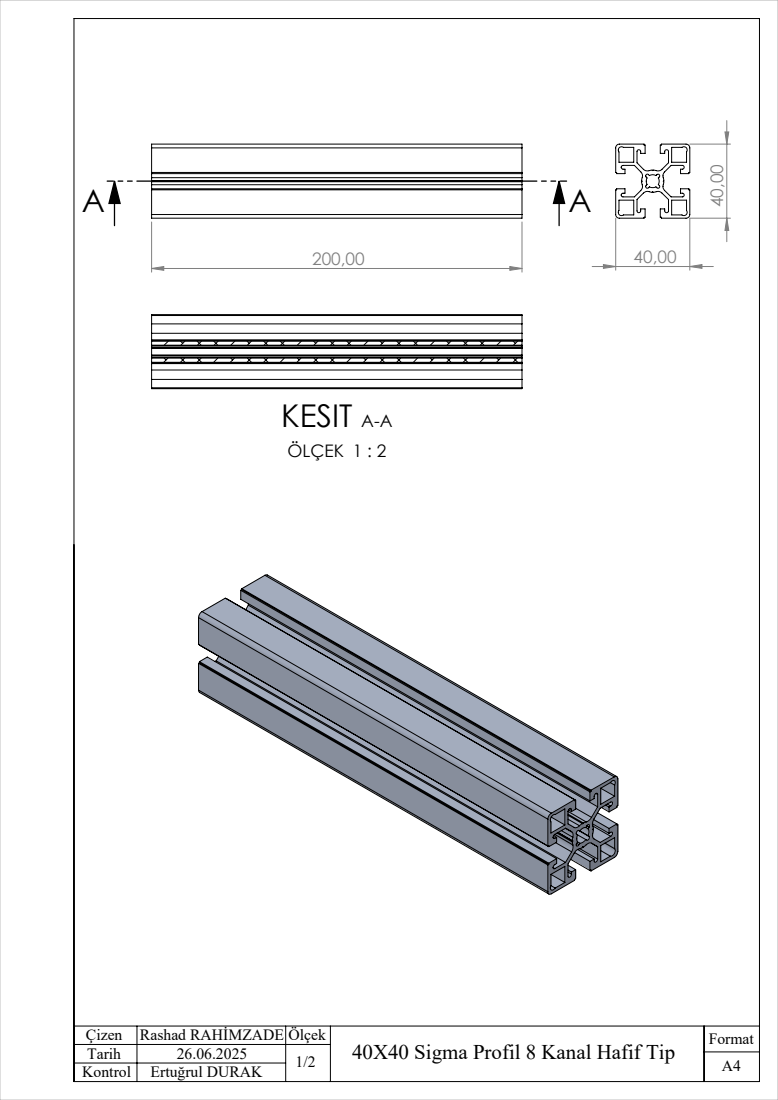
[picture p157: page 1]
KESIT A-A; ÖLÇEK 1 : 2

Çizen | Rashad RAHİMZADE | Ölçek | 40X40 Sigma Profil 8 Kanal Hafif Tip | Format
Tarih | 26.06.2025 | 1/2 Kontrol

Ertuğrul DURAK
