rashadrahimzade/Smart-Viscosity-Measurement-and-Control-System-VYTRON/Mechanical/Techincal_Drawing/ALT KAPAK N.PDF

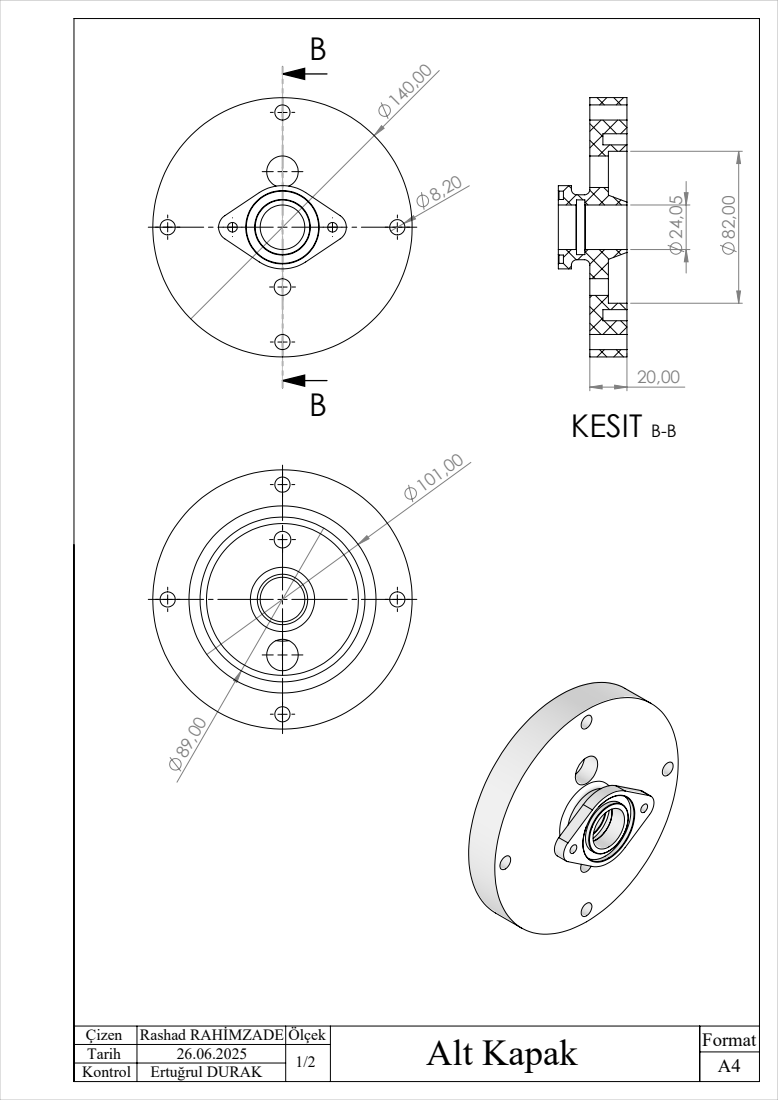
[picture p158: page 1]
KESIT B-B

Rashad RAHİMZADE | Ölçek | Alt Kapak Çizen | Format
Tarih | 26.06.2025 | 1/2 Kontrol

Ertuğrul DURAK
