rashadrahimzade/Smart-Viscosity-Measurement-and-Control-System-VYTRON/Mechanical/Techincal_Drawing/Boş Çubuk.PDF

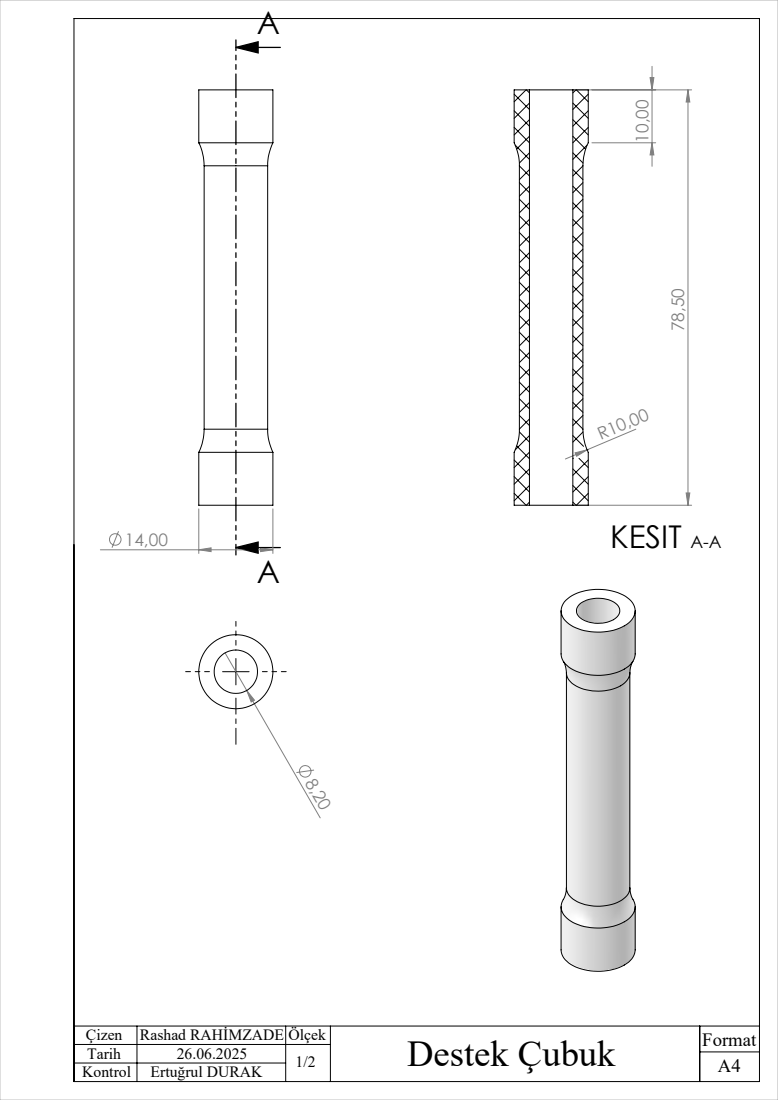
[picture p159: page 1]
KESIT A-A

Rashad RAHİMZADE | Ölçek | Destek Çubuk Çizen | Format
Tarih | 26.06.2025 | 1/2 Kontrol

Ertuğrul DURAK
