rashadrahimzade/Smart-Viscosity-Measurement-and-Control-System-VYTRON/Mechanical/Techincal_Drawing/Dış Cam Tüp N.PDF

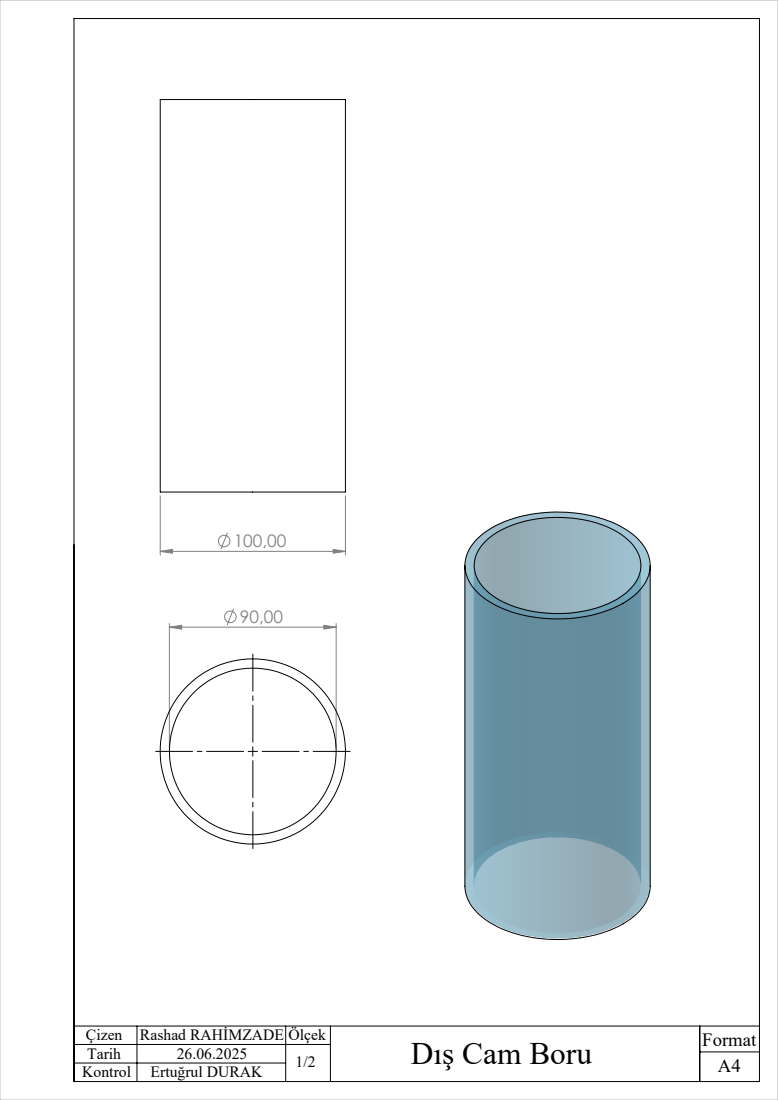
[picture p160: page 1]

Rashad RAHİMZADE | Ölçek | Dış Cam Boru Çizen | Format
Tarih | 26.06.2025 | 1/2 Kontrol

Ertuğrul DURAK
