rashadrahimzade/Smart-Viscosity-Measurement-and-Control-System-VYTRON/Mechanical/Techincal_Drawing/İç Cam Tüp N.PDF

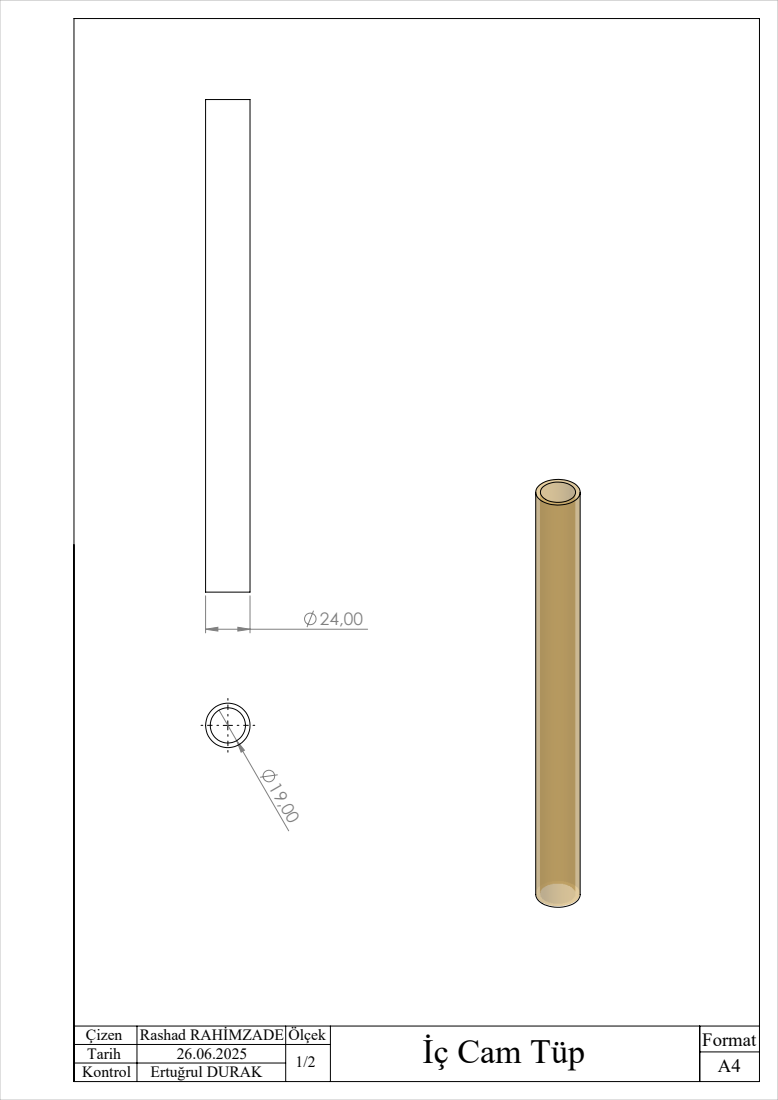
[picture p161: page 1]

Rashad RAHİMZADE | Ölçek | İç Cam Tüp Çizen | Format
Tarih | 26.06.2025 | 1/2 Kontrol

Ertuğrul DURAK
