rashadrahimzade/Smart-Viscosity-Measurement-and-Control-System-VYTRON/Mechanical/Techincal_Drawing/Kapak UST N.PDF

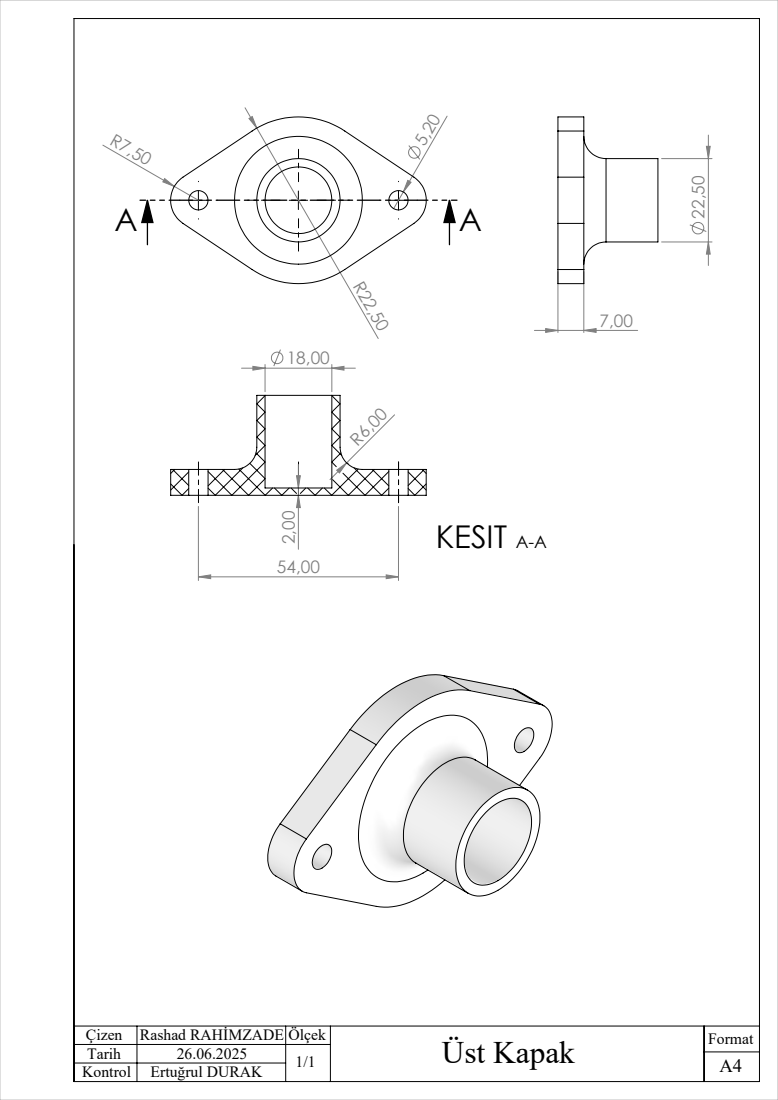
[picture p162: page 1]
KESIT A-A

Çizen | Rashad RAHİMZADE | Ölçek | Üst Kapak | Format
Tarih | 26.06.2025 | 1/1 Kontrol

Ertuğrul DURAK
