rashadrahimzade/Smart-Viscosity-Measurement-and-Control-System-VYTRON/Mechanical/Techincal_Drawing/Kelepçe N.PDF

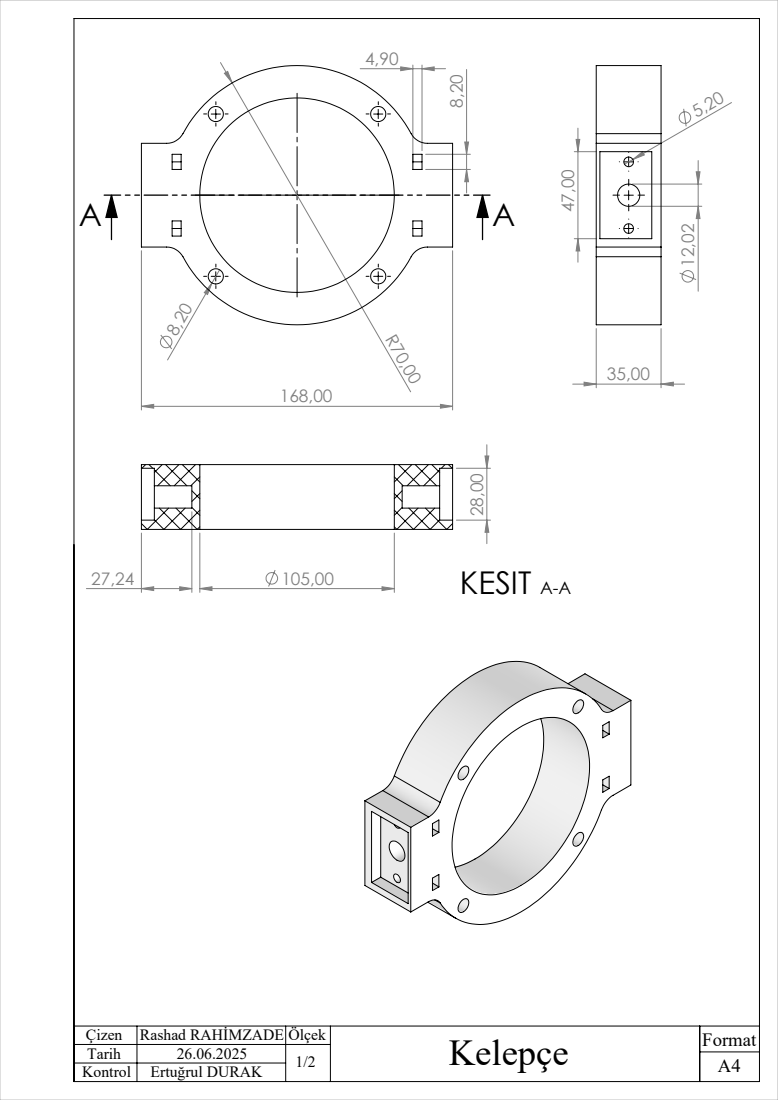
[picture p163: page 1]
KESIT A-A

Rashad RAHİMZADE | Ölçek | Kelepçe Çizen | Format
Tarih | 26.06.2025 | 1/2 Kontrol

Ertuğrul DURAK
