rashadrahimzade/Smart-Viscosity-Measurement-and-Control-System-VYTRON/Mechanical/Techincal_Drawing/Rezistans Yeni.PDF

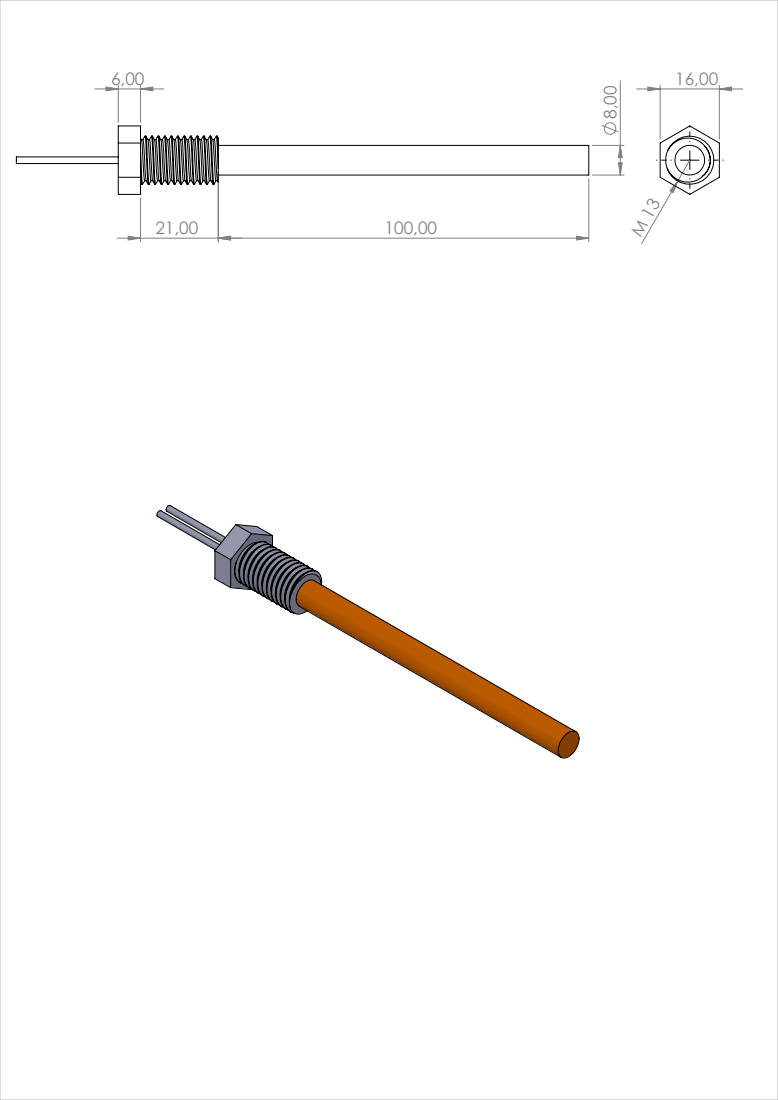
[picture p164: page 1]
