rashadrahimzade/Smart-Viscosity-Measurement-and-Control-System-VYTRON/Mechanical/Techincal_Drawing/SHF-12.PDF

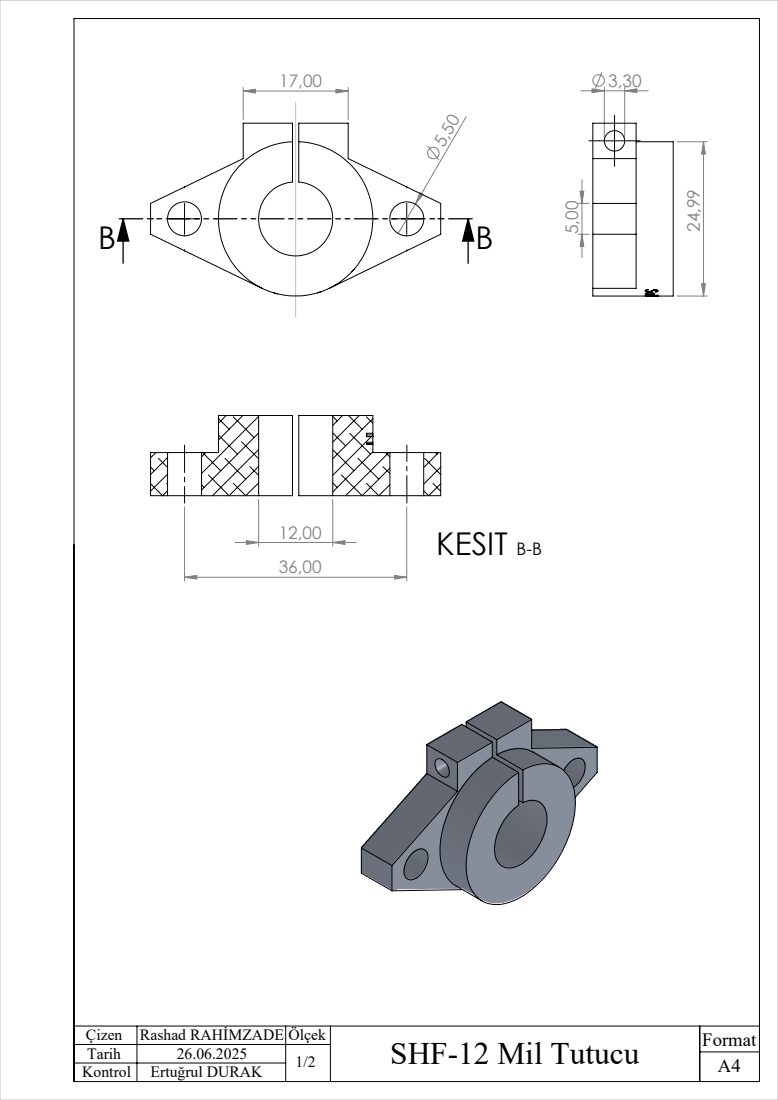
[picture p165: page 1]
KESIT B-B

Rashad RAHİMZADE | Ölçek | SHF-12 Mil Tutucu Çizen | Format
Tarih | 26.06.2025 | 1/2 Kontrol

Ertuğrul DURAK
