rashadrahimzade/Smart-Viscosity-Measurement-and-Control-System-VYTRON/Mechanical/Techincal_Drawing/UCP-201.PDF

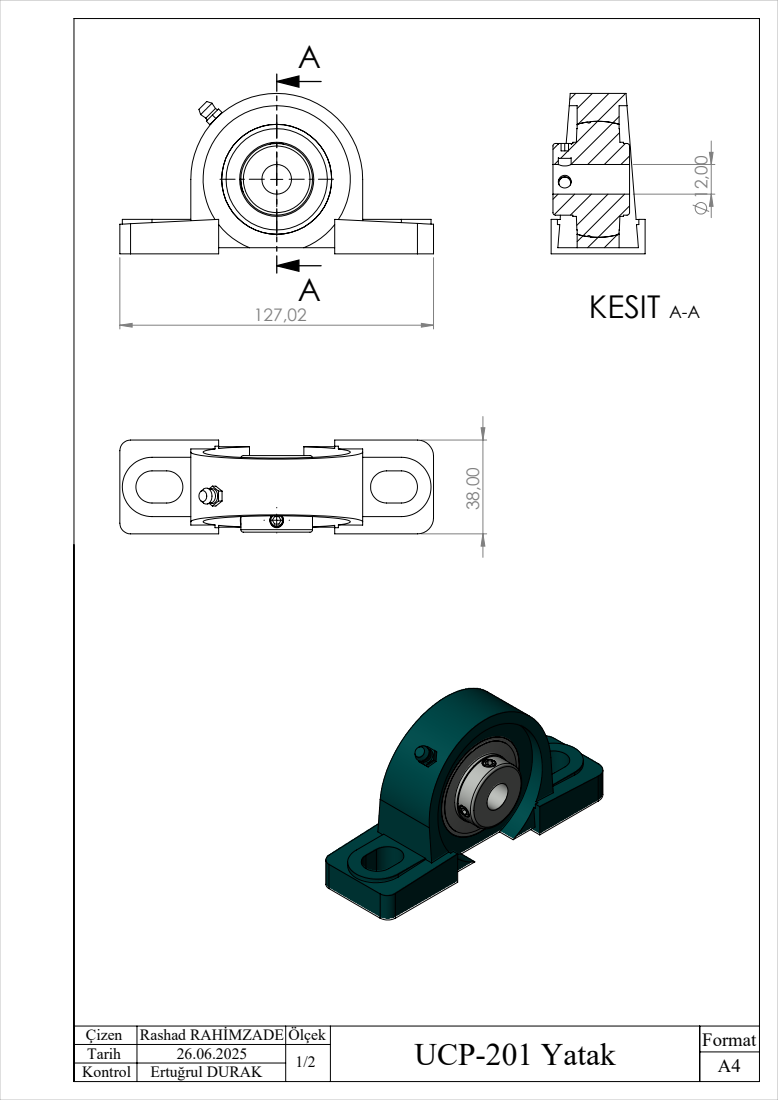
[picture p166: page 1]
KESIT A-A

Çizen | Rashad RAHİMZADE | Ölçek | UCP-201 Yatak | Format
Tarih | 26.06.2025 | 1/2 Kontrol

Ertuğrul DURAK
