rashadrahimzade/Smart-Viscosity-Measurement-and-Control-System-VYTRON/Electronics/Smart Viscosity Measurement and Control System.kicad_sch

## KiCad design Electronics/Smart Viscosity Measurement and Control System.kicad_sch (2026-11-08)

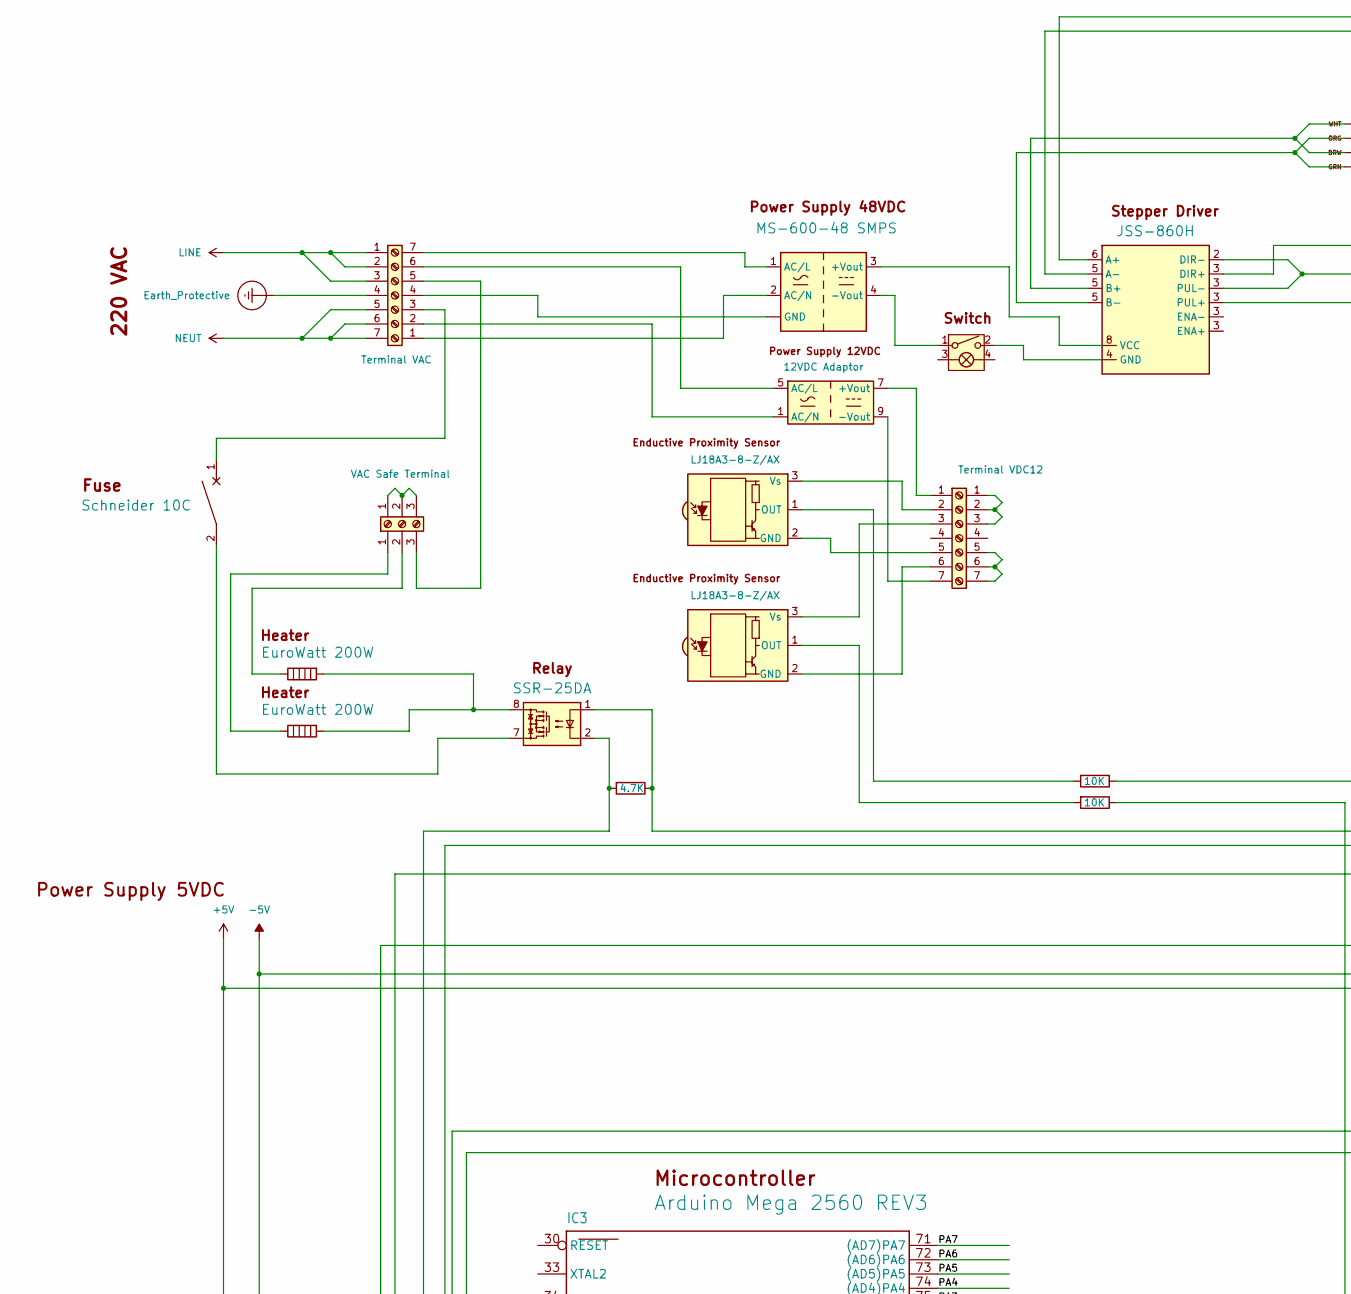
[picture p167: schematic Smart Viscosity Measurement and Control System.kicad_sch, part in row 1, column 1]

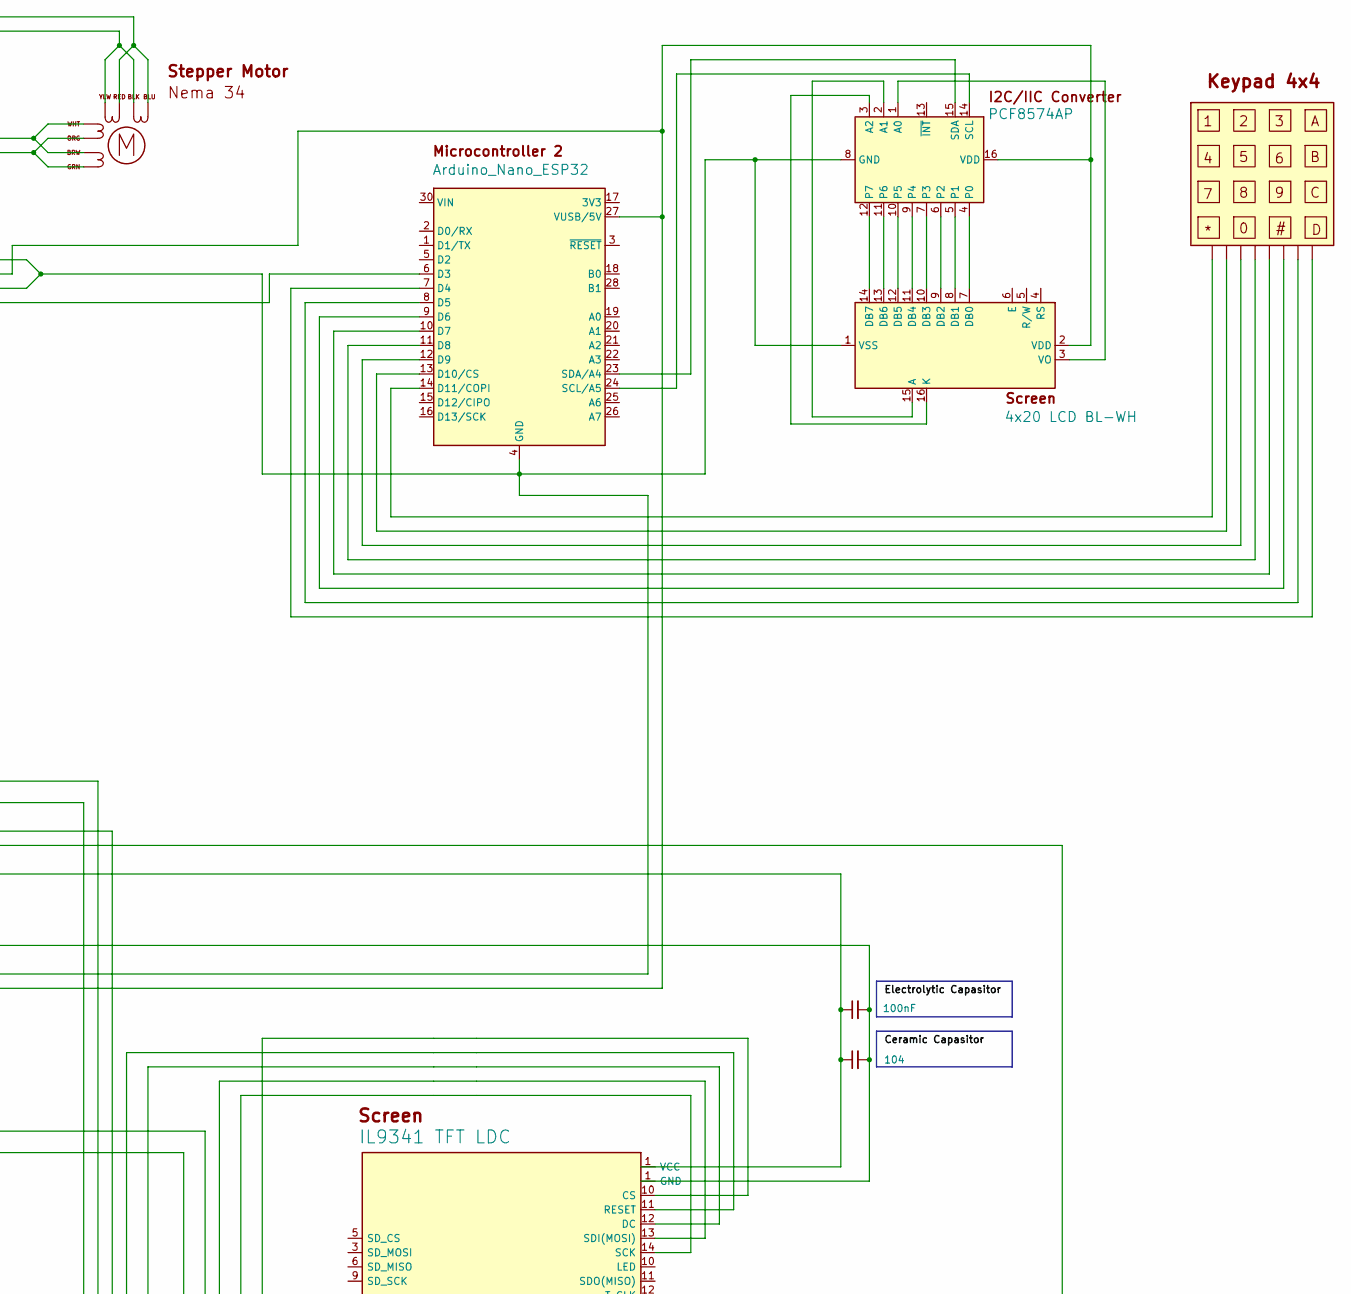
[picture p168: schematic Smart Viscosity Measurement and Control System.kicad_sch, part in row 1, column 2]

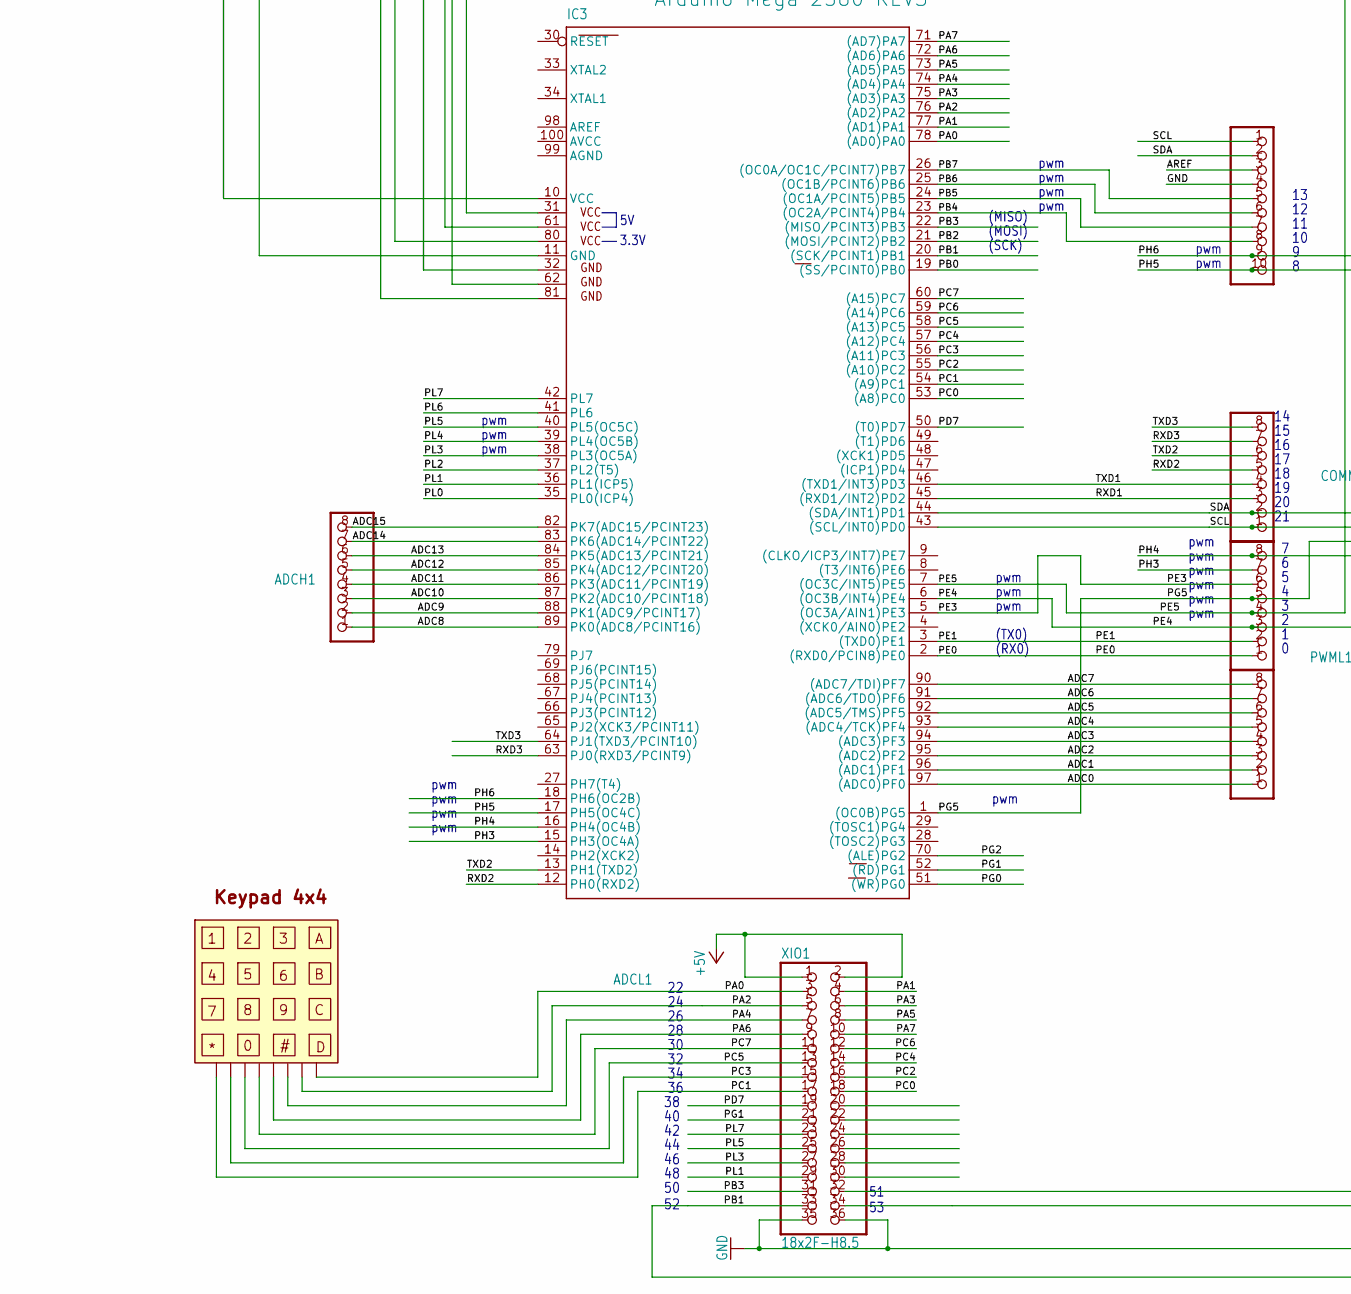
[picture p169: schematic Smart Viscosity Measurement and Control System.kicad_sch, part in row 2, column 1]

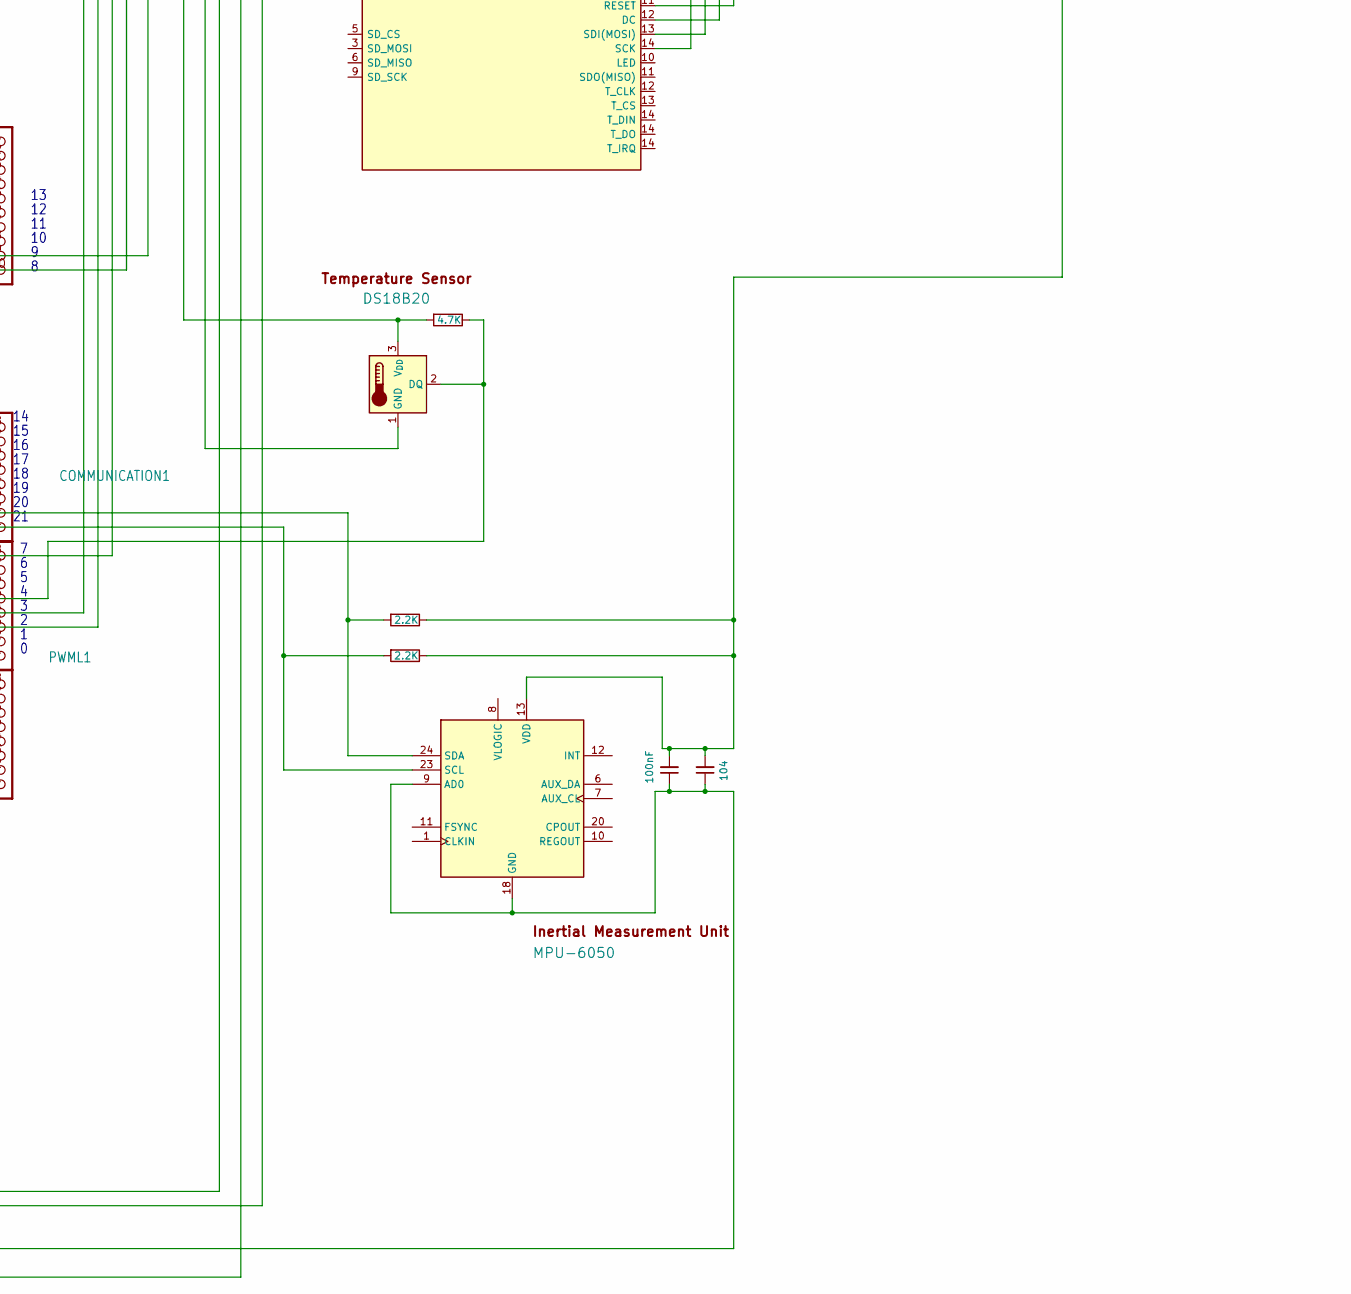
[picture p170: schematic Smart Viscosity Measurement and Control System.kicad_sch, part in row 2, column 2]

Parts:
2.2K, 4.7K, 10K: R
A1: Arduino_Nano_ESP32; Arduino_Nano
ADCH1: 8x1F-H8.5; 1X08
ADCL1: 8x1F-H8.5; 1X08
C1, C3: 100nF
C2, C4: 104
COMMUNICATION1: 8x1F-H8.5; 1X08
Fuse: Schneider 10C
Heater: EuroWatt 200W
I2C/IIC(Converter): PCF8574AP; DIP-16_W7.62mm
IC3: Arduino Mega 2560 REV3; TQFP100
J1: Terminal VAC
J2: VAC Safe Terminal
J3: Terminal VDC12
JP6: 10x1F-H8.5; 1X10
M1: Stepper_Motor_unipolar_6pin
PWML1: 8x1F-H8.5; 1X08
Relay: SSR-25DA; SOIC-8_3.81x9.347mm_P2.54mm
SW1: SW_SPST_Lamp
StepperDriver: JSS-860H; WSON-8-1EP_2x2mm_P0.5mm_EP0.9x1.6mm
TemperatureSensor: DS18B20; TO-92_Inline
U: 4x20 LCD BL-WH; NHD-0420H1Z
U2: MPU-6050; InvenSense_QFN-24_4x4mm_P0.5mm
U5, U7: LJ18A3-8-Z/AX; Vishay_MINICAST-3Pin
U6: MS-600-48 SMPS; Converter_ACDC_MeanWell_IRM-60-xx_THT
U12: IL9341 TFT LDC; CR2013-MI2120
U13, U14: GAL16V8
U15: 12VDC Adaptor; Converter_ACDC_Hahn_HS-400xx_THT
XIO1: 18x2F-H8.5; 2X18

Connections:
+5V: A1.27 (VUSB/5V), I2C/IIC(Converter).16 (VDD), IC3.10 (VCC), StepperDriver.3 (DIR+), U.2 (VDD), XIO1.1, XIO1.2
-5V: A1.4 (GND), A1.29 (GND), I2C/IIC(Converter).8 (GND), IC3.11 (GND), StepperDriver.2 (DIR-), StepperDriver.3 (DIR+), U.1 (VSS)
ADC0: ADCL1.1, IC3.97 ((ADC0)PF0)
ADC1: ADCL1.2, IC3.96 ((ADC1)PF1)
ADC2: ADCL1.3, IC3.95 ((ADC2)PF2)
ADC3: ADCL1.4, IC3.94 ((ADC3)PF3)
ADC4: ADCL1.5, IC3.93 ((ADC4/TCK)PF4)
ADC5: ADCL1.6, IC3.92 ((ADC5/TMS)PF5)
ADC6: ADCL1.7, IC3.91 ((ADC6/TDO)PF6)
ADC7: ADCL1.8, IC3.90 ((ADC7/TDI)PF7)
ADC8: ADCH1.1, IC3.89 (PK0(ADC8/PCINT16))
ADC9: ADCH1.2, IC3.88 (PK1(ADC9/PCINT17))
ADC10: ADCH1.3, IC3.87 (PK2(ADC10/PCINT18))
ADC11: ADCH1.4, IC3.86 (PK3(ADC11/PCINT19))
ADC12: ADCH1.5, IC3.85 (PK4(ADC12/PCINT20))
ADC13: ADCH1.6, IC3.84 (PK5(ADC13/PCINT21))
ADC14: ADCH1.7, IC3.83 (PK6(ADC14/PCINT22))
ADC15: ADCH1.8, IC3.82 (PK7(ADC15/PCINT23))
AREF: JP6.3
Earth_Protective: J1.4
GND: C3.1, C4.1, JP6.4, U2.9 (AD0), U2.18 (GND), XIO1.35, XIO1.36
LINE: J1.1, J1.2, J1.3
NEUT: J1.5, J1.6, J1.7
unnamed: 2.2K.1, C3.2, C4.2, IC3.61 (VCC2), U2.13 (VDD)
unnamed: 4.7K.2, IC3.31 (VCC1), IC3.32 (GND1), Relay.2, TemperatureSensor.3 (V_{DD})
unnamed: 10K.2, U5.1 (OUT), U7.1 (OUT)
unnamed: A1.6 (D3), StepperDriver.3 (DIR+)
unnamed: A1.7 (D4), U13.
unnamed: A1.8 (D5), U13.
unnamed: A1.9 (D6), U13.
unnamed: A1.10 (D7), U13.
unnamed: A1.11 (D8), U13.
unnamed: A1.12 (D9), U13.
unnamed: A1.13 (D10/CS), U13.
unnamed: A1.14 (D11/COPI), U13.
unnamed: A1.23 (SDA/A4), I2C/IIC(Converter).15 (SDA)
unnamed: A1.24 (SCL/A5), I2C/IIC(Converter).14 (SCL)
unnamed: C1.1, C2.1, IC3.80 (VCC3), U12.1 (VCC)
unnamed: C1.2, C2.2, IC3.81 (GND3), U12.1 (VCC)
unnamed: Fuse.1, J1.3
unnamed: Fuse.2, Relay.7
unnamed: Heater.1, J2.1, J2.2
unnamed: Heater.2, Relay.8
unnamed: I2C/IIC(Converter).1 (A0), U.3 (VO)
unnamed: I2C/IIC(Converter).2 (A1), U.15 (A)
unnamed: I2C/IIC(Converter).3 (A2), U.16 (K)
unnamed: I2C/IIC(Converter).4 (P0), U.7 (DB0)
unnamed: I2C/IIC(Converter).5 (P1), U.8 (DB1)
unnamed: I2C/IIC(Converter).6 (P2), U.9 (DB2)
unnamed: I2C/IIC(Converter).7 (P3), U.10 (DB3)
unnamed: I2C/IIC(Converter).9 (P4), U.11 (DB4)
unnamed: I2C/IIC(Converter).10 (P5), U.12 (DB5)
unnamed: I2C/IIC(Converter).11 (P6), U.13 (DB6)
unnamed: I2C/IIC(Converter).12 (P7), U.14 (DB7)
unnamed: IC3.62 (GND2), TemperatureSensor.1 (GND)
unnamed: J1.1, U6.2 (AC/N)
unnamed: J1.2, U15.1 (AC/N)
unnamed: J1.4, U6. (GND)
unnamed: J1.5, J2.3
unnamed: J1.6, U15.5 (AC/L)
unnamed: J1.7, U6.1 (AC/L)
unnamed: J2.1, J2.2, J2.3
unnamed: J3.1, J3.2, J3.3, U15.7 (+Vout)
unnamed: J3.2, U5.3 (Vs)
unnamed: J3.3, U7.3 (Vs)
unnamed: J3.5, J3.6, J3.7, U5.2 (GND)
unnamed: J3.6, U7.2 (GND)
unnamed: J3.7, U15.9 (-Vout)
unnamed: M1., StepperDriver.5 (A-), StepperDriver.6 (A+)
unnamed: SW1.1, U6.4 (-Vout)
unnamed: SW1.2, StepperDriver.4 (GND)
unnamed: StepperDriver.8 (VCC), U6.3 (+Vout)
unnamed: U12.10 (CS), XIO1.34
unnamed: U12.13 (SDI(MOSI)), XIO1.32
PA0: IC3.78 ((AD0)PA0), U14., XIO1.3
PA1: IC3.77 ((AD1)PA1), XIO1.4
PA2: IC3.76 ((AD2)PA2), U14., XIO1.5
PA3: IC3.75 ((AD3)PA3), XIO1.6
PA4: IC3.74 ((AD4)PA4), U14., XIO1.7
PA5: IC3.73 ((AD5)PA5), XIO1.8
PA6: IC3.72 ((AD6)PA6), U14., XIO1.9
PA7: IC3.71 ((AD7)PA7), XIO1.10
PB0: IC3.19 ((SS/PCINT0)PB0)
PB1: IC3.20 ((SCK/PCINT1)PB1), U12.14 (SCK), XIO1.33
PB2: IC3.21 ((MOSI/PCINT2)PB2)
PB3: IC3.22 ((MISO/PCINT3)PB3), XIO1.31
PB4: IC3.23 ((OC2A/PCINT4)PB4), JP6.8
PB5: IC3.24 ((OC1A/PCINT5)PB5), JP6.7
PB6: IC3.25 ((OC1B/PCINT6)PB6), JP6.6
PB7: IC3.26 ((OC0A/OC1C/PCINT7)PB7), JP6.5
PC0: IC3.53 ((A8)PC0), XIO1.18
PC1: IC3.54 ((A9)PC1), U14., XIO1.17
PC2: IC3.55 ((A10)PC2), XIO1.16
PC3: IC3.56 ((A11)PC3), U14., XIO1.15
PC4: IC3.57 ((A12)PC4), XIO1.14
PC5: IC3.58 ((A13)PC5), U14., XIO1.13
PC6: IC3.59 ((A14)PC6), XIO1.12
PC7: IC3.60 ((A15)PC7), U14., XIO1.11
PD7: IC3.50 ((T0)PD7), XIO1.19
PE0: IC3.2 ((RXD0/PCIN8)PE0), PWML1.1
PE1: IC3.3 ((TXD0)PE1), PWML1.2
PE3: IC3.5 ((OC3A/AIN1)PE3), PWML1.6
PE4: 10K.1, IC3.6 ((OC3B/INT4)PE4), PWML1.3
PE5: 10K.1, IC3.7 ((OC3C/INT5)PE5), PWML1.4
PG0: IC3.51 ((WR)PG0)
PG1: IC3.52 ((RD)PG1), XIO1.21
PG2: IC3.70 ((ALE)PG2)
PG5: 4.7K.1, IC3.1 ((OC0B)PG5), PWML1.5, TemperatureSensor.2 (DQ)
PH3: IC3.15 (PH3(OC4A)), PWML1.7
PH4: 4.7K.1, IC3.16 (PH4(OC4B)), PWML1.8, Relay.1
PH5: IC3.17 (PH5(OC4C)), JP6.10, U12.11 (RESET)
PH6: IC3.18 (PH6(OC2B)), JP6.9, U12.12 (DC)
PL0: IC3.35 (PL0(ICP4))
PL1: IC3.36 (PL1(ICP5)), XIO1.29
PL2: IC3.37 (PL2(T5))
PL3: IC3.38 (PL3(OC5A)), XIO1.27
PL4: IC3.39 (PL4(OC5B))
PL5: IC3.40 (PL5(OC5C)), XIO1.25
PL6: IC3.41 (PL6)
PL7: IC3.42 (PL7), XIO1.23
RXD1: COMMUNICATION1.3, IC3.45 ((RXD1/INT2)PD2)
RXD2: COMMUNICATION1.5, IC3.12 (PH0(RXD2))
RXD3: COMMUNICATION1.7, IC3.63 (PJ0(RXD3/PCINT9))
SCL: 2.2K.2, COMMUNICATION1.1, IC3.43 ((SCL/INT0)PD0), JP6.1, U2.23 (SCL)
SDA: 2.2K.2, COMMUNICATION1.2, IC3.44 ((SDA/INT1)PD1), JP6.2, U2.24 (SDA)
TXD1: COMMUNICATION1.4, IC3.46 ((TXD1/INT3)PD3)
TXD2: COMMUNICATION1.6, IC3.13 (PH1(TXD2))
TXD3: COMMUNICATION1.8, IC3.64 (PJ1(TXD3/PCINT10))

Notes on the sheet:
pwm
(MOSI)
(TX0)
3.3V
(RX0)
(SCK)
(MISO)
