rashadrahimzade/Smart-Viscosity-Measurement-and-Control-System-VYTRON/(commit log)

2026-05-03 Create Arduino MEGA 2560 REV3
    This commit includes the primary source code for the Arduino Mega 2560, handling sensor data processing, viscosity calculations, and the user interface
2026-05-03 Create Arduino Nano
    This commit includes the firmware for the Arduino Nano, which functions as the dedicated motor controller. It manages stepper motor acceleration, deceleration, and precise ball release sequences using the AccelStepper library to ensure measurement consistency.
2026-05-03 Add electrical schematics (KiCAD)
    This file contains the complete electrical circuit design created in KiCAD. It includes the wiring for the dual-microcontroller system, sensor interfaces (Inductive and Temperature), EMI filtering stages, and the stepper motor driver power distribution.
    [Smart Viscosity Measurement and Control System.kicad_sch]
2026-05-03 kiCad schematic
    High-resolution circuit schematic of the smart viscometer. This diagram illustrates the integration of the dual-microcontroller system, sensor wiring, EMI suppression stages, and the power management unit for the stepper motor.
2026-10-28 Add core project files (Mechanical CAD, Software, and Electronics)
    Initial commit featuring 3D CAD models, embedded C++ code for dual microcontrollers (Arduino Mega & Nano), and electronic circuit schematics for the system.
    [40x40 200 N.SLDPRT, 40x40 280 N.SLDPRT, 40x40 580 N.SLDPRT, 40x40x180 direkler N.SLDPRT, AL PROFİL BAĞLANTI N.SLDPRT, ALT KAPAK N.SLDPRT, Al Mil 110.SLDPRT, Al mil 91.SLDPRT]
2026-10-28 Electronic schematics and part names
    Photos and graph
    [Electronic parts.xlsx]
2026-11-08 Update Smart Viscosity Measurement and Control System.kicad_sch
    [Smart Viscosity Measurement and Control System.kicad_sch]
2026-11-09 .
    .
    [BOM_Mechanic_VYTRON.xlsx]
2026-11-12 Cad prototype
