rashadrahimzade/Smart-Viscosity-Measurement-and-Control-System-VYTRON/(notices)

Notices in the files:
README.md:
License: All Rights Reserved
